DJLIMA1/FIAP-ChargeGridApp-GS1-2026/docs/api.md

# API ChargeGrid v1

Base `/v1`, JSON, UUIDs e datas UTC ISO 8601. Bearer JWT de pessoa nas rotas de domínio, logout e alteração de senha; cadastro, login, refresh, solicitação de recuperação e verificação por código são públicos com limite de tentativas. Sync usa `Authorization: Device <chave>`. Erro: `{"error":{"code":"point_unavailable","message":"Ponto indisponível"}}`. Validação retorna 422. Respostas de listas: `{"items":[],"total":0,"limit":50,"offset":0}`. `GET .../current` retorna recurso ou `null`.

Auth: POST `/auth/register` {email,password,name,account_type?:"consumer"|"vendor"}; `/auth/login` {email,password}; `/auth/refresh` {refresh_token}; `/auth/logout` com Bearer. O tipo de conta é escolhido no cadastro e o padrão para clientes antigos é `consumer`; login não recebe tipo. Cadastro novo sem confirmação pendente, login e refresh retornam `{access_token,refresh_token,expires_in,token_type:"bearer",user:{id,email}}`. Cadastro inclui `requires_email_confirmation`, calculado conforme a resposta do provedor: `false` com sessão imediata, `true` quando a conta depende de confirmação. Cadastro de e-mail já existente recebe resposta neutra sem sessão, sem afirmar que uma mensagem foi enviada. Senhas são preservadas exatamente, inclusive espaços; cadastro e nova senha exigem 8–128 caracteres, login aceita 1–128 para compatibilidade com contas legadas. O provedor pode recusar senhas fracas. Os endpoints `/auth/verify-email` e `/auth/resend-signup` permanecem compatíveis, embora o projeto atual não exija confirmação.

Recuperação: POST `/auth/password/forgot` {email} solicita e-mail com link; `/auth/password/reset` {email,code,password} mantém suporte a código OTP. O link padrão abre `/auth/confirmed`, fora da base `/v1`, que apresenta o formulário quando recebe `type=recovery` e o token no fragmento da URL. A página remove o fragmento imediatamente, mantém o token apenas em memória e chama POST `/auth/password/update` {password} com Bearer válido. Ambos os fluxos de redefinição revogam as sessões de atualização no provedor e pedem novo login. Tokens de acesso já emitidos podem permanecer válidos até sua expiração. A entrega de e-mail ainda depende do SMTP configurado no Supabase; indisponibilidade ou limite do provedor retornam erro, não uma confirmação falsa de envio.

`GET/PATCH /me`: `{id,name,account_type,phone,vehicle_description,operator_enabled,presentation_mode,created_at}`; PATCH aceita apenas name,phone,vehicle_description,presentation_mode. `presentation_mode` (bool, padrão `false`) é o *Modo apresentação* da conta, sincronizado pelo app ao alternar; no servidor ele só decide o método de pagamento do totem dos postos dessa conta (veja [Totem](#totem-de-autoatendimento-dispositivo)). `account_type` é persistido no primeiro acesso a partir dos metadados do cadastro e não é alterado por logins posteriores. Escolher `vendor` permite iniciar o vínculo por QR; somente a prova de posse de um equipamento habilita `operator_enabled`. Vendedores ainda sem equipamento podem usar recargas. Operadores e proprietários legados são preservados. `GET /me/summary`: `{month:"YYYY-MM",currency:"BRL",estimated_cost,energy_wh,sessions_count}` para sessões encerradas com carga no mês civil de São Paulo; custo é estimativa, não pagamento.

`GET /stations` filtros lat,lng,radius_km,limit,offset; `GET /stations/{id}`. Posto: `{id,owner_id,name,address,latitude,longitude,active,connectors:[]}`. `owner_id` pode ser null somente para equipamento de fábrica sem dono, que permanece inativo. Ponto: `{id,station_id,public_code,connector_type,power_kw,price_per_kwh,max_duration_minutes,active,control_version,available,online,physical_state,availability_status,reserved_until}`. `availability_status` usa `available`, `reserved`, `charging`, `offline`, `reconciling`, `disabled`, `fault` ou `occupied`; clientes não devem chamar todo ponto indisponível de ocupado.

A descoberta também aceita `connector_type`, `available_only` (padrão `false`), `max_price_per_kwh` (0 a 10000) e `sort=default|price|distance`. Distância exige `lat` e `lng` juntos e é calculada em linha reta, não como rota. Tipo de conector ignora caixa/separadores e reconhece aliases como `Tipo 2`/`Type-2` e `CCS`/`CCS2`. Filtros e ordenação são aplicados antes de `limit`/`offset`.

Cada item da listagem acrescenta `discovery: {point, matching_connector_ids, available_points, distance_km}`. `point` é o ponto elegível de menor tarifa no posto, ou `null` quando não há ponto elegível. Preço, potência, conector e estado apresentados em uma comparação devem vir desse mesmo ponto. O campo `connectors` original permanece completo; `matching_connector_ids` identifica quais atendem à comparação. Sem `available_only`, um ponto ocupado/offline pode ter a menor tarifa e deve manter seu estado explícito. `available_only` usa o estado reconciliado do serviço, não apenas a presença de um sinal recente. A disponibilidade continua sendo revalidada nas operações de reserva/início.

Consultas padrão e por distância sem filtros adicionais preservam paginação SQL. Comparações por tarifa/disponibilidade avaliam os estados dos candidatos após restringir os atributos estáticos no SQL; o custo cresce com a quantidade de pontos candidatos. Essa implementação atende o piloto, mas requer medição e otimização antes de expandir para catálogos grandes.
POST `/stations` {name,address,latitude,longitude} cria apenas um agrupamento do vendedor habilitado; PATCH aceita esses campos e active. POST `/stations/{id}/connectors` não cria mais equipamentos: responde 409 `claim_required`, orientando o vínculo por QR. PATCH `/connectors/{id}` mantém edição dos campos e active, apenas pelo proprietário e sem operação ativa.

## Propriedade por QR de fábrica

POST `/ownership/claim` {token,station_id?:UUID}, com Bearer de vendedor ou operador legado. `token` é o segredo aleatório base64url de 43 caracteres contido em `chargegrid://claim?token=...`; não é `public_code`, UUID nem chave de dispositivo. Resposta 200: `{station_id,connector_id,already_claimed,message}`. O segredo é enviado no corpo HTTPS, nunca na URL HTTP ou em logs.

O provisionamento administrativo cria um ponto com chave de dispositivo própria e um segredo de propriedade independente. O banco guarda somente SHA-256 dos dois. A primeira claim vincula o posto de fábrica ao vendedor ou, quando `station_id` é informado, adiciona o ponto a um posto que já pertence à mesma pessoa. Essa operação habilita a gestão do vendedor por prova de posse. Posto/ponto novos continuam inativos até revisão e ativação pelo dono. O QR deve ser entregue ao comprador, não publicado como QR de recarga.

Claims concorrentes são serializadas: mesmo dono pode repetir com segurança (`already_claimed:true`); outro dono recebe 409 `already_owned`. Um QR usado não transfere o ponto para outro posto (409 `already_claimed`), nem altera proprietários legados. Consumidor recebe 403 `vendor_required`; segredo desconhecido recebe 404 `invalid_claim`; posto de destino alheio recebe 404. Há limite persistente de 15 tentativas por usuário/minuto, inclusive falhas (429). Respostas públicas não incluem claim, token ou hash.

POST `/connectors/{id}/device`, `/devices/{id}/rotate-key`: `{device_id,device_key}` chave mostrada uma vez. POST `/devices/{id}/revoke`: `{revoked:true}`.

GET `/connectors/{id}/device`, exclusivo do proprietário habilitado do posto: `{device_id,connector_id,firmware_version,last_seen,online,physical_state,connected,reconciled}`. Permite reencontrar o dispositivo para manutenção, rotação ou revogação depois de fechar a tela; nunca devolve chave, hash ou segredo de propriedade. Retorna 404 quando não existe dispositivo ativo, inclusive após revogação, ou quando o ponto pertence a outro operador; consumidores e vendedores sem equipamento vinculado recebem 403. Provisionar/rotacionar uma chave de comunicação não muda o dono do ponto.

GET `/devices/{id}/factory-reset` consulta o estado da restauração, inclusive durante uma reserva/recarga, sem alterar o dispositivo. POST na mesma rota solicita a restauração e continua exigindo equipamento livre, online e firmware compatível. Comando expirado permite reativar o ponto ou renovar a credencial; um novo sync livre confirma sua disponibilidade. ACK tardio não executa a restauração. Restauração aplicada mantém o ponto antigo aposentado e exige novo vínculo por QR.

POST `/reservations` {connector_id}, header `Idempotency-Key` obrigatório; 202 reserva `{id,user_id,connector_id,status,created_at,confirmation_deadline,expires_at}`. Estados pending_device,confirmed,cancelling,cancelled,expired,consumed. GET `/reservations/current`; POST `/reservations/{id}/cancel` 202 mesma representação.

Todas as representações de reserva e sessão (criação, consulta individual/atual, cancelamento/parada e itens de histórico) incluem também `{station_id,station_name,station_address,connector:{id,public_code,connector_type,power_kw,price_per_kwh,max_duration_minutes}}`. Esse contexto usa os dados públicos atuais do ponto/posto e não inclui dono, dispositivo, chave, hash ou segredo. A tarifa contratada continua no `price_per_kwh` da sessão; a tarifa do ponto no contexto pode mudar depois. As rotas `/current` reconciliam expiração antes de retornar o estado e devolvem `null` se a operação deixou de estar ativa enquanto aguardavam o lock.

POST `/charging-sessions` {presence_code,public_code?:string,reservation_id?:UUID,coupon_code?:string,max_duration_minutes:30,max_cost?:decimal,soc_percent?:0–100,battery_kwh?:5–250,soc_source?:"simulated"|"phone"} Idempotency-Key obrigatório; 202 sessão. `presence_code` tem formato `#F` seguido de cinco dígitos, é exibido apenas no painel físico, muda a cada cinco minutos e é validado pela API no início da recarga. A reserva ou o `public_code` opcional identificam o ponto quando já foi selecionado; sem eles, a API procura o código temporário entre os postos e exige que o ponto disponível seja único. Código inválido, vencido ou ambíguo retorna 422; há limite de dez tentativas por usuário a cada cinco minutos. POST `/charging-sessions/{id}/stop` mesmo header, 202. GET `/charging-sessions/current`, `/{id}`, `/me/charging-sessions`, `/stations/{id}/charging-sessions` (proprietário). Sessão: `{id,user_id,connector_id,reservation_id,status,created_at,started_at,ended_at,max_duration_minutes,max_cost,price_per_kwh,discount_percent,energy_wh,soc_percent,start_soc_percent,battery_kwh,soc_source,source,last_measurement_at,cost_estimate,end_reason,online}`. Históricos são ordenados por `created_at` decrescente, com UUID apenas para desempate; registros antigos usam início/fim conhecido como data de criação aproximada. Estados starting,charging,stopping,completed,failed,interrupted. Uma tentativa que nunca iniciou termina como `failed`; reinicialização após início termina como `interrupted`. SoC ausente é null. GET `/operator/summary`: `{stations,total_sessions,total_energy_wh,total_estimated_cost}`.

GET `/operator/charging-sessions` lista o histórico de todos os postos do operador autenticado, com `limit`/`offset`, envelope paginado e a mesma representação contextual de sessão. Exige operador habilitado e filtra exclusivamente seus postos, em ordem decrescente de criação. Aqui e em `GET /stations/{id}/charging-sessions` (visões do vendedor), o `payment` da sessão ganha `channel` (`app` | `kiosk_qr` | `kiosk_totem`), como em `/owner/sessions`; o histórico do motorista (`/me/charging-sessions`) não muda.

GET `/coupons` filtro station_id; com `mine=true` (gestão do dono) cada cupom traz também `uses` (recargas iniciadas com o código nos postos do dono, sem as que falharam), `last_used_at` (início da mais recente ou null) e `discount_total_approx` (kWh × preço × % somados, string decimal; aproximado, sem o arredondamento do recibo). POST `/coupons/check` {code, connector_id} (motorista, antes de pagar/iniciar; 10 tentativas por 5 min → 429 `rate_limited`) → `{code, discount_percent, description, valid_until, station_id}` ou 422 `invalid_coupon` (mesma regra do início: ativo, não vencido, do dono do posto e válido para o posto), 404 se o ponto não existe; só mostra o desconto, que continua aplicado e travado pela API no `POST /payments` (`coupon_code`) ou no início. POST `/coupons` {code,description,discount_percent,station_id?:UUID,valid_until}; PATCH `/coupons/{id}` aceita description,discount_percent,valid_until,active. Cupom global vale somente nos postos de seu operador. Criar, alterar a validade ou reativar um cupom exige validade futura com fuso horário. Editar descrição/desconto ou desativar cupom vencido continua permitido sem reenviar a validade; campos omitidos permanecem intactos. Valores monetários serializados como strings decimais; nenhum pagamento real.

Idempotência reserva/início/parada: mesmo usuário/operação/chave/corpo devolve recurso original; corpo diferente retorna 409. Cancelamento é naturalmente idempotente. Sem contato por 45s proíbe novas autorizações. Reserva vence chegada 15 minutos após ACK (`RESERVATION_MINUTES`, o mesmo prazo exibido no app), confirmação 30s; expiração inicia liberação, disponibilidade só retorna após reconciliação física. Reiniciar o ESP32 não cancela uma reserva válida: a API reaplica a reserva com seu prazo original, sem estender o vencimento. Isso é diferente de uma recarga em andamento, que é interrompida com segurança após reboot.

## Bateria do carro (SoC) e bateria cheia

No início, `soc_percent` (SoC inicial do carro), `battery_kwh` (capacidade útil) e `soc_source` são opcionais; `soc_source` assume `simulated` quando só o SoC é informado. A sessão guarda `start_soc_percent` (fixo), `soc_percent` (atual, decimal string ou null), `battery_kwh` e `soc_source`. Clientes antigos sem esses campos continuam iguais (todos null). A chave de idempotência do início considera esses campos quando enviados.

- `simulated`: a cada medição do equipamento a API calcula `soc_percent = min(100, start_soc_percent + energy_wh/1000/battery_kwh*100)`; um SoC enviado pelo próprio equipamento prevalece.
- `phone` (Modo apresentação): POST `/charging-sessions/{id}/soc` {soc_percent:0–100}, somente o dono da sessão e com a sessão `starting`/`charging`. Atualiza o SoC atual (pode diminuir), muda `soc_source` para `phone` e devolve a sessão completa (200). Sessão de outra pessoa ou inexistente: 404; sessão `stopping`/encerrada: 409 `session_not_active`; corpo inválido: 422; limite de 60 chamadas/min por usuário (429). Em sessões `phone` o SoC do equipamento e a energia não alteram `soc_percent`.

Ao chegar a 100 % com a sessão ativa (energia derivada, equipamento ou `/soc`), a API faz o mesmo que uma parada solicitada: sessão `stopping`, `end_reason: "battery_full"` já registrado e um único `STOP` com `parameters.reason = "battery_full"`. Após a confirmação física a sessão termina `completed` com `end_reason: "battery_full"`, independentemente do motivo informado pelo equipamento. Chamadas repetidas não emitem nova parada. Detalhes do protocolo do equipamento em [esp32-protocol.md](esp32-protocol.md).

## Tarifa: base, por horário e por demanda

O dono define só dados base; o cálculo é do ChargeGrid (`chargegrid_core.pricing`, o mesmo na API e na conta demo do app). `GET /stations/{id}/pricing` (dono) devolve `{rules, status, connectors}`. `PUT /stations/{id}/pricing` grava `rules` validadas (`422 invalid_pricing` com a mensagem em pt-BR). O PUT é parcial: o corpo é aplicado campo a campo sobre as regras salvas, e o que não vier continua como está (o app 0.6.8 não conhece `schedule` e não o apaga).

- `demand`: `enabled`, `max_increase_percent` (0–100) e `sensitivity` (`low`/`medium`/`high`);
- `schedule` (**tarifação por horário**): `enabled` e `intervals` (até 12) `[{start, end, days, prices}]`. `start`/`end` em `HH:MM`, diferentes. `days` (0 = segunda, ao menos um) é o dia em que o horário **começa**: `Seg 22:00–06:00` vai de segunda à noite até terça de manhã, e domingo à noite continua na segunda. `prices` é a tarifa base de cada conector nesse horário (`{connector_id: "1.2000"}`, R$ 0 a R$ 100). Preços de conectores de outro posto são descartados. Horários não podem se sobrepor ("Os horários 18:00–21:00 e 20:00–22:00 se sobrepõem (Sáb)."). Fora dos horários, com a tarifação inativa ou para um conector sem preço no horário, vale `connectors.price_per_kwh`;
- `rotation`: taxa de permanência após a recarga — `enabled` (padrão `false`), `start_after_min` (tolerância, 0–1440 min, padrão 10), `interval_min` (1–1440, padrão 1 = por minuto), `amount` (R$ 0–100 por intervalo, padrão 1,00) e `max_amount` (teto, R$ 0–1000, padrão 30,00). Veja [Taxa de permanência](#taxa-de-permanência-overstay);
- `peak` (legado): o antigo "horário de pico". Continua aceito e devolvido para o app 0.6.8, mas **não entra mais no cálculo**; `status.peak_now` é sempre `false`. Regras antigas salvas no banco continuam válidas (sem `schedule`, vale o padrão: ativa e sem horários).

**Sinais medidos pelo servidor em cada posto:** conectores publicados e online; recargas ativas e reservas; ocupação média dos últimos 15 min, ponderada pelo tempo; recargas iniciadas na última hora; média de inícios no mesmo dia da semana e horário nas 4 semanas anteriores; e o horário local (`America/Sao_Paulo`, para a tarifação por horário).

**Cálculo da demanda:**
1. Ocupação combinada = 60% a de agora + 40% a média.
2. Abaixo de 50% de ocupação não há pressão.
3. A tendência compara a última hora com a média histórica, com suavização de Laplace.
4. Posto lotado com reserva aguardando soma pressão.
5. A sensibilidade curva a pressão.
6. Multiplicador = `1 + teto × pressão`, em passos de 0,05× para baixo. Abaixo de 1,05× fica 1×.

**Preço:** tarifa base do horário (ou base do conector) × multiplicador. O teto da demanda vale sobre a base do horário.

`status` traz `multiplier`, `increase_percent`, `pressure` (0–100), `level` (`low`/`normal`/`high`/`very_high`) com `level_label`, `factors`, `schedule_now` (o horário vigente com `index`, `start`, `end`, `days`, `prices`, ou `null`) e o motivo `reason`/`reason_label`: `demand_schedule` ("Alta demanda · Horário 22:00–06:00"; "Demanda muito alta" no nível `very_high`), `demand` ("Alta demanda"), `schedule` ("Horário 22:00–06:00") ou `normal` ("Preço normal"). Cada conector traz `base_price_per_kwh` (do conector), `current_base_price_per_kwh` (do horário) e `current_price_per_kwh` (× demanda).

**Para o motorista:** `GET /stations` e `GET /stations/{id}` trazem `demand` (`multiplier`, `level`, `level_label`, `increase_percent`, `reason`, `reason_label`). Em cada conector há `price_per_kwh` (base do conector), `current_base_price_per_kwh` e `dynamic_price_per_kwh` (base do horário × multiplicador). As regras do dono (`pricing`) e os preços dos horários não são públicos.

**Trava do preço:** o preço é travado como num app de corrida. `POST /reservations` grava `demand_multiplier`. A recarga daquela reserva usa esse multiplicador e a base do horário vigente em `reservations.created_at` (sem coluna nova; se o dono editar o horário durante os 15 min da reserva, vale a regra editada para aquele momento). Sem reserva, `POST /charging-sessions` usa a base do horário e o multiplicador de agora. A sessão guarda `base_price_per_kwh` (a base do horário), `demand_multiplier` e `price_per_kwh` = base × multiplicador. É esse preço que o totem recebe e que a API usa no custo, de modo que mudanças posteriores não alteram uma recarga em curso. A reserva (`GET /reservations/current`) mostra o preço travado quando ele difere da base do conector.

Migração `a7c2e9d4b6f1` (`apps/api/sql/migracao_a7c2e9d4b6f1.sql`). A tarifação por horário não precisa de migração: fica em `stations.pricing`.

**No app:** a tela **Tarifa** do posto mostra a tarifa atual, a tarifa base e o motivo (atualizada a cada 30 s). O cálculo (base do horário × demanda, nível, pressão e fatores) só aparece ao tocar em **Detalhes**. Abaixo ficam quatro entradas, sem campos na visão geral: **Tarifa base** (`R$ … /kWh` por conector), **Tarifação por horário** (lista, Status e editor de cada horário: início e fim pelo seletor do sistema, dias por botões e `R$ … /kWh` por conector), **Tarifa por demanda** (`até + … %`, sensibilidade e simulação) e **Taxa de rotatividade** (`… min`, `R$`). O voltar segue editor → lista de horários → Tarifa → posto; o antigo `page=peak` abre a Tarifa. O motorista vê "Demanda alta agora: tarifa 1,3× a base" ao escolher o conector quando há acréscimo de demanda; com só a tarifa do horário, o resumo do ponto mostra "(tarifa do horário)", nunca "demanda 1×". O resumo e a estimativa da recarga usam o preço dinâmico.

## Telas do posto no app (vendedor)

**Estações → posto** reúne tudo em uma lista de entradas, sem repetição:

- **Dados da estação:** nome, endereço com sugestões, status e o **totem de autoatendimento** (Ligado/Desligado em `kiosk_mode`, sem atualização otimista) com o status em uma linha: "Pagamento: Stripe (teste)", "Pagamento simulado (Modo apresentação)" ou o motivo de indisponível (Stripe não configurada no servidor, estação inativa), pelo `kiosk_status` do posto.
- **Carregadores** (antes "Conectores"; a entidade da API continua `connectors`): os pontos da estação, cada um um carregador GoodWe HCA G2 (simulado) com status próprio (Online/Offline/Aguardando a tela), separado do status da **tela da estação** (cartão "Telas da estação"). "Adicionar carregador" cria o próximo endereço ligado à mesma tela (inativo). Tela do carregador: identificação e dados até "Salvar alterações"; abaixo, "Carregador e tela" com o cartão do carregador (endereço com Salvar, última leitura, potência lida) e o da tela (online, papel, último contato, credencial/restauração só no ponto da tela). Ver "Estação (tela) e carregadores".
- **Potência** (mesmo padrão da Tarifa): cartão "Disponível para os carregadores" (`GET /stations/{id}/power` a cada 3 s) com uma régua só de leitura (margem da loja, carros em uso, livre, marcador do contratado), o limite contratado (o do dono ou o padrão), a **margem da loja (ESTIMATIVA)** e os carros; Rebalanceamento Ligado/Desligado (`PUT power-site`, ligado por padrão); por conector a potência configurada × efetiva (subtela: `PATCH /connectors/{id}` `power_limit_kw`); ajuste único **"Limites"**: régua 0→escala com três faixas de arrastar alinhadas a ela (loja mínimo–pico em âmbar listrado, limite contratado, máximo dos carregadores embaixo da parte verde), "Digitar valores" e o aviso, salvos num só `PUT power-site`. Não há consumo da loja ao vivo nem simulado: "reservamos o pico estimado o tempo todo". O painel web (`PowerCard`) tem a mesma seção.
- **Tarifa:** tarifa atual, base e motivo; tarifa base por conector, tarifação por horário, tarifa por demanda e taxa de rotatividade.

As páginas "Ao vivo", "Energia do estabelecimento" e "Pagamentos" saíram do app (rotas antigas caem no menu do posto). `GET /owner/live` continua na API para o painel web. Sem a página de Pagamentos, o pagamento do app é Stripe por padrão (simulado em Modo apresentação) e `prepay_required`/`kiosk_payments` ficam `false` (migração `a3e8c5d1f7b9`); a API ainda aceita os dois em `PATCH /stations/{id}`.

**Suas estações → Adicionar nova estação:** abre o vínculo que já cria um posto (QR da tela sem dono; na demo, equipamento simulado), depois Localização (nome e endereço com sugestões), Ponto e tarifa e Revisão; ao publicar, volta à lista com a estação nova.

O histórico do vendedor mostra, por sessão, o pagamento (rótulo, capturado e devolvido/liberado) e a permanência (minutos na vaga e taxa). No motorista, posto com `prepay_required` oferece só a Stripe (teste) na etapa de pagamento. Na conta demo, "Simular carros no posto (demo)" (na tela Potência) coloca motoristas fictícios carregando e na vaga, com o mesmo núcleo `chargegrid_core.balancing`/`site_load`/`overstay`.

Saíram "Configurações adicionais" e a antiga tela "Pontos e equipamentos". O preço por kWh existe só em **Tarifa**. Latitude e longitude não aparecem mais: o cadastro (onboarding e novo posto) e a edição do endereço gravam as coordenadas da sugestão escolhida ou da busca pela API própria. Em conta real, um endereço sem resultado é recusado com "Não encontramos este endereço…". Na demo, usa-se o centro de São Paulo.

## Código público do ponto

Pontos novos recebem um código curto: `CG-` + 4 caracteres sem 0/O e 1/I (`app.service.new_public_code`, ex.: `CG-L6MX`). Antes eram `CG-` + 12 hexadecimais. A migração `d1e8f3a2c7b5` encurta os códigos longos existentes; outros formatos (`CG-PAINEL-03`, códigos da demo) ficam iguais. O totem recebe o código novo na próxima sincronização.

## Fluxos do motorista no posto

A tela do posto mostra os conectores e dois botões; não lista mais os pontos nem o aviso do código #F, que ficava repetido.

- **Reservar estação** (`booking`, `kind=reserve`): conector → reserva (ponto guardado por 15 min a partir da confirmação do posto + taxa) → cobrança (tempo, valor ou autonomia) → potência → pagamento → revisar → **Confirmar reserva**. Em **Recarga Agendada**, o app mostra "Chegue até" e o botão **Cheguei: informar código**. Os horários fictícios (00:00, 00:30…) saíram, porque a API reserva a partir de agora.
- **Carregar agora** (`kind=now`): conector → cobrança → potência → pagamento → revisar → **Confirmar e iniciar no ponto** → código #F → início. Não há etapa de reserva nem taxa.

O plano da busca (por valor, tempo ou autonomia) chega ao assistente já preenchido.

## Autocomplete de endereço

`GET /geo/address-suggestions?q=<texto ou CEP>[&lat=&lng=]` (usuário autenticado, 60 consultas/min) devolve `{items:[{label,street,number,district,city,state,postcode,latitude,longitude,place?}],available,attribution}`. É um endpoint próprio, sem chave e sem custo: texto livre consulta o [Photon](https://photon.komoot.io) (geocodificador do OpenStreetMap feito para busca enquanto se digita; o Nominatim proíbe esse uso), limitado ao Brasil e com viés por `lat/lng`; um CEP de 8 dígitos consulta o [ViaCEP](https://viacep.com.br) e o Photon completa as coordenadas. `label` segue o formato dos endereços salvos (`Rua X, 123, Bairro, Cidade - UF`); se a rua vier sem número, o número digitado é aproveitado. Cache em memória (24 h; falha, 60 s), timeout de 2,5 s e falha silenciosa (`available: false`, lista vazia): o cadastro continua aceitando o texto digitado. Menos de 3 caracteres (e não CEP) não consulta ninguém. A interface mostra a atribuição exigida pelo OpenStreetMap.

Uso: app (cadastro da estação no onboarding e **Dados da estação**; espera 350 ms sem digitação, descarta respostas antigas; a localização do posto vem do endereço: da sugestão escolhida ou, sem escolha, da primeira sugestão da busca; o app não pede latitude/longitude) e painel web (**Dados da estação**: combobox acessível com ↑/↓, Enter e Esc; o **Salvar** envia endereço + coordenadas). A conta demo do app e o mock do painel respondem com endereços fixos de São Paulo, sem rede.

## Modo Motorista

`GET/PUT /driver/profile` (veículo e preferências de turno/refeições), `POST /driver/plan` {soc_percent,lat?,lng?,radius_km?,mode?:"auto"|"full_shift",vehicle?,preferences?,context?,live_signals?} e `POST /driver/next-stop` planejam recargas para motoristas de app com o motor `chargegrid_core.driver`. Postos expõem `amenities:[{kind,name,distance_m}]` (`restaurante`, `cafe`, `banheiro`, `shopping`, `conveniencia`), editáveis pelo dono em PATCH `/stations/{id}`. Demanda é estimativa; clima da Open-Meteo é opcional, com fallback silencioso e origem em `demand.source`/`demand.signals`. Detalhes em [modo-motorista.md](modo-motorista.md).

## Dashboard do proprietário (`/owner/*`)

Somente leitura, para contas com `operator_enabled` (senão 403). Escopo: postos cujo `owner_id` é o usuário; `station_id` opcional é validado como no restante da API (posto de outro dono → 404). Período: `from`/`to` ISO 8601 **com fuso** (padrão: últimos 7 dias; até 366 dias; `to` > `from`, senão 422 `invalid_period`). Valores decimais são strings. Fuso de relatório: `America/Sao_Paulo`. Cálculos em `chargegrid_core.analytics` (mesmos usados pela demo e pelo dashboard).

- `GET /owner/overview?from&to&station_id` → `{period, station_id, kpis:{revenue, energy_wh, energy_kwh, sessions, average_ticket, occupancy_percent, uptime_percent, reservations, no_shows, no_show_percent, interrupted_sessions, failed_sessions, active_sessions, points, points_online}, stations:{total, active, points, points_published, points_online}, ranking:[{connector_id, station_id, station_name, public_code, revenue, energy_kwh, sessions, occupancy_percent}], generated_at}`. Receita/energia/sessões: sessões `completed`/`interrupted` com energia > 0 e `ended_at` na janela (atribuição integral ao término). Ocupação: minutos com sessão iniciada (recortados na janela) ÷ (pontos publicados × minutos da janela). Disponibilidade: retrato atual de pontos publicados online (sem histórico de estados). Ticket médio/percentuais `null` quando não há denominador.
- `GET /owner/timeseries?metric=all|revenue|energy_kwh|sessions&granularity=hour|day` → `{granularity, timezone, basis:"ended_at", buckets:[ISO local], series:{revenue:[], energy_kwh:[], sessions:[]}}` com baldes vazios preenchidos; `hour` aceita até 31 dias.
- `GET /owner/heatmap` → `{days:["Seg"..."Dom"], hours:[0..23], cells:[[7×24]], max, peak_hours:[{hour, sessions}], basis:"started_at"}`.
- `GET /owner/sessions?status=a,b&q=&limit&offset` e `GET /owner/reservations?...` → páginas `{items,total,limit,offset}` filtradas por `created_at` na janela. Projeção sem identidade do motorista: sessão `{id, station_id, station_name, connector_id, public_code, status, created_at, started_at, ended_at, duration_minutes, energy_kwh, price_per_kwh, discount_percent, cost_estimate, source, end_reason}`; reserva `{id, station_id, station_name, connector_id, public_code, status, created_at, expires_at, no_show}` (`no_show` = `expired`). `q` busca nome do posto, código do ponto ou prefixo do ID.
- `GET /owner/export/sessions.csv|sessions.json|reservations.csv|reservations.json` com os mesmos filtros: CSV RFC 4180 (vírgula, decimal com ponto, UTF-8, cabeçalho em português, células com `= + - @` neutralizadas; as sessões terminam com as colunas `Canal` (App · QR do painel · Totem) e `Pagamento` (Simulado · Stripe (teste) · vazio sem pré-pagamento), acrescentadas no fim sem mudar as anteriores); JSON com envelope `{schema_version, dataset, generated_at, timezone, currency, units, filters, total, notes, items}`. `Cache-Control: no-store`, `Content-Disposition` com nome do arquivo. Acima de 10 000 linhas: 413 `export_too_large`.
- `GET /owner/alerts` → `{items:[{kind, severity, title, detail, station_id, connector_id, station_name, public_code, at}]}`; tipos `device_offline`, `device_fault`, `no_device`, `command_failed` (falhou/expirou nas últimas 24 h) e `point_idle` (publicado e online, sem recarga há 72 h).
- `GET /owner/live` → `{items:[ponto + {station_name, station_active, has_device, device_id, online, last_seen, firmware_version, physical_state, availability_status, reserved_until, retired, session:{id,status,started_at,energy_wh,cost_estimate,soc_percent,power_w,source,last_measurement_at}|null}]}`. `power_w` é a última telemetria da sessão. O estado segue as mesmas regras de `availability_status`, com número fixo de consultas; ponto travado por um pedido do totem fica `occupied` com `kiosk_in_use: true` ("Em uso no totem").

Ações de gestão continuam nos endpoints existentes (PATCH `/stations/{id}`, PATCH `/connectors/{id}`, `/coupons`, `/devices/*`). Índices de apoio: migração `a3f1c9d2e7b4`. Insights de IA: POST `/ai/owner-insights` (contrato `{summary, recommendations:[{title, detail, impact, kind}], generated_at, model}`); o dashboard trata 404/erro como estado vazio.

## Recibo explicável e resultado do dono

Uma regra para tudo (`chargegrid_core.economics` e `chargegrid_core.receipt`): o **valor cobrado** de uma sessão é `cost_estimate` arredondado ao centavo (meio para cima). Recibo, `/owner/overview` (receita, ranking e série somam o valor de cada sessão ao centavo), margem, CSV e PDF usam esse valor e fecham entre si. A captura do pagamento deve usar `economics.charged_amount`.

**Preço travado com motivo.** Ao reservar e ao iniciar, a API grava `price_terms` (JSONB, migração `b6d2f9a4c8e1`) com o mesmo cálculo que travou o preço: `locked_at`, `locked_by` (`reservation`/`start`), `connector_base_per_kwh`, `base_per_kwh`, `base_source` (`connector`/`schedule`) e `schedule_window`, `demand` (`multiplier`, `level_label`, `reason_label`, `factors`, `recorded`) e `coupon` (`code`, `discount_percent`). A sessão também copia do posto `energy_cost_per_kwh` e `platform_fee_percent`. Esses campos não aparecem nas respostas de sessão, reserva e posto (formato inalterado; o custo do dono nunca vai ao motorista) e não vão ao equipamento. Sessões anteriores não têm `price_terms`: o recibo diz "motivo não registrado".

**Motorista (só o titular; outra conta → 404; `Cache-Control: no-store`):**

- `GET /charging-sessions/{id}/receipt` → recibo `{schema:"chargegrid.receipt", schema_version:1, generated_at, final, session_id, number, labels, station, point, times, price, energy, charges, power, timeline, payment, overstay, extensions?}`. Contrato aditivo: seções novas entram como chaves novas e cada uma tem `status` (`available`/`pending`/`not_applicable`/`unavailable`). `price.lines` e `price.explanation` explicam base, horário, demanda (`1,3×` com o motivo e a ocupação no momento da trava) e cupom. `energy.confirmed_by_device` só é `true` com o evento `ended` da sincronização do equipamento e leitura final. `power.samples` (até 120 pontos de `telemetry_samples.power_w`) e `power.changes` (hoje o limite do início; a frente de rebalanceamento acrescenta as mudanças confirmadas). `charges` = energia antes do cupom, desconto, energia, permanência e total (`provisional` com a recarga ativa). `labels` traz `SIMULADO`, ambiente do pagamento e "Documento sem valor fiscal".
- `GET /charging-sessions/{id}/receipt.pdf` → o mesmo recibo em PDF.
- `GET /me/charging-sessions/export.csv|pdf?from&to` (padrão: 30 dias; até 366) → sessões do motorista com término no período; totais com a regra do `/me/summary` (encerradas com energia), somando o valor de cada sessão ao centavo. Acima de 10 000: 413 `export_too_large`.

**Dono (operador; posto de outro dono → 404; `no-store`):**

- `GET /stations/{id}/economics` → `{station_id, energy_cost_per_kwh|null, platform_fee_percent, fee_editable:false, currency, notes}`. `PUT` com `{"energy_cost_per_kwh": "0,85"|null}` (R$ 0 a R$ 100, 4 casas; `null` = não informado). Erros 422: `invalid_economics`; `fee_read_only` ao enviar `platform_fee_percent`. A comissão (padrão 25 %) é de contrato: só leitura no painel, alterada pelo administrador com `tools/set_platform_fee.py <station_id> --percent 20 [--apply]` (credencial em `MIGRATION_DATABASE_URL`). Vale para as próximas recargas.
- `GET /owner/margin?from&to&station_id&limit&offset` → `{schema_version, period, basis:"ended_at", currency, station_id, stations:[config por posto], totals, dynamic_pricing:{demand_effect, schedule_effect, sessions_with_increase, average_multiplier}, coupons:{sessions, discount}, sources, by_station, warnings, methodology, items, total, limit, offset}`. Mesmas sessões da receita do overview. Por sessão: `gross` (antes do cupom) = `list_value` + `schedule_effect` + `demand_effect`; `discount`; `revenue` (energia); `overstay_revenue`; `revenue_total`; `platform_fee` (sobre o valor cobrado depois do cupom, com permanência); `provider_fee`; `owner_net` (repasse); `energy_cost` (kWh × custo travado no início, ou o atual do posto com `cost_basis:"current"` para recargas antigas); `margin` e `margin_percent`. **Receita bruta não é lucro**: sem custo informado, `energy_cost`/`margin` são `null` (nunca zero) e `totals.margin` é `null` com `margin_covered` e `coverage`. Totais = soma das linhas ao centavo; a paginação só recorta `items`.
- `GET /owner/export/margin.csv|pdf` com os mesmos filtros → mesma agregação (CSV sem linhas de total, protegido contra fórmulas; PDF com a cascata receita → comissão → repasse → custo → margem, efeitos do preço dinâmico e cupons, por posto, até 1 000 recargas no detalhe e método). Canal e método da recarga (totem 0.8.0): colunas `Canal`/`Pagamento` no fim do CSV, coluna `Canal` no fim da tabela do PDF e `payment_channel`/`payment_method` em cada item de `/owner/margin`. Acima de 10 000 sessões: 413.

**Extensões das outras frentes** (`app/modules/receipts/registry.py`): `register_extras("payment"|"overstay", batch)` alimenta recibo e margem (pagamento confirmado: `net_amount` substitui a estimativa e `provider_fee` entra no repasse; permanência entra na receita e na comissão); `register_section("power_changes", provider)` alimenta `power.changes`. Um provedor com erro não derruba o recibo.

Provedores ligados no app (`app/main.py`):

- **Pagamento** (`app/modules/payments/receipt.py`): só pagamentos confirmados pela Stripe (teste). `environment` gravado como `test` aparece como `sandbox`. Antes do acerto: `payment` presente, `net_amount = null`, valores estimados. Depois do acerto: `net_amount` = capturado − devolvido, `provider_fee` da Stripe; no recibo `charges.total = charges.paid_total` (o capturado manda), `charges.calculated_total` = energia + permanência pela mesma regra de centavos da captura, `charges.difference` = pago − calculado e `charges.adjustments` (`waived`, `below_minimum`, `uncollected`, `overstay`, `other`) explicam a diferença; na margem `revenue_basis = "captured"`. `receipt.payment.status` é o estado da seção (`available`); o estado do pagamento vai em `payment_status`.
- **Potência** (`app/modules/power/receipt.py`): `power.changes` vem dos eventos `power_requested`/`power_applied`/`power_failed`, casados pelo comando. `status = "applied"` só com o ACK do equipamento; `failed` com `failure_code`; sem resposta fica `requested`. Campos extras: `direction`, `previous_kw`, `attempt`, `decision_id`. `power.applied_limits` = degraus `{t, kw}` das mudanças aplicadas. Posto sem rebalanceamento ao vivo mantém o limite do início.

PDFs com ReportLab (`reportlab>=5.0.1`), importado só nas rotas de PDF (recibo ~0,2 s; margem com 1 000 linhas ~1 s). Fonte Helvetica (WinAnsi).

## Previsão de ocupação (`/owner/forecast`, `/stations/{id}/best-times`)

Detalhes do método, dados e métricas: [previsao-ocupacao.md](previsao-ocupacao.md). Somente leitura; `Cache-Control: no-store`; horários em ISO 8601 com `-03:00`.

- `GET /owner/forecast?station_id&horizon_hours=1..36` (dono do posto; 30/min) → `{station_id, generated_at, timezone, as_of, horizon_hours, connectors, status:"ok"|"no_history", method:"gbm"|"baseline", method_reason, model:{version, trained_on, library, selected, offline_test:{period, baseline, gbm, daily, unseen_stations}}, coverage:{days_measured, days_synthetic, first_hour}, includes_synthetic, notes[], accuracy:{window_days, origins, status:"ok"|"insufficient_history", baseline:{mae_pp, wape, accuracy_percent}, gbm, daily:{baseline|gbm:{peak_days, peak_hit_percent, energy_day_wape, energy_day_accuracy_percent}}}, band, energy_basis, hours:[{start, occupancy_percent, baseline_percent, low_percent|null, high_percent|null, energy_kwh, expected_multiplier, full}], peaks:[{start, end, max_percent, label}], idle:[{start, end, min_percent, label}], suggestions:[{kind:"enable_demand"|"raise_demand_cap"|"schedule_peak"|"schedule_idle", title, detail, window, action:{type:"pricing_rules", patch, preview?:[{connector_id, public_code, from, to}]}}]}`. `patch` é aplicado pelo `PUT /stations/{id}/pricing` existente (PUT parcial). O modelo só entra quando vence a média no teste offline e no backtest de 14 dias do posto.
- `GET /owner/occupancy-history?station_id&weeks=1..8` → `{days, hours, occupancy_percent:[[7×24]], energy_kwh:[[7×24]], samples:[[7×24]], max_occupancy_percent, from, to, coverage, includes_synthetic, notes}` (média por dia da semana e hora; `null` = sem dados).
- `GET /stations/{station_id}/best-times?hours=3..24` (qualquer usuário autenticado, posto ativo; 60/min) → `{hours:[{start, expected_price_per_kwh, level, level_label}], best:{start, end, price_from, saving_vs_now_percent|null, reason, level_label}, now:{price_per_kwh}, stable, note, method, generated_for, timezone, includes_synthetic}`. Preço esperado = tarifa do horário × multiplicador previsto; sempre "Estimativa", travado ao reservar/iniciar. Sem números de ocupação do dono.
- Agregados duráveis: `connector_hourly_stats` e `aggregate_watermarks` (migração `c5f0a7e3d912`); rollup idempotente dentro de `/internal/keepalive` (resposta `{status, rollup:{from, to, rows}|{status:"failed"}}`). `tools/maintenance.py` só apaga telemetria já agregada.

## Assistente de IA

Rotas autenticadas (Bearer). A chave do OpenRouter fica somente no backend. As ferramentas da IA apenas **leem** dados do
usuário autenticado e nunca reservam, iniciam ou cobram. Os limites são compartilhados por todas as rotas de IA: 20
pedidos a cada 10 minutos e 200 por dia por usuário, além de um teto global diário. Ao exceder, a resposta é 429
`ai_rate_limited`. O uso é registrado em `ai_usage` apenas com metadados: tokens, custo, latência, modelo e nomes das
ferramentas. Detalhes e escolha do modelo em [ia-openrouter.md](ia-openrouter.md).

POST `/ai/chat`

Corpo: `{messages:[{role:"user"|"assistant",content:string≤2000}] (1–12, a última do usuário), context?:{mode:"driver"|"owner",screen?:string,lat?:number,lng?:number}}`.

Resposta 200: `{reply,suggested_actions,tools_used,model}`. Cada item de `suggested_actions` tem o formato
`{type,label,station_id?,connector_id?,session_id?}`, com `type` entre `open_station`, `reserve`, `open_reservation`,
`open_charging`, `open_history`, `open_operator`, `search_stations` e `open_driver`. O app abre a tela correspondente,
e a ação com efeito segue o fluxo normal, com confirmação. As ferramentas de dono só ficam disponíveis com
`operator_enabled`.

Erros: 503 `ai_unavailable`/`ai_busy`/`ai_quota` (IA desligada ou provedor indisponível; não há troca para modelo caro),
504 `ai_timeout` e 422 para histórico inválido.

POST `/ai/search`

Corpo: `{query:string 2–300, lat?, lng?}`. Converte a busca em linguagem natural em filtros estruturados.

Resposta 200: `{filters:{near?:{label,lat,lng},radius_km?,text?,connector_type?,min_power_kw?,max_price_per_kwh?,available_only?,sort?,amenities?},unsupported:[string],explanation,params,model}`.
`params` traz os parâmetros da tela/`GET /stations` (`lat,lng,radius,connector_type,max_price_per_kwh,available_only,sort`).
Sem IA, ou se ela falhar, responde por regras com `model:"chargegrid-regras"`.

POST `/ai/session-insight`

Corpo: `{session_id}`. Só aceita sessões do próprio usuário; para as demais, a resposta é 404. Sessões ainda não encerradas (diferentes de `completed`/`interrupted`) recebem 409 `session_not_finished`.

Resposta 200: `{session_id,summary,tips:[string],comparison:{cost_brl,energy_kwh,price_per_kwh,avg_cost_brl,avg_price_per_kwh,cost_vs_avg_percent,peak_hour,history_sessions},generated_at,model}`.

POST `/ai/owner-insights`

Exige operador habilitado; caso contrário, 403. Corpo opcional, o mesmo filtro do dashboard:
`{from?:ISO-8601, to?:ISO-8601, station_id?:UUID, days?:1–366}`. Sem `from`, analisa os últimos `days` dias (padrão 30)
até `to` ou agora; janela inválida → 422 `invalid_period`; posto de outro dono → 404. **Contrato estável, consumido pelo
dashboard web:**

```json
{"summary": "string",
 "recommendations": [{"title": "string", "detail": "string", "impact": "high|medium|low",
                      "kind": "pricing|operations|marketing"}],
 "generated_at": "ISO-8601 UTC",
 "model": "deepseek/deepseek-v4.1-flash | chargegrid-regras"}
```

Os indicadores são os mesmos de `/owner/overview`, `/owner/heatmap` e `/owner/alerts` (`chargegrid_core.analytics`):
receita e energia estimadas, ticket médio, ocupação, disponibilidade, interrupções/falhas, no-show de reservas,
sessões por hora e alertas de pontos. A IA apenas redige a partir desses números (sem raciocínio estendido, ~2–5 s).
Se a resposta da IA for inválida ou indisponível, a rota devolve as recomendações por regras.

## Pagamento pré-pago (Stripe em modo teste)

Teto pré-pago: o motorista aceita um orçamento → a API cria a cobrança no valor do **teto** → a Stripe pré-autoriza (cartão) ou cobra (Pix, se ativado no Dashboard) → **só depois da confirmação** o START pode ser emitido → no fim, a energia confirmada pelo equipamento define o valor: cartão captura só o consumido e libera o resto; Pix devolve a diferença (refund parcial). O ambiente é sempre `test` e toda resposta/página diz isso; uma chave que não seja `sk_test_`/`rk_test_` desliga os pagamentos. Regras de centavos em `chargegrid_core.billing`.

**Configuração (env, só no servidor):** `STRIPE_SECRET_KEY` (teste), `STRIPE_WEBHOOK_SECRET` (`whsec_...` do endpoint), `PUBLIC_BASE_URL` (URL pública desta API, usada no retorno da Checkout e no QR do painel; nunca `chargegrid-api.vercel.app`), opcional `STRIPE_METHODS=card` ou `card,pix` (informativo), `PAYMENTS_START_WINDOW_MINUTES=15`, `PAYMENTS_KIOSK_START_MINUTES=10`. Webhook no Dashboard da Stripe (modo teste) em `{PUBLIC_BASE_URL}/v1/webhooks/stripe` com os eventos `checkout.session.completed`, `checkout.session.async_payment_succeeded`, `checkout.session.async_payment_failed`, `checkout.session.expired`, `payment_intent.amount_capturable_updated`, `payment_intent.succeeded`, `payment_intent.payment_failed`, `payment_intent.canceled`, `charge.refunded`.

**Comportamento do posto (vendedor, PATCH `/stations/{id}`):** `prepay_required` (o START exige pagamento confirmado quando a tarifa base é > 0) e `kiosk_payments` (QR de pagamento no painel físico). Ambos `false` por padrão (e zerados pela migração `a3e8c5d1f7b9`; o app não tem interruptor para eles, só o painel web); ficam visíveis em `GET /stations`; `kiosk_mode` liga o [totem de autoatendimento](#totem-de-autoatendimento-dispositivo) (também `false`).

- `GET /payments/config` → `{enabled, provider:"stripe", environment:"test", currency:"BRL", methods, min_amount:"0.50", kiosk_amounts:["10.00","20.00","40.00"], test_card}`.
- `POST /payments` (Bearer, `Idempotency-Key`, 10 por 5 min) `{connector_id, mode:"time"|"value"|"energy", minutes?, max_cost?, energy_kwh?, max_power_kw?, coupon_code?}` → 201 pagamento. O teto é calculado pela API com a tarifa vigente (`locked_terms`: base do horário × demanda, ou os termos da reserva confirmada da pessoa neste ponto), cupom e potência efetiva; a explicação do preço do recibo (com o cupom) fica travada em `quote.price_terms`; o valor do cliente nunca vira teto. Abre a Checkout hospedada (`checkout_url`, 30 min) com `payment_method_options.card.capture_method=manual`. Um pagamento do app em aberto por pessoa: um anterior ainda não pago é cancelado; um confirmado sem uso → 409 `payment_open_exists`. Erros: 503 `payments_unavailable`, 422 `invalid_quote` (mínimo R$ 0,50), 422 `invalid_coupon`, 502 `payment_provider_error` (repetir com a mesma chave reaproveita o pagamento).
- `GET /payments/current` → último pagamento do app em aberto/em uso ou `null`. `GET /payments/{id}` (só o titular). Ambos fazem o avanço preguiçoso: verificação na Stripe (no máximo a cada 3 s; alternativa ao webhook), expiração, acerto devido.
- `POST /payments/{id}/cancel` antes do START: Checkout expirada, autorização liberada ou Pix devolvido; em uso → 409 `payment_in_use`.
- `POST /webhooks/stripe` (sem Bearer; `Stripe-Signature` HMAC-SHA256, tolerância 5 min; corpo até 64 KB). Assinatura inválida/ausente/antiga → 400 sem efeito; segredo ausente → 503. Eventos deduplicados por `id` (`payment_events`, sem guardar o corpo); eventos de PaymentIntent são aplicados sem nova consulta e **só avançam** o estado (evento antigo não regride); Checkout concluída consulta o PaymentIntent (Stripe fora → 503 para a Stripe repetir).

**Pagamento:** `{id, status, status_label, environment:"test", provider, origin:"app"|"kiosk", method:"card"|"pix"|null, currency, amount, energy_cap, fixed_fee, overstay_reserve, price_per_kwh, base_price_per_kwh, demand_multiplier, discount_percent, coupon_code, max_duration_minutes, max_power_kw, connector_id, session_id, checkout_url (só enquanto aguarda), expires_at, start_deadline, authorized_at, created_at, quote, provider_ref:"pi_..."|null, settlement}`. `settlement` (null até o fim): `{status:"due"|"settling"|"done"|"failed", energy_amount, overstay_amount, fixed_fee, charged, returned, return_kind:"released"|"refunded", captured, refunded, waived, uncollected, below_minimum, provider_fee, settled_at}`. Valores em strings decimais de reais.

| `status` | Rótulo | Observação |
| --- | --- | --- |
| `awaiting_payment` | Aguardando pagamento | Checkout aberta |
| `declined` | Recusado | Não é final: a pessoa pode tentar outro cartão na mesma Checkout |
| `authorized` / `paid` | Pago (teste) | Cartão pré-autorizado / Pix cobrado; prazo de início `start_deadline` (15 min app, 10 min painel) |
| `in_use` | Pago (teste) · em uso | Ligado a uma sessão |
| `completed` | Cobrado R$ X (teste) · Devolvido R$ Y / Devolvido (teste) | Acerto concluído |
| `expired` / `canceled` | Expirado / Cancelado (· valor devolvido) | Nada inicia; o que foi autorizado/cobrado volta inteiro |

**START:** `POST /charging-sessions` aceita `payment_id`. Sob trava (perfil → ponto → pagamento) exige titular, mesmo ponto, pagamento confirmado, não usado e dentro do prazo; a sessão usa os termos travados no orçamento (preço, desconto e `price_terms` do recibo), `max_cost` = teto de energia (o painel para sozinho em `cost_limit`), duração e potência do orçamento. Erros: 402 `payment_required` (posto exige e não veio pagamento), 404 `payment_not_found`, 409 `payment_not_ready`, `payment_expired`, `payment_mismatch`, `payment_used`. A sessão (e históricos) ganha `payment` (o pagamento acima ou `null`); `/owner/sessions` ganha `payment` sem `checkout_url`, `coupon_code` e `quote`.

**Acerto:** quando a sessão termina, o sync do equipamento só calcula no banco (`settlement_status=due`), nunca chama a Stripe. A captura/cancelamento/refund acontece no próximo avanço (GET do app, página do painel, webhook ou o cron diário `/internal/keepalive`), com `Idempotency-Key` por pagamento e leitura do estado real do PaymentIntent antes de agir; repetir após timeout é seguro (5 falhas → `failed`, “Em revisão”). Regras: nunca acima do autorizado (excesso de energia → `waived`; permanência além da reserva → `uncollected`); cobrança positiva abaixo de R$ 0,50 é perdoada (`below_minimum`); START que nunca começou devolve tudo; autorização sem uso expira no prazo e é liberada; pagamento que chega depois de expirar/cancelar é devolvido. A taxa de permanência entra pela interface `app/modules/payments/overstay.py` (`overstay_terms` soma a reserva ao teto; `overstay_charge` → `(centavos, final)`; o acerto espera `final`); implementada pela frente de permanência (veja [Taxa de permanência](#taxa-de-permanência-overstay)).

**Painel físico (sem app), páginas HTML fora de `/v1`:** `GET /pay/k/{public_code}?c=<5 dígitos do #F>` confere o código atual do painel (presença), `kiosk_payments` e a Stripe, e mostra R$ 10/20/40; `POST` cria o pagamento de um perfil convidado por ponto (“Visitante do painel CG-XXXX”) e redireciona à Checkout (10 por 5 min por ponto; ponto ocupado → 409). Confirmado o pagamento, o servidor emite START uma vez; ponto momentaneamente indisponível mantém o pagamento até o prazo e depois devolve. `GET /pay/s/{id}?t=<token>` mostra status, energia, “Encerrar recarga” (`POST /pay/s/{id}/stop`) e o valor cobrado/devolvido, atualizando a cada 3 s. `GET /pay/return?p=<id>` é o retorno da Checkout aberta pelo app: só informa (quem confirma é o servidor). As páginas usam CSP restritiva e não guardam e-mail ou cartão (ficam na Stripe).

**Migração `e5a1c7f3b9d2`** (sobre `b6d2f9a4c8e1`, SQL offline em `apps/api/sql/migracao_e5a1c7f3b9d2.sql`): `payments` (centavos inteiros, `environment='test'`, CHECKs de valores e estados, índice único de um pagamento do app em aberto por pessoa), `payment_events` (deduplicação) e `stations.prepay_required`/`kiosk_payments`. RLS e grants somente para `chargegrid_api`, revogando `PUBLIC`/`anon`/`authenticated`. Aditiva; sessões antigas ficam com `payment=null`.

## Totem de autoatendimento (dispositivo)

Contrato completo (sync, telas e estados) em [`esp32-protocol.md` · Totem 0.8.0](esp32-protocol.md#totem-080-autoatendimento-sem-celular); aqui o resumo da API (módulo `app/modules/kiosk_totem`, migração `f4b9d2c7e1a3`).

**Ligar:** `PATCH /stations/{id}` `{kiosk_mode: true}` (vendedor; padrão `false`, visível em `GET /stations`, `/operator/stations` e `/stations/{id}`). Desligado, nada muda no sync e os endpoints respondem `404 kiosk_disabled`. Na visão do dono, o posto traz `kiosk_status: {method: "simulated"|"stripe"|null, label: "SIMULADO"|"TESTE"|null, reason: "payments_unavailable"|"point_disabled"|null, reason_label}`: o método que o totem usa (ou usaria, com `kiosk_mode` desligado), pela mesma regra do `connector.kiosk` do sync, para app e painel web não deduzirem.

**Método decidido pelo servidor**, pelo modo da conta do **dono** do posto (`profiles.presentation_mode`): `true` → `simulated` (rótulo `SIMULADO`; pagamento `provider: "simulated"`, confirmado na hora e acertado localmente, sem nenhuma chamada à Stripe; funciona sem `STRIPE_SECRET_KEY`); `false` → `stripe` (rótulo `TESTE`; QR do pedido → Checkout hospedada, pré-autorização, captura parcial e devolução como no app). Conta oficial sem Stripe configurada → totem indisponível (`enabled: false`, `reason: "payments_unavailable"`). O dispositivo não escolhe o método: pedir outro → `409 method_mismatch`.

**Endpoints** (só `Authorization: Device <chave>`; sempre o ponto da chave; pedido de outro ponto → 404; Bearer → 401). Todos chamam os serviços do app com o perfil convidado do ponto (`payments.service.guest_profile`), sem regra duplicada:

| Rota | Limite | O que faz |
| --- | --- | --- |
| `GET /devices/kiosk/offer` | 30/min | ativo, método/rótulo, disponibilidade (`reason`), tarifa atual + motivo, atalhos (R$ 10/20/40/60, 15/30/60 min, 5/10/20 kWh), mín/máx por modo (teto R$ 200 no total), termos de permanência |
| `POST /devices/kiosk/quote` | 30/min | `{mode, amount\|minutes\|energy_kwh}` → `payments.service.quote` + `quote_hash` |
| `POST /devices/kiosk/orders` | 6 / 5 min, `Idempotency-Key` | `{quote_hash, mode, valor, overstay_terms_version}` → recalcula (diferente → `409 quote_changed` com `quote` novo), cria o pedido `held` e trava o ponto 5 min |
| `POST /devices/kiosk/orders/{id}/pay` | 10 / 5 min, `Idempotency-Key` | simulado: pago e START na hora (`start_kiosk`); Stripe: Checkout + `payment.qr_url` (`/pay/o/{id}?t=`, ≤160), trava 10 min |
| `POST /devices/kiosk/orders/{id}/cancel` | 20 / 5 min | antes do START: libera a trava e devolve/libera tudo; depois → `409 order_in_use` |
| `GET /devices/kiosk/orders/{id}` | 120/min | status, sessão, pagamento, resumo do recibo, `receipt_url`; renova a trava `held` |

**Pedido:** `{id, status: held|awaiting_payment|paid|charging|finished|canceled|expired|failed, status_label, method, label, expires_at, expires_in_seconds, quote{mode, amount, minutes, energy_kwh, total, energy_cap, overstay_reserve, price_per_kwh, estimated_energy_kwh, max_duration_minutes}, payment{id, status, label, method, amount, qr_url}|null, session_id, session{status, energy_kwh, cost, started_at, ended_at, end_reason}|null, receipt{number, energy_kwh, total, returned, return_kind: released|refunded|simulated, final, end_reason, end_reason_label, url}|null, receipt_url, error{code,message}|null}`.

**Erros:** `404 kiosk_disabled`, `404 not_found`, `401 unauthorized`, `409 point_unavailable` (+ `reason`: `kiosk_in_use`, `reserved`, `charging`, `occupied`, `reconciling`, `offline`, `fault`, `disabled`), `409 order_open` (+ `order_id`), `409 quote_changed` (+ `quote`), `409 overstay_terms_changed`, `409 order_not_payable`, `409 order_expired`, `409 order_in_use`, `409 method_mismatch`, `409 method_changed`, `409 method_unavailable` (`voucher` e `card_terminal`: reservados, ocultos), `422 invalid_quote`, `422 amount_below_minimum` (R$ 5,00 · 5 min · 1,0 kWh), `422 amount_above_limit` (total > R$ 200), `422 idempotency_key_required`, `409 idempotency_conflict`, `429 rate_limited`, `503 payments_unavailable`, `502 payment_provider_error`.

**Trava do ponto (exclusão mútua com o app):** pedido aceito → linha `kiosk_orders` aberta com `expires_at` (5 min renovável por `GET`/`pay`; 10 min com o QR da Stripe; `paid` até o prazo de início). Enquanto vale, a disponibilidade do ponto é `occupied` com `kiosk_in_use: true` (campo aditivo de todo ponto em `GET /stations`), e `POST /reservations`, `POST /charging-sessions` e o QR `/pay/k` respondem `409 point_unavailable` com `reason: "kiosk_in_use"` ("Ponto em uso no totem"). A mesma trava do ponto (`lock_point`) serializa a criação do pedido e o `start()`. Trava vencida libera na hora; pagamento que chegar depois é devolvido inteiro.

**Sync (aditivo, só resposta):** `connector.kiosk {enabled, method, label, reason}` e `kiosk_order` (pedido mais recente, até 10 min depois de fechar) só com o totem ligado; `authorized.session.origin` (`app` | `kiosk_qr` | `kiosk_totem`) sempre. O sync avança só o pedido do totem aberto (sem Stripe dentro da trava; a verificação na Stripe, no máximo a cada 3 s, roda depois de gravar o sync). `sync_interval_seconds` = 1 com pedido aberto. O bloco `connector.payment` (QR `/pay/k`) não mostra pagamentos de pedidos do totem.

**Visitante:** `GET /pay/o/{order_id}?t=` (QR Stripe → Checkout), `GET /pay/r/{order_id}?t=` (status + recibo HTML, de `receipts.service`) e `GET /pay/r/{order_id}.pdf?t=` (PDF). Token de 24 bytes por pedido, só pela chave do dispositivo; o banco guarda sal + hash. Simulado sai rotulado SIMULADO (`payment.environment = "mock"` no recibo, rótulos "(simulado)" no pagamento e no painel do vendedor).

**Pagamento simulado:** mesma tabela `payments` (`origin: "kiosk"`, `provider: "simulated"`, `method: "simulated"`, `environment: "test"`); `status` vai direto a `paid`; o acerto (`settle`) é local: `captured = charge`, `refunded = 0`, sem provedor. `GET /owner/sessions` acrescenta `payment.channel` (`app` | `kiosk_qr` | `kiosk_totem`).

**Migração `f4b9d2c7e1a3`** (sobre `c8e3a5f2d914`, SQL offline em `apps/api/sql/migracao_f4b9d2c7e1a3.sql`): `profiles.presentation_mode`, `stations.kiosk_mode` (ambos `false`) e `kiosk_orders` (estados, método, modo, termos travados, `quote_hash`, trava `expires_at`, sal/hash do token, um pedido aberto por ponto por índice único parcial). RLS e grants só para `chargegrid_api`, revogando `PUBLIC`/`anon`/`authenticated`. Aditiva.

## Taxa de permanência (overstay)

"Carga encerrada" e "veículo desconectado" são fatos distintos. A recarga termina como sempre (sessão `completed`, evento `ended`); se o equipamento ainda relata `connected=true` no mesmo sync, abre-se a **permanência**, que só termina quando o cabo é desconectado. Cálculo em `chargegrid_core.overstay`; tudo em `Decimal`.

**Regra do dono:** `rotation` em `PUT /stations/{id}/pricing` (padrão desligada; 10 min de tolerância, R$ 1,00/min, teto R$ 30,00). A migração `c8e3a5f2d914` desliga regras `rotation` antigas sem `max_amount` (eram "registradas, não cobradas").

**Termos aceitos antes do início:** `GET /stations` e `/stations/{id}` trazem `overstay: {enabled, grace_minutes, interval_minutes, amount, max_amount, fee_per_minute, version, summary}` (`summary`: "Após a recarga: 10 min de tolerância; depois R$ 1,00 por minuto, até R$ 30,00."). O app mostra e envia `overstay_terms_version` em `POST /charging-sessions`; a sessão guarda a cópia dos termos (mudanças posteriores do dono não a afetam). Versão diferente da vigente → 409 `overstay_terms_changed`. Sem versão (app antigo, início só pelo código #F) → recarga **sem taxa**; o intervalo conectado é registrado com status `no_fee`. Pré-pago: valem os termos travados no orçamento (`quote.overstay`) e o **teto da taxa é reservado na autorização** (`overstay_reserve`).

**Contagem (só no sync do equipamento, sem tarefa de fundo):** início = hora do servidor do sync que confirmou o fim com o cabo conectado (sem retroagir). Cada sync aceito com `connected=true` soma o tempo desde a última evidência, até 45 s; intervalo maior não é cobrado (evento `overstay_gap`); repetições de sync não somam. Taxa = `min(teto, valor × intervalos completos após a tolerância)` sobre os segundos confirmados (minuto incompleto não é cobrado). Fecha com `disconnected` (primeiro sync com `connected=false`), `device_reboot` (boot novo; cobra até a última evidência) ou `observation_lost` (equipamento sem notícia por 15 min, verificado sob a trava do ponto). `failed`/`interrupted` não abrem permanência. Pausa a 0 kW do rebalanceamento não é fim de recarga. Com o cabo conectado o ponto continua `occupied` e não aceita reserva nem início.

**Sessão** (todas as representações): as colunas internas saem e entra `overstay: {status: none|no_fee|grace|billing|capped|closed, fee_applies, started_at, ended_at, end_reason, billable_seconds, billable_minutes, grace_remaining_seconds, fee_due, max_fee, as_of, terms}` e `settlement_ready` (o valor final não muda mais: sessão encerrada e permanência ausente, fechada, sem taxa aceita ou no teto).

- `GET /overstays/current` (motorista) → `{station_id, station_name, station_address, connector, session_id, ended_at, ...bloco overstay}` da permanência aberta, ou `null`.
- `GET /owner/live`: cada ponto ganha `occupancy: {session_id, status, started_at, grace_remaining_seconds, billable_minutes, fee_due, max_fee, fee_applies, driver_label, as_of}` ou `null`. `driver_label` = primeiro nome + veículo informado (sem e-mail/telefone).
- `/owner/sessions` e exportações: `overstay_minutes` e `overstay_fee` (CSV: "Permanência cobrada (min)", "Taxa de permanência (R$)").
- Recibo e margem: seção `overstay` registrada em `receipts.registry` (`{phase, grace_minutes, started_at, ended_at, end_reason, billable_minutes, rate, max_amount, amount, final, summary, waived}`; `amount` é `null` sem termos aceitos).

**Eventos** (`/charging-sessions/{id}/events`, chave única): `vehicle_disconnected`, `overstay_started`, `overstay_billing_started`, `overstay_capped`, `overstay_gap`, `overstay_ended`, `settlement_ready`.

**Pagamento:** `overstay_terms` devolve `reserve_cents` = teto em centavos (somado ao teto da Checkout) e `overstay_charge` devolve `(centavos, final)`; o acerto só é preparado com `final` (cabo desconectado ou teto atingido). A permanência fechada fora do sync chama `prepare_settlement_for_session`.

**Equipamento:** ver [esp32-protocol.md](esp32-protocol.md#permanência-após-a-recarga). O simulador (`tools/device_simulator.py`) mantém o cabo conectado quando o START traz `overstay`; desconecta com `kill -USR1 <pid>` ou `--unplug-after N` (padrão 120 s).

**Migração `c8e3a5f2d914`** (sobre `c5f0a7e3d912`, SQL offline em `apps/api/sql/migracao_c8e3a5f2d914.sql`): colunas `overstay_*` em `charging_sessions` (nulas ou com padrão), CHECKs, índice único de uma permanência aberta por ponto e índice por usuário. Aditiva; downgrade remove as colunas.

## Banco e papel de execução

Migrações usam `MIGRATION_DATABASE_URL`, uma conexão administrativa direta. A aplicação usa `DATABASE_URL` pelo pooler em modo transação com prepared statements automáticos desativados. A migração cria o papel sem login `chargegrid_api`, remove acesso público e de `anon`/`authenticated`, ativa RLS e concede uma política somente ao papel da API. O administrador deve executar `GRANT chargegrid_api TO <usuario_sql_da_api>`; esse usuário não deve ser dono das tabelas nem ter `BYPASSRLS`. A Data API do schema deve permanecer desativada. Nunca conceder `chargegrid_api` aos papéis Supabase `anon` ou `authenticated`.

A versão atual exige `alembic upgrade head` até `d85af641bc01`. Além da migração anterior de tipo de conta e cronologia, ela permite posto de fábrica sem dono e cria `device_claims` com auditoria, unicidade e RLS. O runtime recebe somente SELECT/UPDATE nessa tabela: criar claims exige a credencial administrativa da ferramenta de fábrica. Nenhum owner legado é alterado. Aplicar a migração antes de publicar o código correspondente. Downgrade recusa remover a nulabilidade enquanto houver postos sem dono, evitando apagar equipamento para retornar ao esquema antigo.

A migração `a71c3e5d9b20` (assistente de IA, sobre `a3f1c9d2e7b4`) cria `ai_usage` somente com metadados de uso: usuário, função, status, modelo, tokens, custo, latência e nomes das ferramentas. Ela não guarda perguntas nem respostas. Aplica RLS, e somente o papel `chargegrid_api` recebe SELECT/INSERT.

A migração `b8e4f2a6c913` (sobre `a71c3e5d9b20`) revoga `PUBLIC`, `anon` e `authenticated` de `device_claims`, `session_events`, `driver_profiles` e `ai_usage`, como a migração inicial faz com as demais tabelas: no Supabase, os privilégios padrão do schema `public` concedem ALL (inclusive TRUNCATE, que o RLS não cobre) a esses papéis em toda tabela nova. O downgrade não devolve os privilégios. Detalhes da revisão em [revisao-integracao-2026-10.md](revisao-integracao-2026-10.md).

## Rebalanceamento de potência ao vivo

Migração `b7d2f4a91c36` (sobre `e5a1c7f3b9d2`), só aditiva. **Ligado por padrão desde a migração `a3e8c5d1f7b9`** (sobre `f4b9d2c7e1a3`, SQL offline em `apps/api/sql/migracao_a3e8c5d1f7b9.sql`): `server_default true`, liga em todos os postos existentes, cria `stations.building_profile`/`building_size` e volta `prepay_required`/`kiosk_payments` a `false`. O downgrade remove as colunas e devolve o padrão `false` (não restaura os valores anteriores). Desligado no posto, tudo continua como antes (o teto `max_power_kw` vale no próximo início).

**Limites: contratado, margem ESTIMADA da loja e máximo dos carregadores** (`chargegrid_core.site_load`, migração `d8b3f6a2c5e7`, SQL offline em `apps/api/sql/migracao_d8b3f6a2c5e7.sql`). Sem medidor, a loja **não é medida nem simulada**: o dono informa uma estimativa fixa, `stations.store_min_kw`/`store_peak_kw` (NULL = 14–22 kW, uma loja de conveniência média), e o **pico estimado fica reservado o tempo todo**, por cima de tudo. O mínimo é informativo (régua). Sem valor do dono, o limite contratado é `max(75 kW, pico estimado × 1,3)` em passos de 10 kW (75 kW = carga instalada máxima do Grupo B, REN ANEEL 1.000/2021). Validação no estado final: mínimo ≤ pico, até 10.000 kW, e `contratado − pico ≥ piso de um carro` (1,4 kW), senão 422 `invalid_store_estimate`. Defesa: um dado inconsistente nunca reserva mais que `contratado − 1,4 kW`. A migração preencheu a estimativa dos postos com tipo/porte (pico do tipo × porte; mínimo = menor fração da curva antiga) e limitou o pico a 85 % de um contratado gravado; `building_profile`, `building_size` e `building_load_*` ficaram sem uso (removidos numa próxima migração).

**Regra** (`chargegrid_core.balancing`, Decimal em kW): disponível = `min(max_power_kw, site_limit_kw − store_reserve_kw)` (reserva = pico estimado), nunca abaixo de 0. **Com o rebalanceamento desligado**, o mesmo orçamento `min(teto, contratado − pico)` é dividido no início de cada recarga entre os conectores ativos (`http_helpers.station_budget`; ex.: 2 × 60 kW com os padrões → 26,5 kW cada). Divide entre as sessões `starting`/`charging` (não entre conectores publicados), pedido de cada uma = `min(nominal, limite do conector, limite do motorista, máximo do equipamento)`, proporcional ao pedido com piso por equipamento (1,4 kW; 4,2 kW em carregador trifásico). Sem capacidade para o piso de todos, os carros mais novos ficam pausados (0 kW). Equipamento sem `set_power_v1` é carga fixa. Reduções saem sempre; aumento só na folga calculada com os envelopes (aplicado confirmado ou ajuste pendente) dos outros pontos.

**Disparo sem worker:** cada sync de um ponto em recarga recalcula a decisão do posto e ajusta só aquele ponto; o início de recarga calcula a potência inicial. Aumentos e inícios são serializados por `pg_advisory_xact_lock` do posto (ordem perfil → conector → posto). Protocolo em [esp32-protocol.md](esp32-protocol.md#potência-ao-vivo--set_power-firmware-050-api-b7d2f4a91c36).

**Início:** `POST /charging-sessions` aceita o `max_power_kw` do motorista como antes e agora o guarda em `requested_power_kw` (continua valendo durante a recarga). Com o rebalanceamento ligado e sem potência para o carro novo: 409 `site_power_full` com o motivo (ex.: "Sem potência disponível agora: dos 30 kW contratados, 28,5 kW ficam reservados para a loja (estimativa) e não sobra o mínimo de 1,4 kW para mais um carro. Tente novamente em alguns minutos.").

**Campos novos da sessão** (em todas as representações de sessão, inclusive histórico e `/owner/live`): `requested_power_kw`, `target_power_kw`, `applied_power_kw` (confirmado pelo equipamento), `power_state` (`applied|reducing|raising|waiting|paused|fixed`), `power_reason` (texto pt-BR, ex.: "6 kW porque 12 kW dos 30 kW contratados ficam reservados para a loja (estimativa) e há 3 carros carregando."; curto no painel: "Contrat. 30 - loja 12 kW · 3 carros"), `power_reason_short`, `power_reason_code` (`site|station|charger|port|driver|device|paused|fixed`) e `power_decision_id`.

**Eventos da sessão** (`session_events.data`, JSONB): `power_requested` `{kw, previous_kw, direction, attempt, decision_id, reason_text}`, `power_applied` `{kw, requested_kw, direction (start|reduce|raise), decision_id, reason_text, energy_wh_at}` e `power_failed` `{requested_kw, reported_kw, error}`. Só em postos com rebalanceamento. `GET /charging-sessions/{id}/events` continua devolvendo `{kind, source, observed_at}`.

**Rotas:**
- `GET /stations/{id}/power` (dono): `{station_id, rebalance_enabled, site_limit_kw (efetivo), site_limit_default, site_limit_configured_kw (do dono ou null), site_limit_default_kw, store_min_kw, store_peak_kw, store_reserve_kw, store_estimate_default, store_estimate_label ("ESTIMATIVA"), building_load_kw (descontinuado = store_reserve_kw), power_limit_notify, connectors_total_kw, charger_floor_kw, chargers_floor_total_kw, station_cap_kw, available_kw, allocated_kw, envelope_kw, exceeded_kw, cars, points:[{connector_id, public_code, power_kw, online, adjustable, charger, session:{id, status, target_kw, applied_kw, envelope_kw, power_state, reason, reason_short, reason_code}|null}], decisions:[{id, created_at, trigger, available_kw, exceeded_kw, summary}]}` (últimas 20). `exceeded_kw` mostra o excesso transitório enquanto as reduções não são confirmadas.
- `PUT /stations/{id}/power-site` (dono), Limites num só salvamento, todos parciais: `{site_limit_kw?: decimal|null, store_min_kw?: decimal|null, store_peak_kw?: decimal|null, max_power_kw?: decimal|null, power_limit_notify?: bool, rebalance_enabled?: bool}`. Valores arredondados a 0,1 kW; `site_limit_kw` > 0 e até 10.000 kW (`null` = padrão); estimativa `null` = 14–22 kW; `max_power_kw` validado como em `PATCH /stations` (`null` = sem teto próprio). Erro em qualquer campo → nada é gravado. `building_profile`/`building_size` são aceitos e ignorados (apps antigos). Os pontos ajustam no próximo sync (≤ 1 s). Devolve a visão acima.
- `PUT /stations/{id}/building-load` → **410** `store_load_removed` (o consumo da loja não é mais simulado; use a margem estimada em `power-site`). No palco, `tools/demo_rebalance.py` usa `loja KW` para mudar o pico estimado.
- `GET /charging-sessions/{id}/power` (dono da sessão; outra pessoa → 404): `{session_id, current:{target_kw, applied_kw, power_state, reason, reason_short, reason_code}, segments:[{from, to, applied_kw, reason_text, decision_id, energy_wh_at}], requests:[…]}`. Os trechos vêm só de potência **confirmada** pelo equipamento; é a fonte do gráfico de potência do recibo.

**Registro de decisões** (`power_decisions`, só leitura/inserção pelo papel da API, RLS): `{station_id, created_at, trigger (initial|store_estimate_changed|site_limit_changed|station_cap_changed|session_started|session_ended|request_changed|power_confirmed), inputs (snapshot com alvos e envelopes por sessão e os códigos públicos), available_kw, exceeded_kw, summary, input_hash}`. Grava só quando entradas, alvos ou envelopes mudam.

**Dispositivo:** `devices.capabilities` (JSONB) e `devices.charger` (JSONB) são declarados pelo equipamento a cada sync. O limite do sync passou de 40 para 120 por minuto.

## Estação (tela) e carregadores

**Estação = a TELA** (painel ESP32, `devices` com chave); **carregador = cada conector** (GoodWe HCA G2 com endereço Modbus). A entidade continua `connectors` no banco e na API; só a linguagem do app/painel mudou para "Carregadores". Uma tela comanda **N carregadores**: o do próprio ponto (o vinculado pelo QR) e os adicionais criados por "Adicionar carregador". Um carregador offline **não** derruba a estação: só aquele ponto fica indisponível e o motorista é orientado a usar outro ponto da mesma estação. Regras puras em `chargegrid_core.chargers.link`.

- **Coluna** `connectors.charger_address` (inteiro 1–247, NOT NULL desde `c5e9a2d7f4b1`), único por posto; gatilho `BEFORE INSERT` dá o menor endereço livre (1, 2, 3…). `PATCH /connectors/{id}` aceita `charger_address` (`null`/inválido → 422 `invalid_charger_address`; usado → 409 `charger_address_taken`; com reserva/recarga → 409 `point_busy`).
- **Coluna** `devices.parent_device_id` (migração `d3f8a1c6e2b7`, SQL em `apps/api/sql/migracao_d3f8a1c6e2b7.sql`): carregador adicional = linha própria em `devices` (sessões, comandos, conciliação e estado do ponto continuam por conector, como antes) **sem chave utilizável**, ligada à tela. Downgrade revoga essas linhas e remove a coluna.
- **Adicionar carregador** — `POST /connectors/{connector_id}/chargers` (dono): cria o próximo carregador do posto comandado pela tela do ponto `connector_id` (num carregador adicional, a tela dele): próximo endereço livre, mesmo tipo/potência/preço/duração do ponto da tela, `active=false` (o dono publica depois). 201 → linha do ponto (dono). 404 `not_found`; 409 `screen_required` (ponto sem tela); 409 `charger_address_full`. Credencial (`rotate-key`/`revoke`) e restauração de um carregador adicional → 409 `charger_device` (são da tela).
- **Disponibilidade por carregador** (motorista e dono): `online` = **carregador online** (tela com contato e carregador do endereço respondendo no último sync; firmware antigo sem `charger.address` = tela online). Novos: `screen_online` (a tela/estação tem contato) e `unavailable_reason`: `null` | `"charger_offline"` (tela online, carregador sem resposta, endereço ainda não confirmado pela tela, ou carregador adicional que a tela parou de sincronizar) | `"screen_offline"`. Com qualquer um dos dois o ponto fica `availability_status: "offline"`, `available: false` (sessão ativa mantém `charging`/`reconciling`). Estação: `screen_online` (alguma tela do posto com contato; `null` sem tela). `GET /owner/live` traz os mesmos campos; `GET /owner/alerts` ganha `charger_offline` ("Carregador offline": a tela está online, só aquele ponto parou).
- **START/reserva/totem num carregador offline:** 409 `point_unavailable` com `reason: "charger_offline"`, `message: "Carregador offline — use outro ponto desta estação"` e `alternatives: [{id, public_code}]` (pontos livres da mesma estação). Reserva confirmada cujo carregador caiu também recusa o START assim. Se o carregador cair entre o aceite e o START, a tela responde ACK `failed` `charger_offline`: a API manda STOP `charger_offline` e a sessão termina `failed` com `end_reason: "charger_offline"` (recibo: "Carregador offline — use outro ponto desta estação"). START que nunca começou guarda o motivo da API (`start_failed`/`start_timeout`/`charger_offline`), não o "requested" genérico da tela.
- **Payloads do dono** (`GET /stations/{id}`, `/operator/stations`, `PATCH`): por ponto `charger_link = {model, transport, address, host, label:"GoodWe HCA G2", simulated:true, link:"online"|"offline"|"pending", last_online_at, measured_power_w, reported}` (`last_online_at` = última leitura OK do carregador pela tela; `measured_power_w` = potência lida nesse sync) e `screen = {device_id, connector_id, public_code, online, last_seen, firmware_version, role:"screen"|"charger", multi_charger}`; por estação `screens: [{device_id, connector_id, public_code, online, last_seen, firmware_version, multi_charger, charger_ids}]`. Texto: "Carregador 1 · GoodWe HCA G2 (simulado) · online|offline|aguardando a tela". Motorista: sem `charger_address`/`charger_link`/`screen`. `GET /connectors/{id}/device` traz `screen_device_id` (carregador adicional: a tela; `null` = é a tela).
- **Sync (resposta):** `connector.charger_link` para todo conector; a resposta do sync **da tela** traz `chargers: [{address, connector_id, public_code, charger_link}]` (carregadores adicionais). **Sync endereçado:** corpo com `charger_address: N` (mesma chave) = sync do carregador N da tela (formato igual; 409 `charger_not_linked` para endereço sem carregador desta tela). Limite de 120 syncs/min por carregador. Detalhes de firmware em `docs/esp32-protocol.md` ("Carregador GoodWe do conector" e "Vários carregadores por tela").
- **Sync (corpo):** `charger` com `address`/`link` como antes; `capabilities` pode trazer `multi_charger_v1`. A API guarda em `devices.charger` também `last_online_at` e `measured_power_w` (do `power_w`) quando o link está online.
- **Simulador:** `python tools/device_simulator.py` segue `connector.charger_link` e, por padrão, há um carregador simulado respondendo no endereço (limites da bancada, 7,2 kW); `--hca-link` emula os registradores do HCA G2 (GW7K, 7,0 kW); `--hca-offline` começa sem resposta (START recusado com `charger_offline`); `kill -USR2 <pid>` alterna. Com `chargers` na resposta, a bancada sincroniza por cada carregador adicional (`Station`, `charger_address`). Recarga cujo carregador some para com `end_reason = "charger_unreachable"`.
