DJLIMA1/FIAP-ChargeGridApp-GS1-2026/firmware/esp32/THIRD_PARTY.md

# Componentes de terceiros do painel

- `src/lvgl_v8_port.cpp` e `include/lvgl_v8_port.h`: template `simple_port` do [ESP32_Display_Panel 1.0.4](https://github.com/esp-arduino-libs/ESP32_Display_Panel/tree/v1.0.4), Espressif Systems, licença CC0-1.0. Os cabeçalhos SPDX originais foram preservados.
- `include/esp_panel_*_conf.h` e `include/esp_utils_conf.h`: templates de configuração do mesmo projeto, com seleção local da placa `BOARD_WAVESHARE_ESP32_S3_TOUCH_LCD_7`; licenças e cabeçalhos SPDX originais preservados.
- [ESP32_Display_Panel 1.0.4](https://github.com/esp-arduino-libs/ESP32_Display_Panel/tree/v1.0.4): biblioteca Apache-2.0, obtida pelo PlatformIO com suas dependências declaradas.
- [LVGL 8.4.0](https://github.com/lvgl/lvgl/tree/v8.4.0): biblioteca MIT, obtida pelo PlatformIO.

O símbolo `EV_STATION` do ícone e da tela foi obtido do [Material Design Icons do Google](https://github.com/google/material-design-icons/blob/master/src/maps/ev_station/materialicons/24px.svg), sob a licença Apache-2.0. O tratamento de cor e a composição `apps/mobile/assets/brand_mark.svg` pertencem ao projeto ChargeGrid; `tools/generate_brand_assets.py` deriva os bitmaps Android e do painel dessa fonte.
