DJLIMA1/FIAP-ChargeGridApp-GS1-2026/docs/prototipo-usb/ender3-original-pla-v1/ARQUIVOS.md

# Arquivos por impressão

Abrir 3MF OU STL de cada linha. Não importar os dois formatos juntos.

| Impressão | 3MF | STL |
|---|---|---|
| 00-teste-encaixes | [3MF](00-teste-encaixes/00-teste-encaixes.3mf) | [STL](00-teste-encaixes/00-teste-encaixes.stl) |
| 01-tampa-branca | [3MF](01-tampa-branca/01-tampa-branca.3mf) | [STL](01-tampa-branca/01-tampa-branca.stl) |
| 02-traseira-superior | [3MF](02-traseira-superior/02-traseira-superior.3mf) | [STL](02-traseira-superior/02-traseira-superior.stl) |
| 03-traseira-inferior | [3MF](03-traseira-inferior/03-traseira-inferior.3mf) | [STL](03-traseira-inferior/03-traseira-inferior.stl) |
| 04-quadro-superior | [3MF](04-quadro-superior/04-quadro-superior.3mf) | [STL](04-quadro-superior/04-quadro-superior.stl) |
| 05-quadro-inferior | [3MF](05-quadro-inferior/05-quadro-inferior.3mf) | [STL](05-quadro-inferior/05-quadro-inferior.stl) |
| 06-chaves-das-emendas | [3MF](06-chaves-das-emendas/06-chaves-das-emendas.3mf) | [STL](06-chaves-das-emendas/06-chaves-das-emendas.stl) |
| 07-pinos-quarto-de-volta | [3MF](07-pinos-quarto-de-volta/07-pinos-quarto-de-volta.3mf) | [STL](07-pinos-quarto-de-volta/07-pinos-quarto-de-volta.stl) |
| 08-pinos-tampa-branca | [3MF](08-pinos-tampa-branca/08-pinos-tampa-branca.3mf) | [STL](08-pinos-tampa-branca/08-pinos-tampa-branca.stl) |
| 09-bandeja-e-bercos | [3MF](09-bandeja-e-bercos/09-bandeja-e-bercos.3mf) | [STL](09-bandeja-e-bercos/09-bandeja-e-bercos.stl) |
| 10-travas-e-espacadores | [3MF](10-travas-e-espacadores/10-travas-e-espacadores.3mf) | [STL](10-travas-e-espacadores/10-travas-e-espacadores.stl) |
| 11-cabos-duplos-5mm-OPCIONAL | [3MF](11-cabos-duplos-5mm-OPCIONAL/11-cabos-duplos-5mm-OPCIONAL.3mf) | [STL](11-cabos-duplos-5mm-OPCIONAL/11-cabos-duplos-5mm-OPCIONAL.stl) |
