DJLIMA1/FIAP-ChargeGridApp-GS1-2026/apps/mobile/assets/figma/README.md

# Assets do Figma

SVGs originais exportados pelo contexto de design do arquivo [Core (Projeto)](https://www.figma.com/design/CdhvPkmGhIvy3l1roJNino/Core--Projeto-?node-id=365-3786), telas de vendedor `365:3786` e `365:3859`, em 27/09/2026.

- `wordmark-dark.svg`: marca do cabeçalho, 101 × 21.
- `nav-*.svg`: ícones da navegação, 22 × 22.
- `configure.svg`: ícone da ação Configurar, 16 × 16.

Os arquivos mantêm os bytes fornecidos pelo Figma. O aplicativo ajusta a cor na renderização para indicar seleção e manter contraste nos temas claro e escuro.
