DJLIMA1/FIAP-ChargeGridApp-GS1-2026/docs/autoatendimento-totem-0.9.0.md

# Autoatendimento da central — firmware 0.9.0

Revisão posterior: [correções e interface compartilhada da 0.9.2](autoatendimento-totem-0.9.2.md). Esta página registra a entrega inicial.

Referência visual: os SVGs de `Core (Projeto)-9`, adaptados para os 800 × 480 pixels da Waveshare 7. A interface usa a composição em duas colunas, superfícies escuras, marca vermelha e controles brancos. As opções ocupam toda a largura interna; textos de revisão e recibo ajustam a fonte para caber.

## Fluxo

1. Escolher **Entrar na minha conta** ou **Continuar sem login**.
2. Selecionar um carregador disponível da central. Carregadores ocupados ficam desabilitados; o carregador principal desativado não bloqueia os outros.
3. Escolher valor, tempo ou energia. **Autonomia** aparece somente com login confirmado e carro válido salvo no perfil.
4. Informar o limite com atalhos ou teclado.
5. Escolher potência máxima ou reduzida, respeitando ponto e carro.
6. Escolher Pix, cartão ou saldo. O servidor informa os meios habilitados. O saldo exige login, saldo suficiente e posto em modo apresentação.
7. Revisar preço, demanda, teto, estimativas e permanência, e aceitar.
8. Pagar: no modo apresentação, confirmação explicitamente simulada; na Stripe de teste, QR da página segura. Não há uma maquininha física fictícia nem um botão que confirme sozinho um pagamento real.
9. Aguardar o START normal do servidor e acompanhar potência, energia, custo e tempo. SoC desconhecido permanece `--`.
10. Encerrar com confirmação e consultar o recibo. A sobra do saldo simulado é devolvida uma única vez.

Os textos dos mockups são referências de produto, não instruções operacionais. Em particular, o “Já paguei” do desenho não substitui confirmação do servidor.
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
