DJLIMA1/FIAP-ChargeGridApp-GS1-2026/docs/roteiro-apresentacao-10-minutos-ffive.md

# ChargeGrid - roteiro de apresentação da Equipe FFIVE

Duração-alvo: **10 minutos**. Versão de 21/10/2026.

As falas estão em citações. As indicações **TELA / AÇÃO** são para a equipe, não para leitura. Todo "mostrar" corresponde à demonstração ao vivo, exceto cadastro/login e perfil/veículo, previstos em imagens. Falar durante a navegação; o tempo inclui as duas recargas curtas.

## Ordem e tempo

| Tempo | Bloco | Duração |
|---|---|---|
| 0:00-1:10 | Introdução | 1 min 10 s |
| 1:10-2:55 | 1. Operador | 1 min 45 s |
| 2:55-5:10 | 2. Usuário e recarga | 2 min 15 s |
| 5:10-5:55 | 3. Históricos lado a lado | 45 s |
| 5:55-7:25 | 4. Autoatendimento completo | 1 min 30 s |
| 7:25-8:30 | 5. Chat com IA e recusas | 1 min 05 s |
| 8:30-9:45 | 6. Resgate e rentabilidade | 1 min 15 s |
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
