DJLIMA1/FIAP-ChargeGridApp-GS1-2026/apps/mobile/assets/design/car_byd_dolphin.png

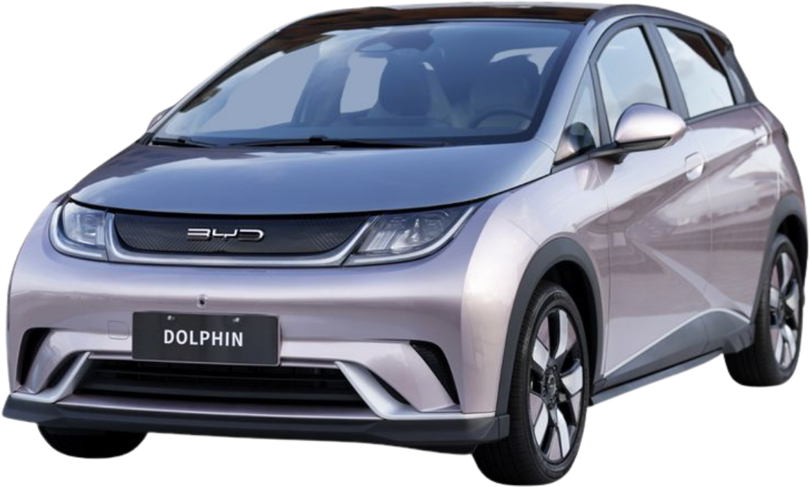
apps/mobile/assets/design/car_byd_dolphin.png
