DJLIMA1/FIAP-ChargeGridApp-GS1-2026/apps/mobile/assets/design/car_gwm_ora_03.png

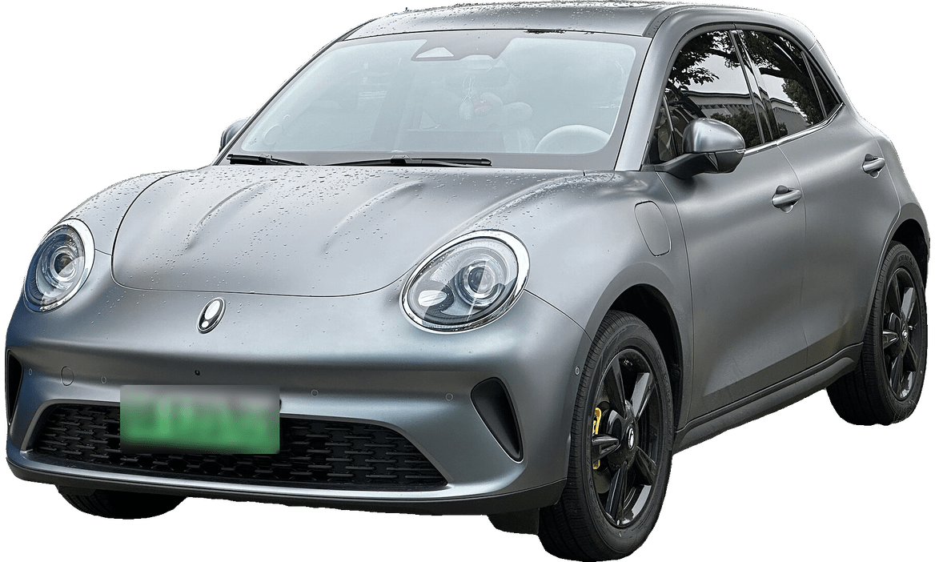
apps/mobile/assets/design/car_gwm_ora_03.png
