DJLIMA1/FIAP-ChargeGridApp-GS1-2026/apps/mobile/assets/design/map_villa_lobos.jpg

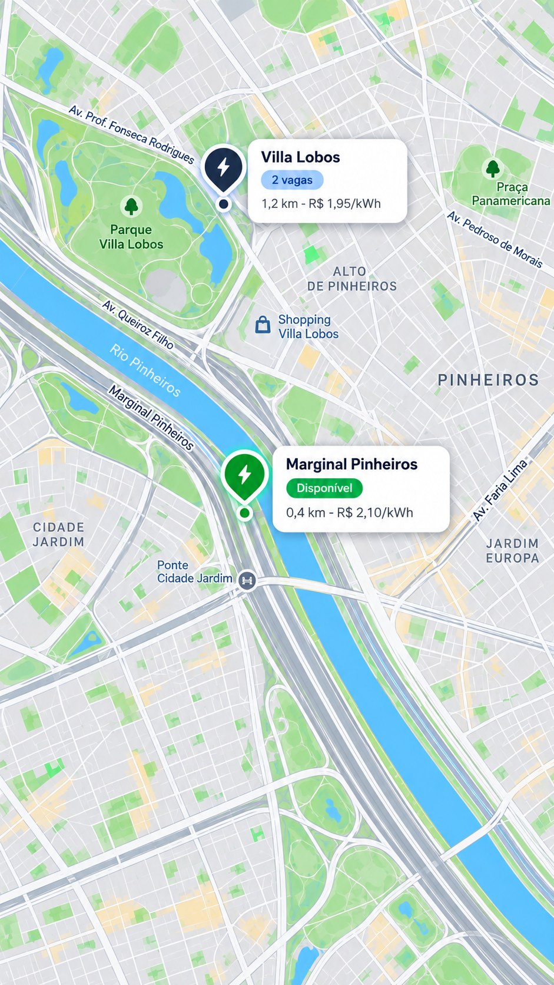
apps/mobile/assets/design/map_villa_lobos.jpg
