DJLIMA1/FIAP-ChargeGridApp-GS1-2026/apps/mobile/assets/design/qr_pix_demo.png

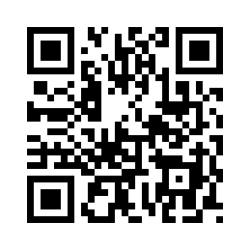
apps/mobile/assets/design/qr_pix_demo.png
