DJLIMA1/FIAP-ChargeGridApp-GS1-2026/apps/mobile/assets/design/totem_goodwe.png

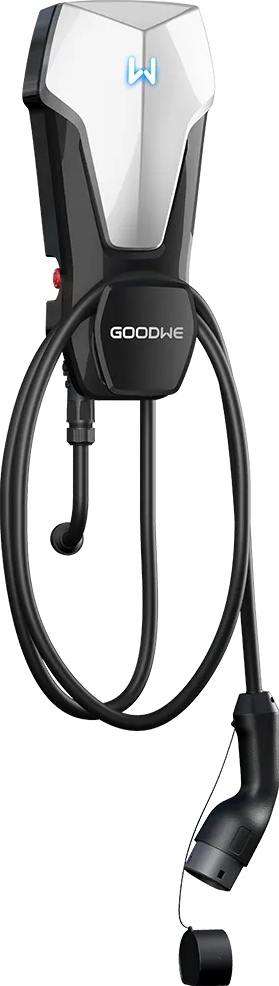
apps/mobile/assets/design/totem_goodwe.png
