DJLIMA1/FIAP-ChargeGridApp-GS1-2026/apps/mobile/assets/maps/demo-centro.png

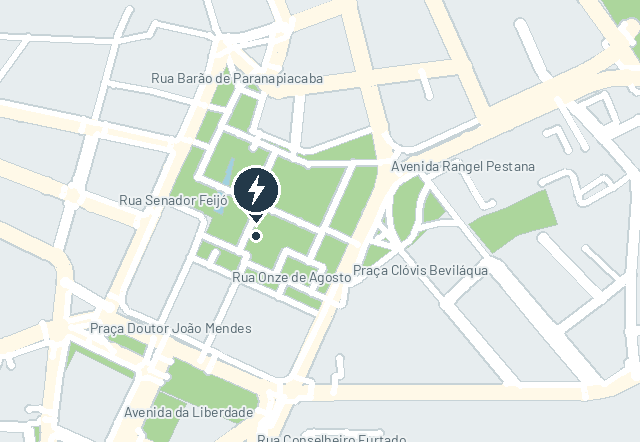
apps/mobile/assets/maps/demo-centro.png
