DJLIMA1/FIAP-ChargeGridApp-GS1-2026/apps/owner-web/src/assets/totem.webp

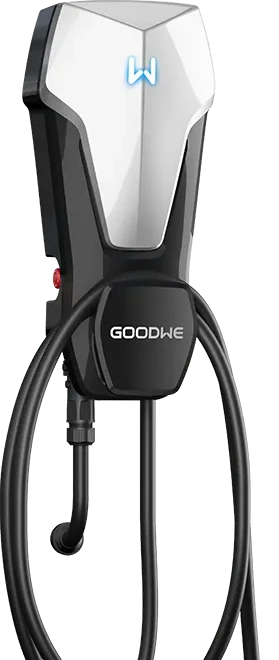
apps/owner-web/src/assets/totem.webp
