DJLIMA1/FIAP-ChargeGridApp-GS1-2026/apps/owner-web/src/landing/img/dashboard-insights-ia.webp

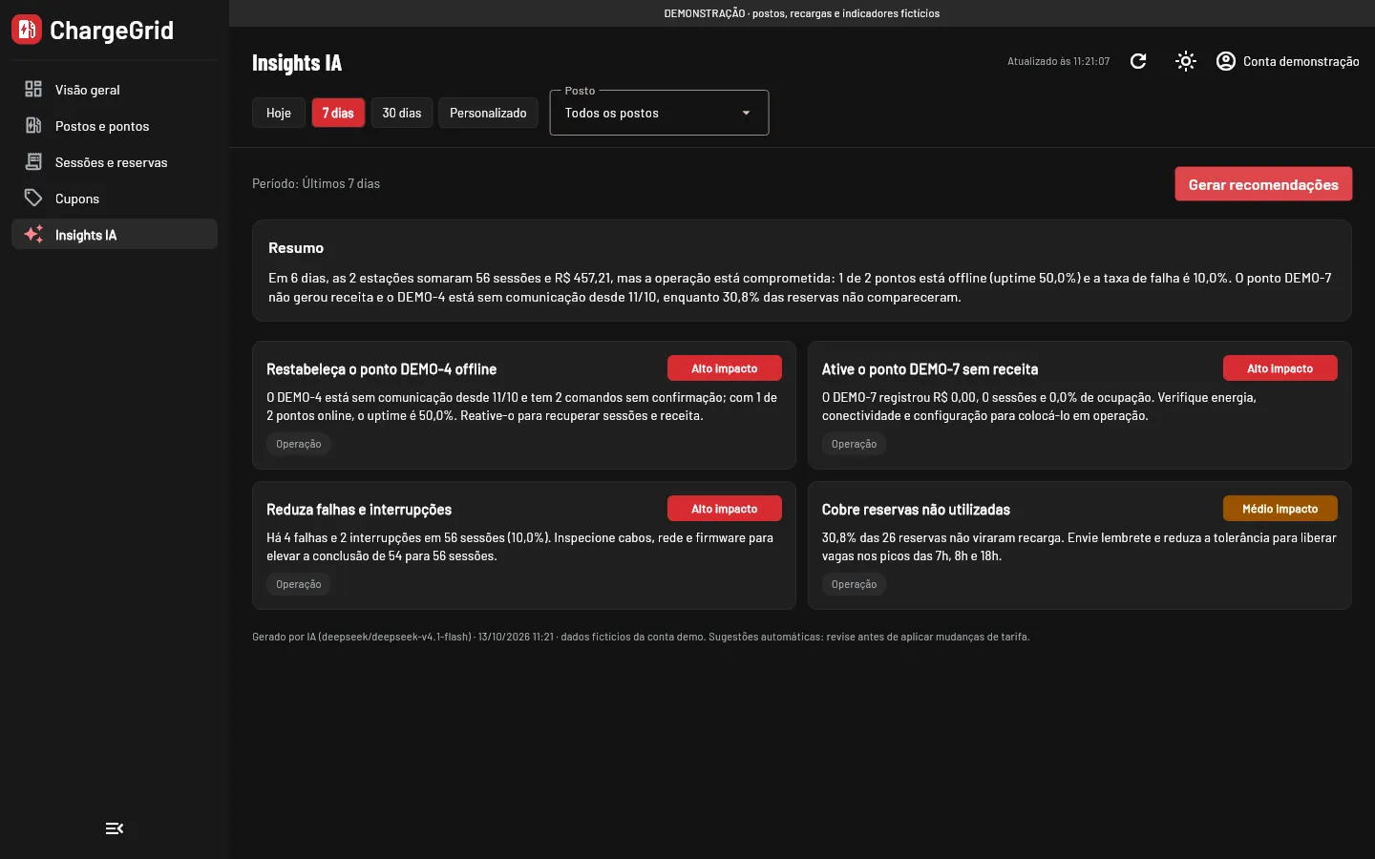
apps/owner-web/src/landing/img/dashboard-insights-ia.webp
