DJLIMA1/FIAP-ChargeGridApp-GS1-2026/apps/owner-web/src/landing/img/painel-esp32-framebuffer.webp

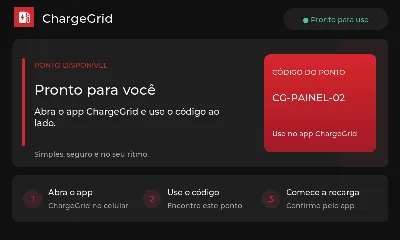
apps/owner-web/src/landing/img/painel-esp32-framebuffer.webp
