DJLIMA1/FIAP-ChargeGridApp-GS1-2026/docs/case-tela-waveshare-7/previas/11-impressao-corpo.png

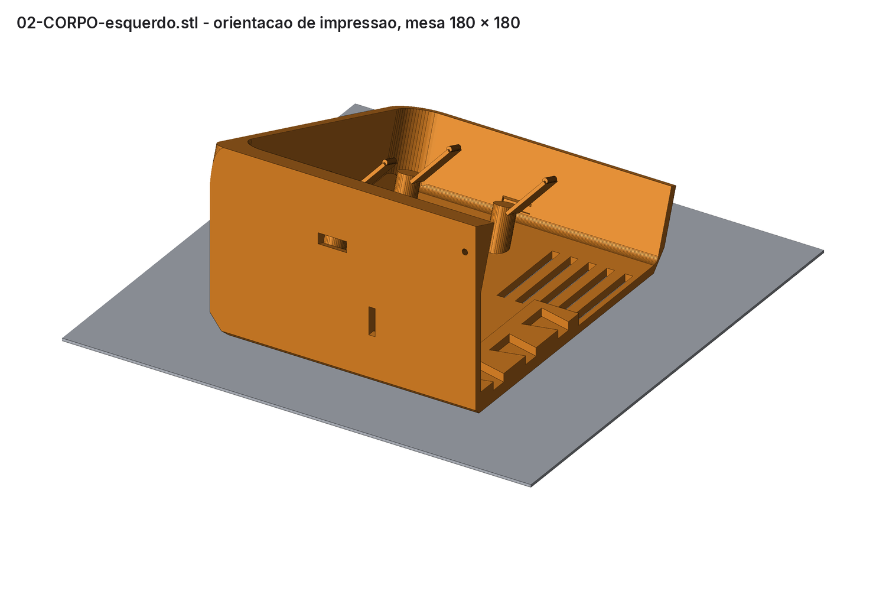
docs/case-tela-waveshare-7/previas/11-impressao-corpo.png
