DJLIMA1/FIAP-ChargeGridApp-GS1-2026/docs/case-tela-waveshare-7/previas/13-base-por-baixo.png

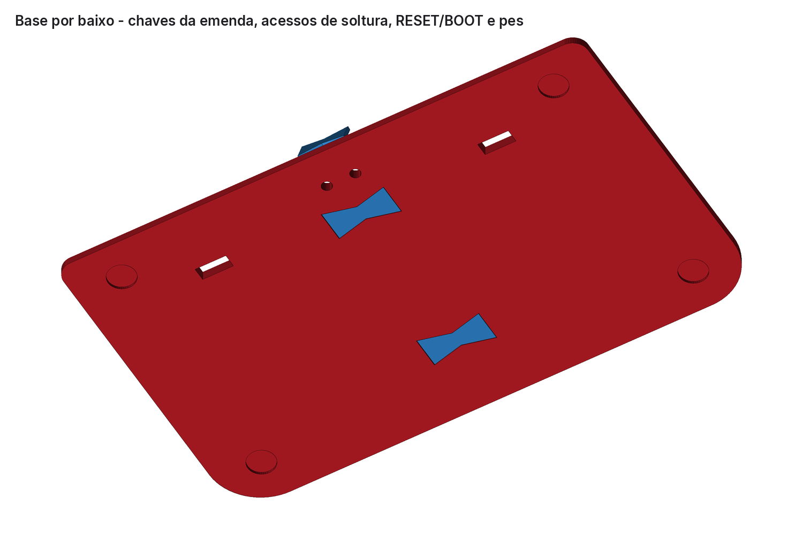
docs/case-tela-waveshare-7/previas/13-base-por-baixo.png
