DJLIMA1/FIAP-ChargeGridApp-GS1-2026/docs/case-tela-waveshare-7/previas/impressao-01-MOLDURA-direita.png

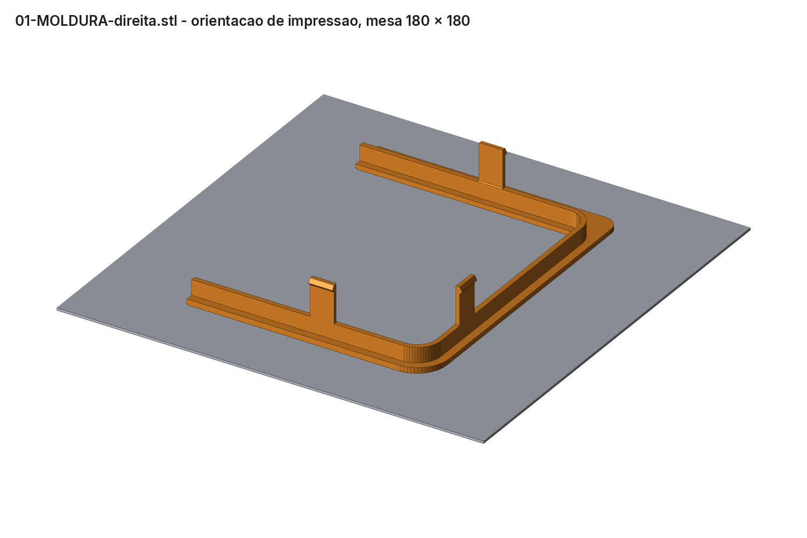
docs/case-tela-waveshare-7/previas/impressao-01-MOLDURA-direita.png
