DJLIMA1/FIAP-ChargeGridApp-GS1-2026/docs/case-tela-waveshare-7/previas/impressao-02-CORPO-direito.png

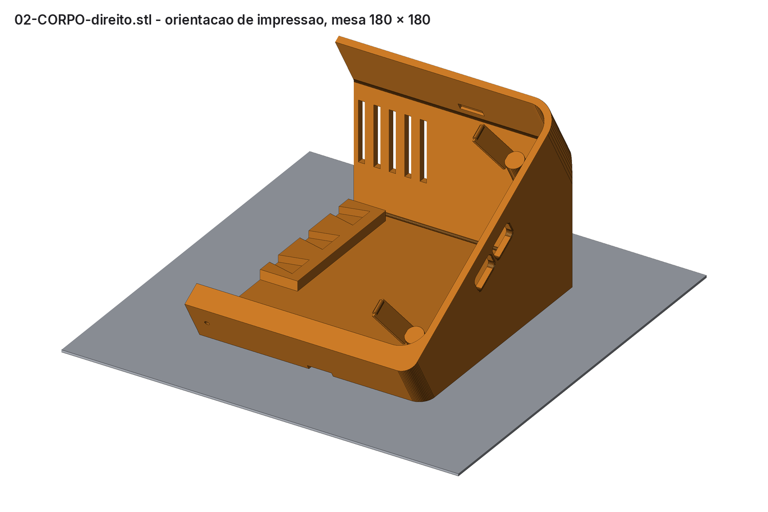
docs/case-tela-waveshare-7/previas/impressao-02-CORPO-direito.png
