DJLIMA1/FIAP-ChargeGridApp-GS1-2026/docs/images/app-home-gs-dark.png

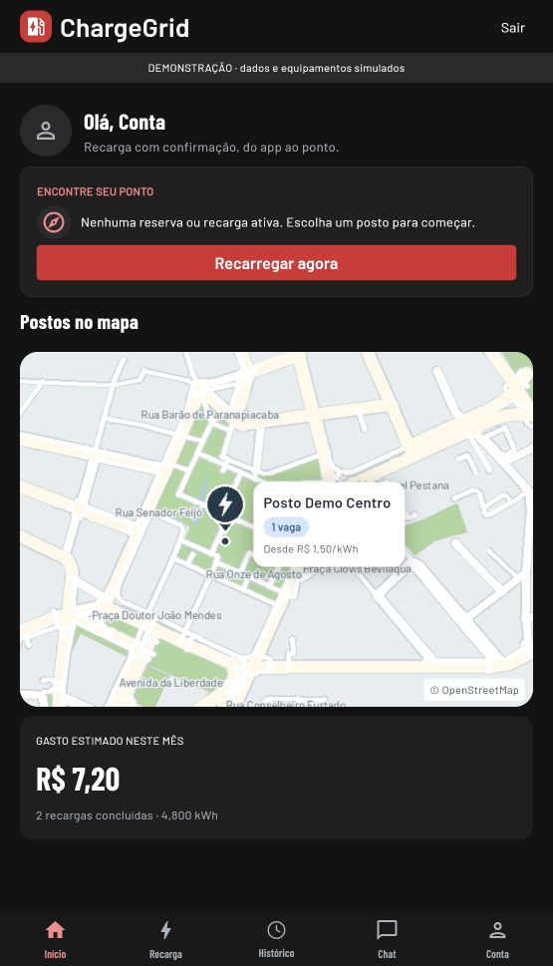
docs/images/app-home-gs-dark.png
