DJLIMA1/FIAP-ChargeGridApp-GS1-2026/docs/images/app-home-previa.png

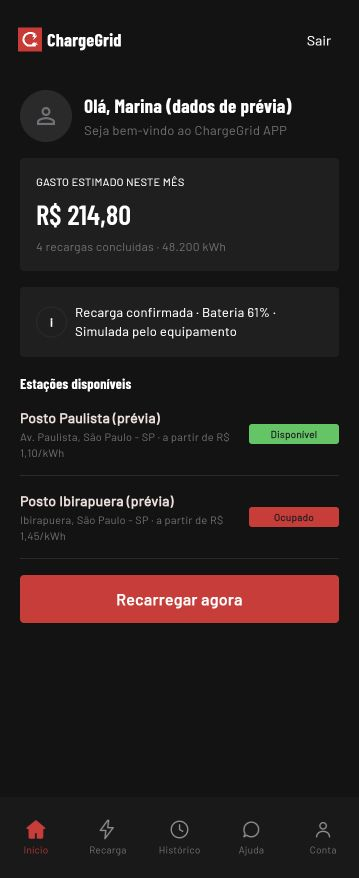
docs/images/app-home-previa.png
