DJLIMA1/FIAP-ChargeGridApp-GS1-2026/docs/images/app-modo-motorista.png

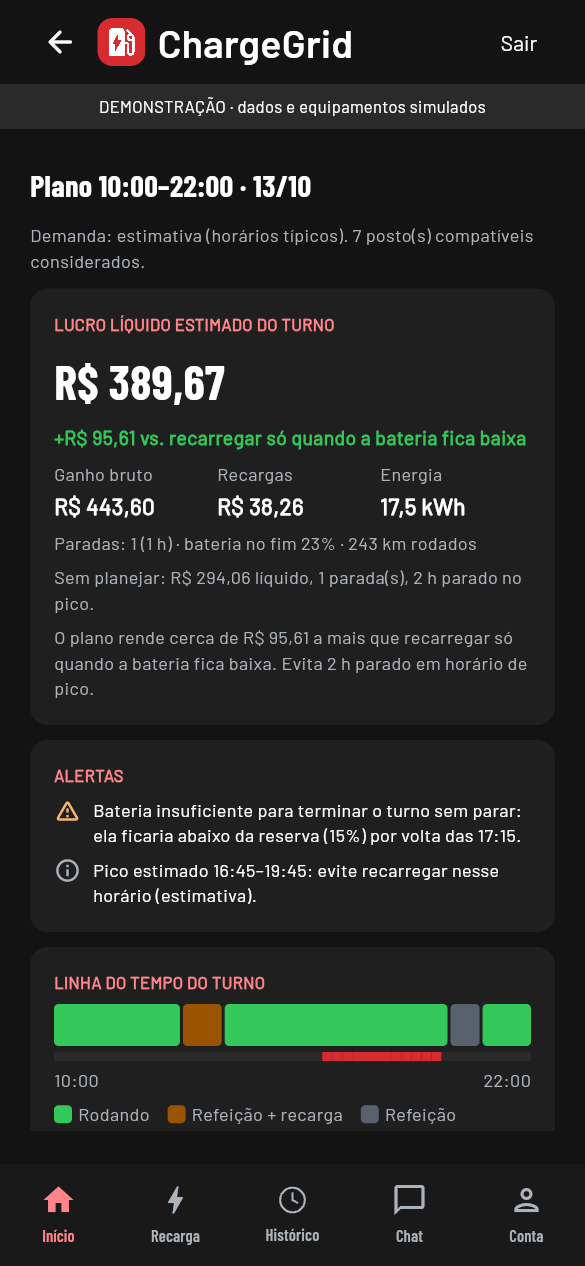
docs/images/app-modo-motorista.png
