DJLIMA1/FIAP-ChargeGridApp-GS1-2026/docs/images/painel-esp32-framebuffer.png

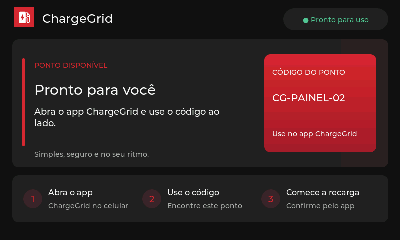
docs/images/painel-esp32-framebuffer.png
