DJLIMA1/FIAP-ChargeGridApp-GS1-2026/docs/prototipo-usb/arquitetura-modular.png

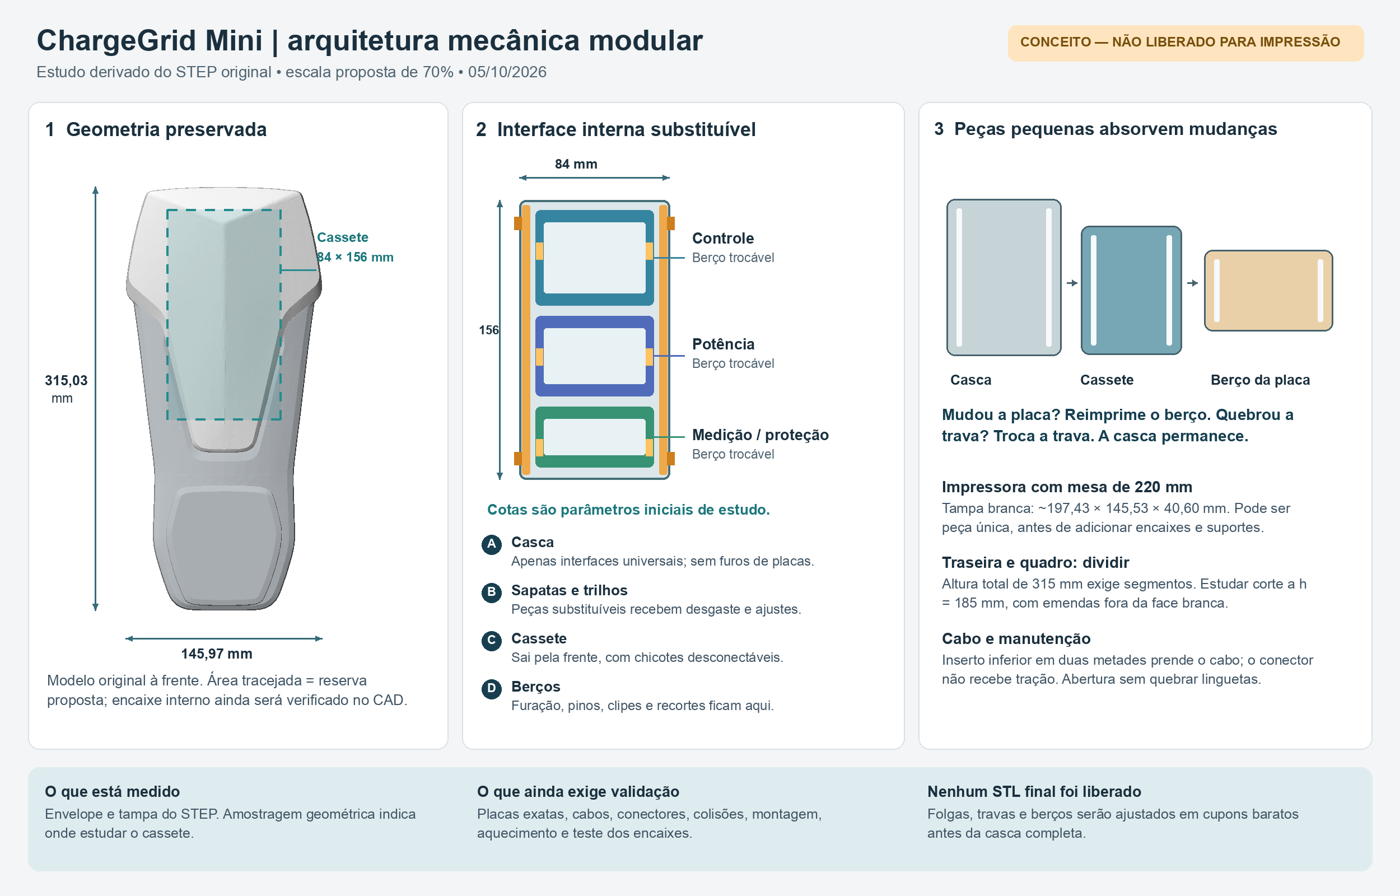
docs/prototipo-usb/arquitetura-modular.png
