DJLIMA1/FIAP-ChargeGridApp-GS1-2026/docs/prototipo-usb/cad-impressao-50-v1/vista-explodida.png

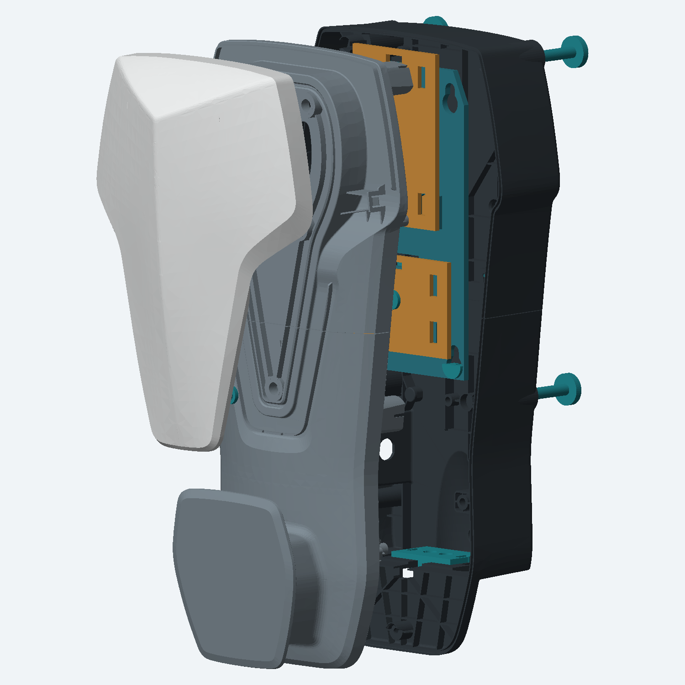
docs/prototipo-usb/cad-impressao-50-v1/vista-explodida.png
