DJLIMA1/FIAP-ChargeGridApp-GS1-2026/docs/prototipo-usb/ender3-original-pla-v1/mapa-das-impressoes.png

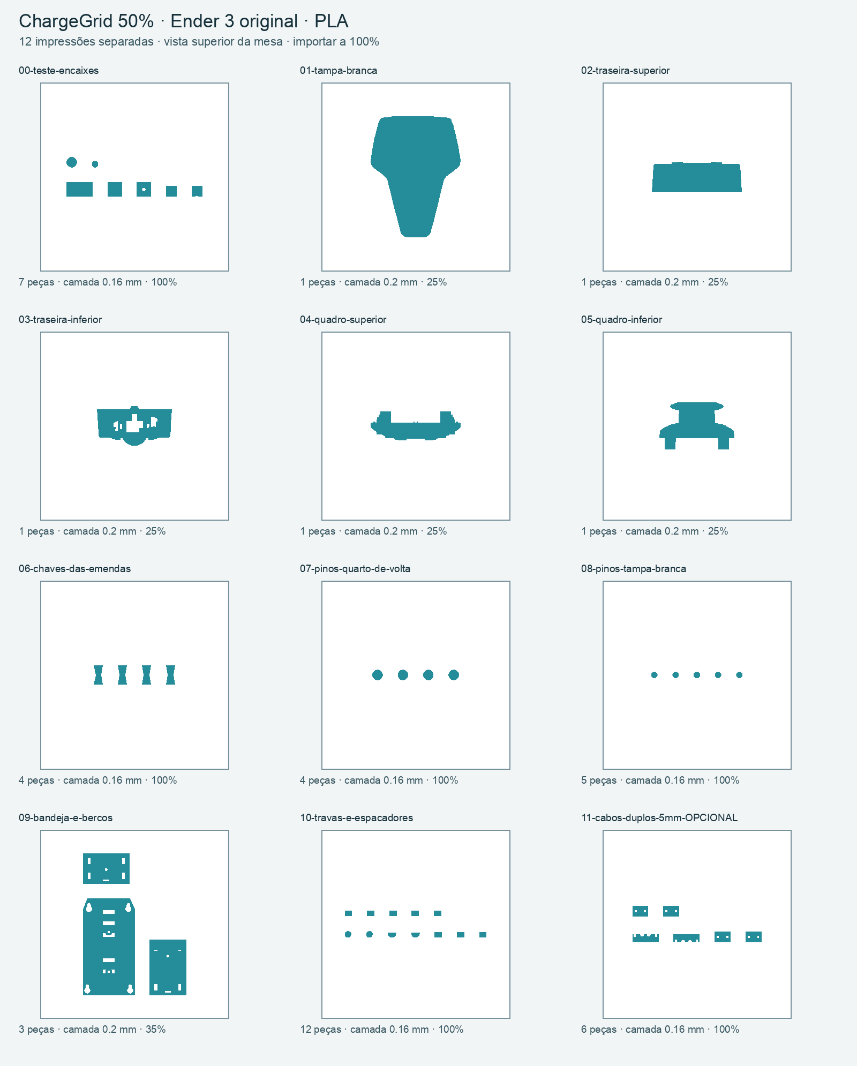
docs/prototipo-usb/ender3-original-pla-v1/mapa-das-impressoes.png
