DJLIMA1/FIAP-ChargeGridApp-GS1-2026/docs/prototipo-usb/ender3-pla-gcode-v1/previas/11CABO.png

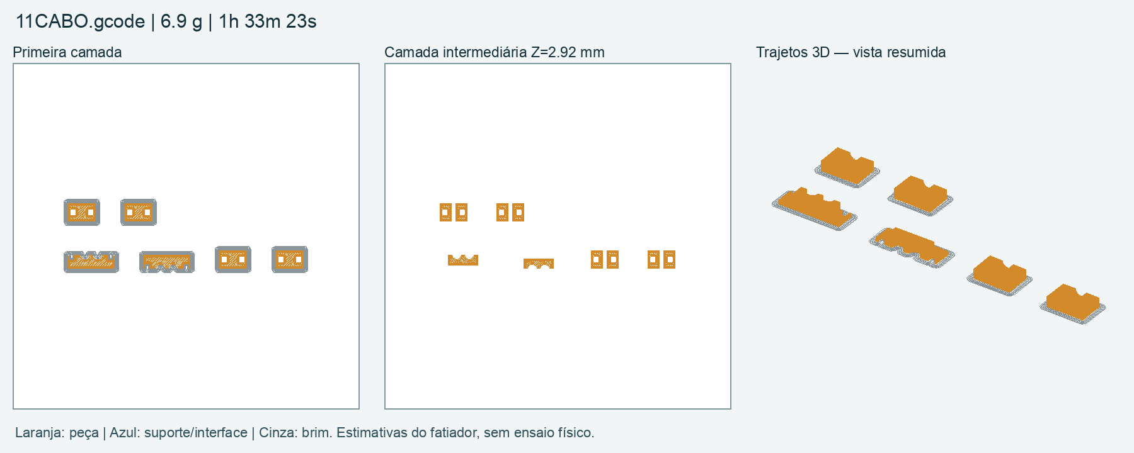
docs/prototipo-usb/ender3-pla-gcode-v1/previas/11CABO.png
