DJLIMA1/FIAP-ChargeGridApp-GS1-2026/docs/prototipo-usb/ender3-pla-gcode-v1/resumo-visual.png

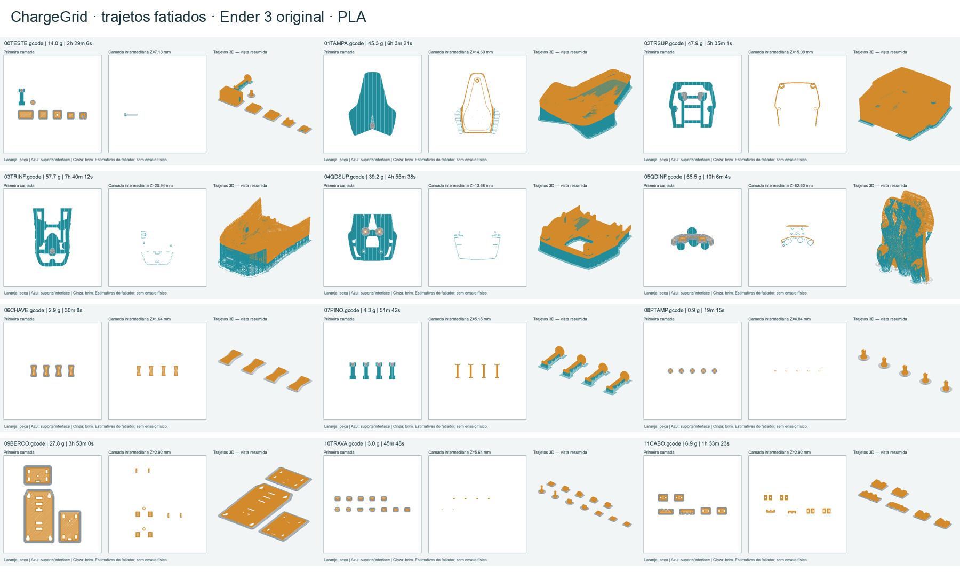
docs/prototipo-usb/ender3-pla-gcode-v1/resumo-visual.png
