DJLIMA1/FIAP-ChargeGridApp-GS1-2026/docs/prototipo-usb/ender3-pla-gcode-v2/previas/04QDSUP.png

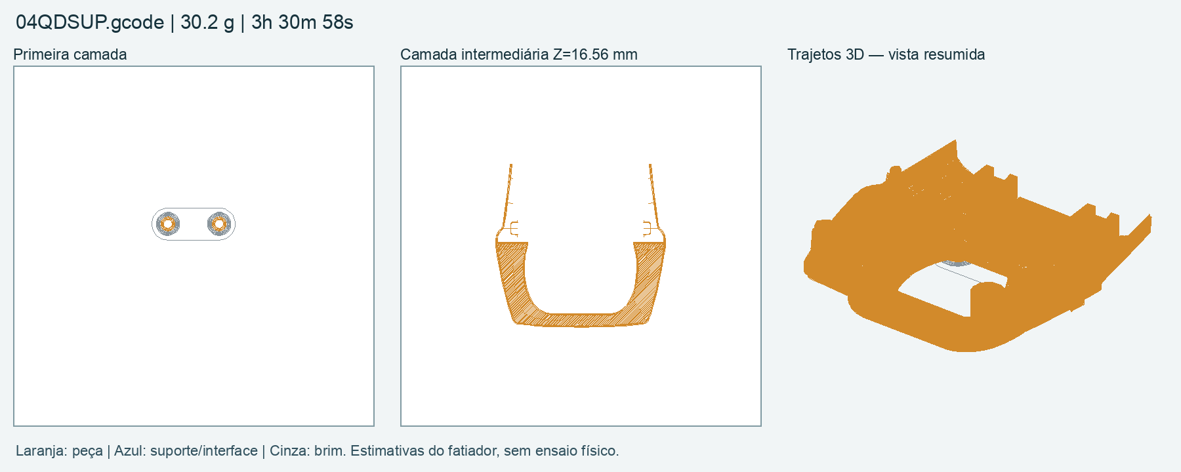
docs/prototipo-usb/ender3-pla-gcode-v2/previas/04QDSUP.png
