DJLIMA1/FIAP-ChargeGridApp-GS1-2026/docs/prototipo-usb/ender3-pla-oficial-v6/previas/03TRINF.png

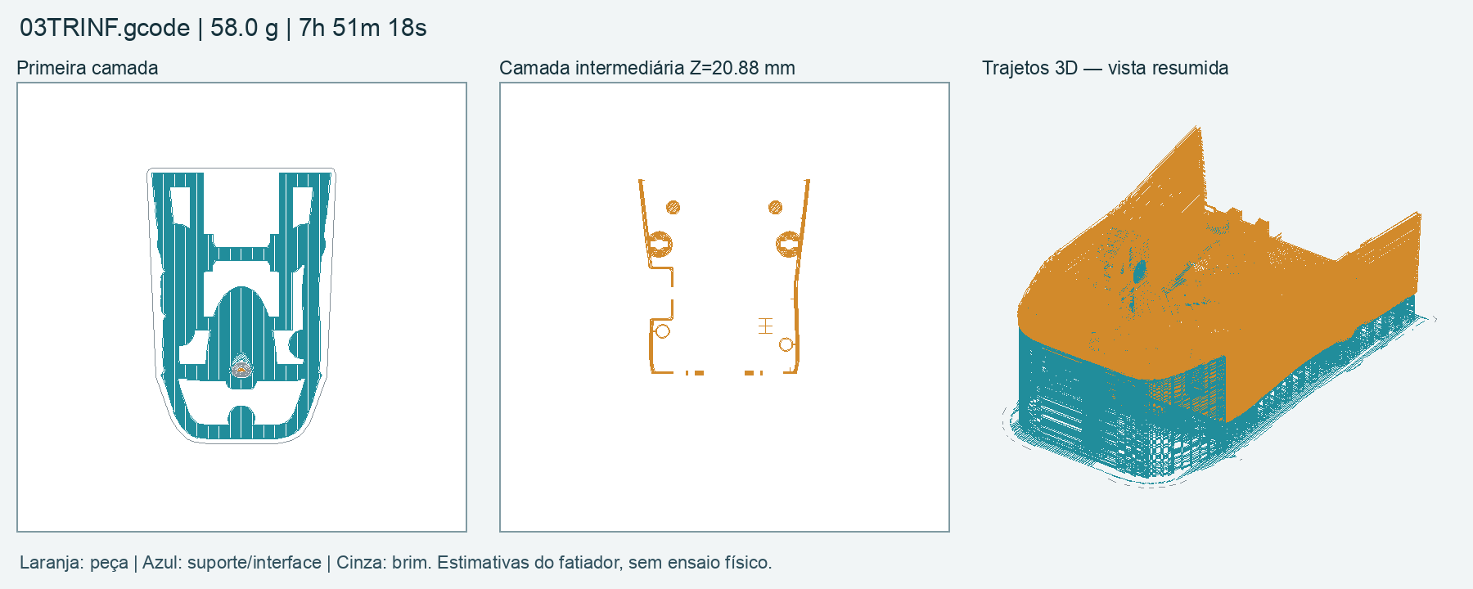
docs/prototipo-usb/ender3-pla-oficial-v6/previas/03TRINF.png
