DJLIMA1/FIAP-ChargeGridApp-GS1-2026/docs/prototipo-usb/ender3-pla-oficial-v8/previas/08PTINF.png

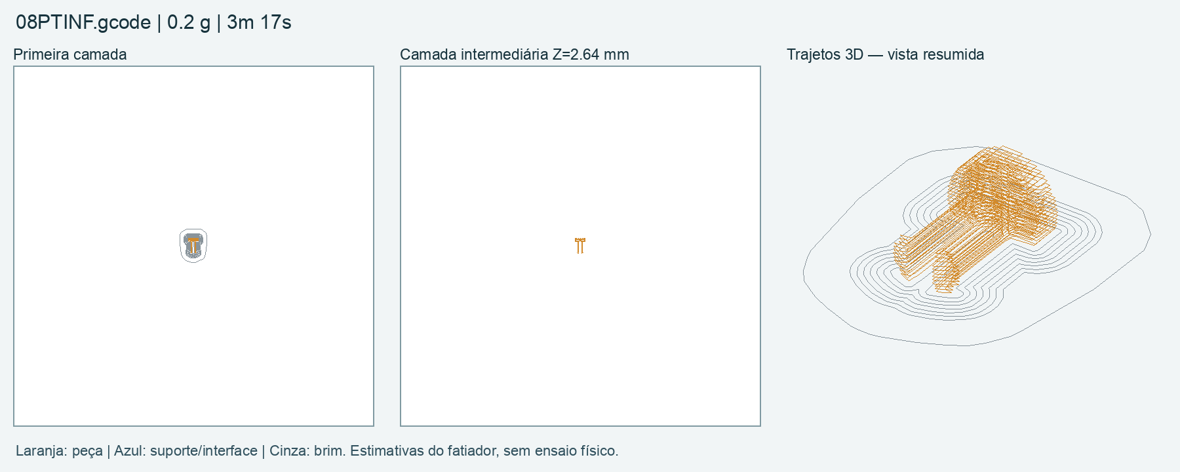
docs/prototipo-usb/ender3-pla-oficial-v8/previas/08PTINF.png
