DJLIMA1/FIAP-ChargeGridApp-GS1-2026/docs/prototipo-usb/ender3-pla-oficial-v8/previas/10BERCO8.png

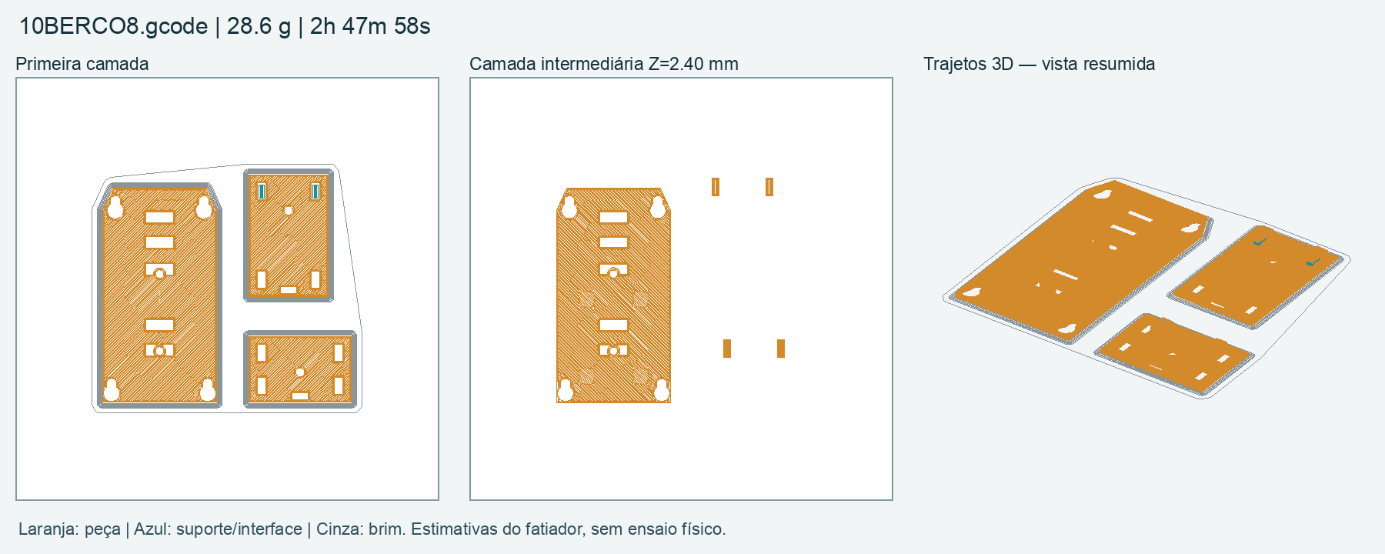
docs/prototipo-usb/ender3-pla-oficial-v8/previas/10BERCO8.png
