DJLIMA1/FIAP-ChargeGridApp-GS1-2026/docs/prototipo-usb/ender3-pla-oficial-v8/previas/11TRAVA8.png

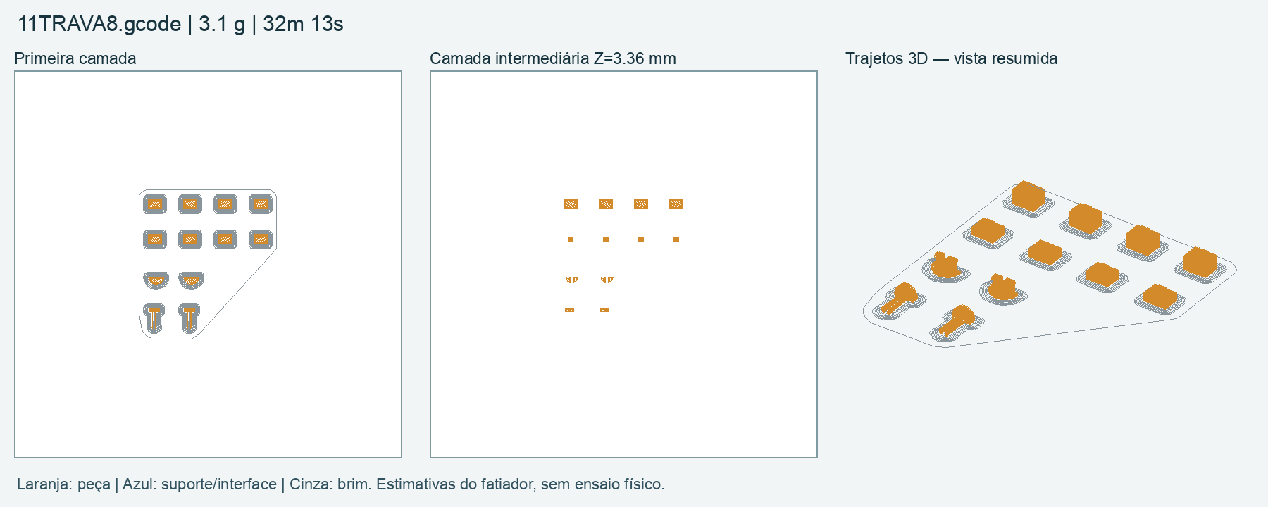
docs/prototipo-usb/ender3-pla-oficial-v8/previas/11TRAVA8.png
