DJLIMA1/FIAP-ChargeGridApp-GS1-2026/docs/prototipo-usb/ender3-pla-oficial-v9/interior-revisado.png

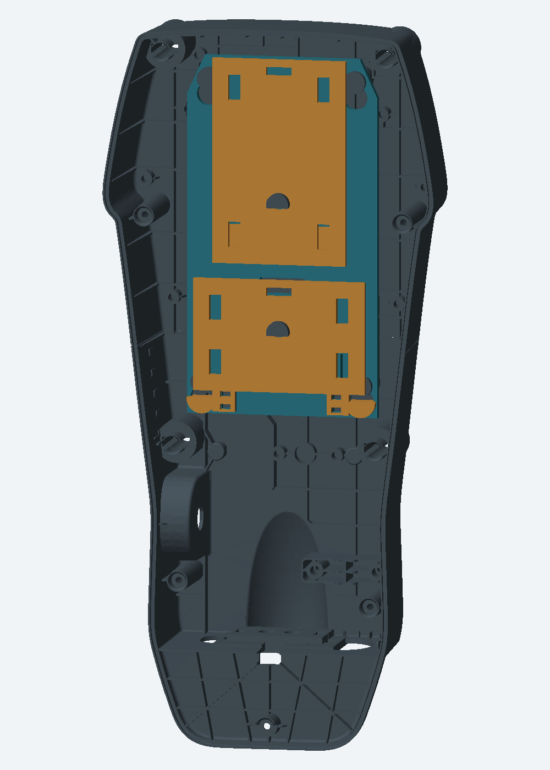
docs/prototipo-usb/ender3-pla-oficial-v9/interior-revisado.png
