DJLIMA1/FIAP-ChargeGridApp-GS1-2026/docs/prototipo-usb/imagens-correcao-v7/01-peca-02-em-impressao.png

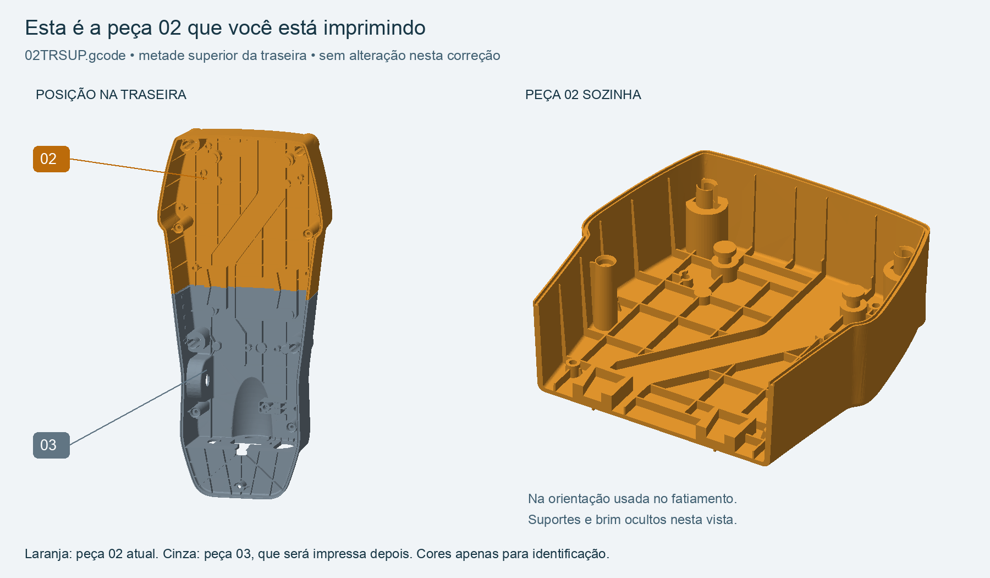
docs/prototipo-usb/imagens-correcao-v7/01-peca-02-em-impressao.png
