DJLIMA1/FIAP-ChargeGridApp-GS1-2026/docs/prototipo-usb/imagens-correcao-v7/02-peca-03-antes-depois.png

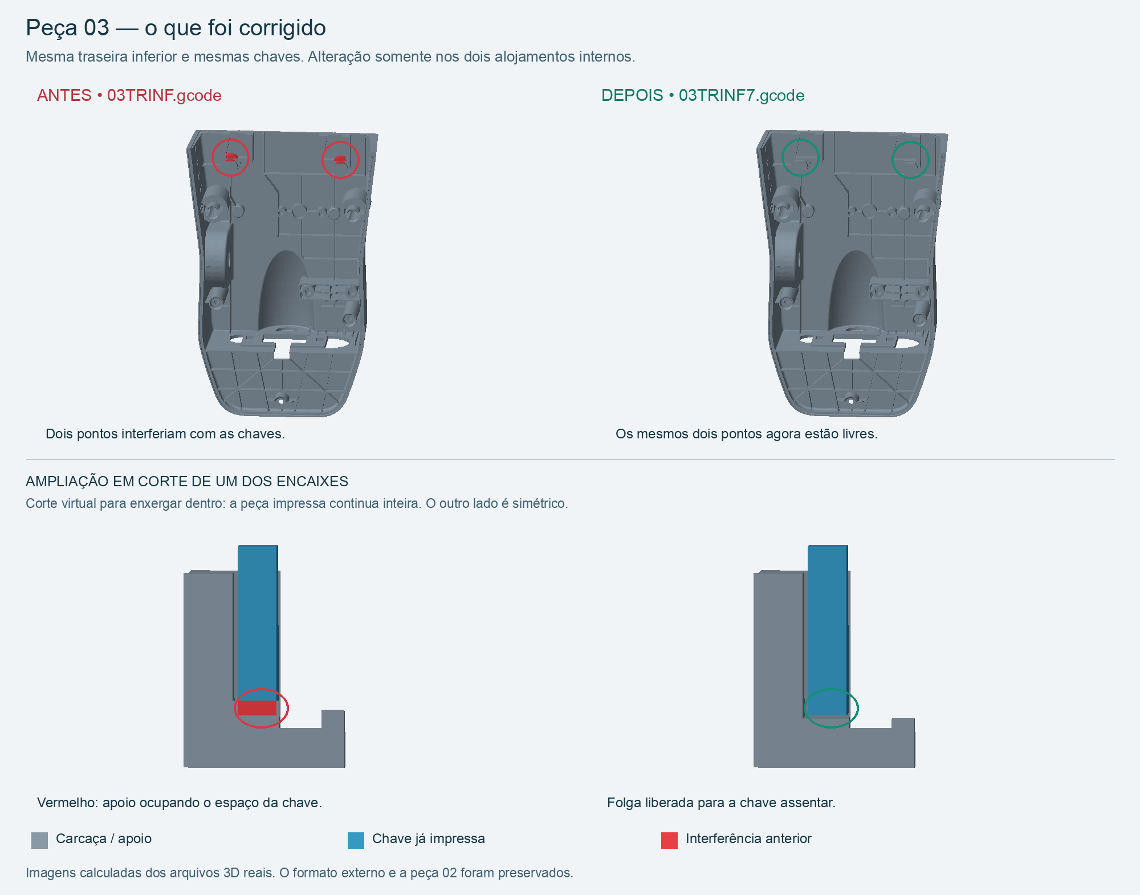
docs/prototipo-usb/imagens-correcao-v7/02-peca-03-antes-depois.png
