DJLIMA1/FIAP-ChargeGridApp-GS1-2026/docs/case-tela-waveshare-7/entrega-faculdade/STL/1-TESTE-PRIMEIRO/00-TESTE-encaixe-moldura.stl

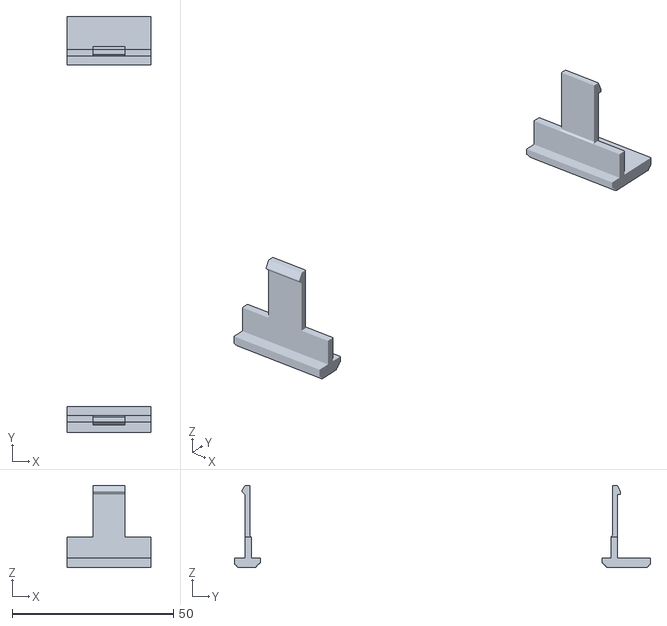
[picture p90: CAD file, 2026-10-19]
docs/case-tela-waveshare-7/entrega-faculdade/STL/1-TESTE-PRIMEIRO/00-TESTE-encaixe-moldura.stl
26.0 x 129.0 x 25.5
