DJLIMA1/FIAP-ChargeGridApp-GS1-2026/docs/case-tela-waveshare-7/entrega-faculdade/STL/2-PECAS/02-CORPO-esquerdo.stl

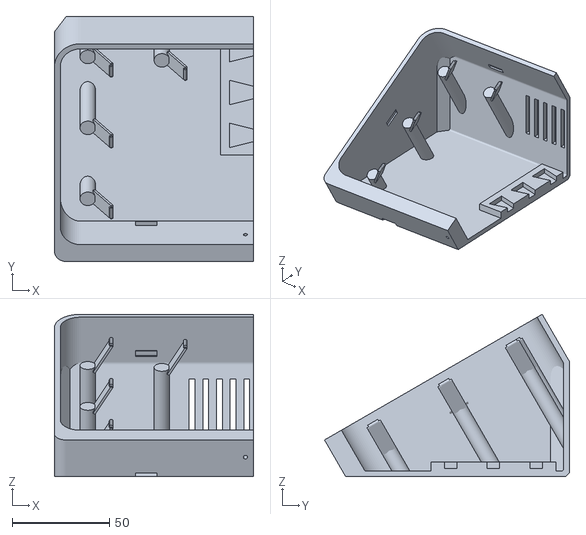
[picture p91: CAD file, 2026-10-19]
docs/case-tela-waveshare-7/entrega-faculdade/STL/2-PECAS/02-CORPO-esquerdo.stl
102.1 x 125.7 x 83.3
