DJLIMA1/FIAP-ChargeGridApp-GS1-2026/docs/case-tela-waveshare-7/stl/01-MOLDURA-direita.stl

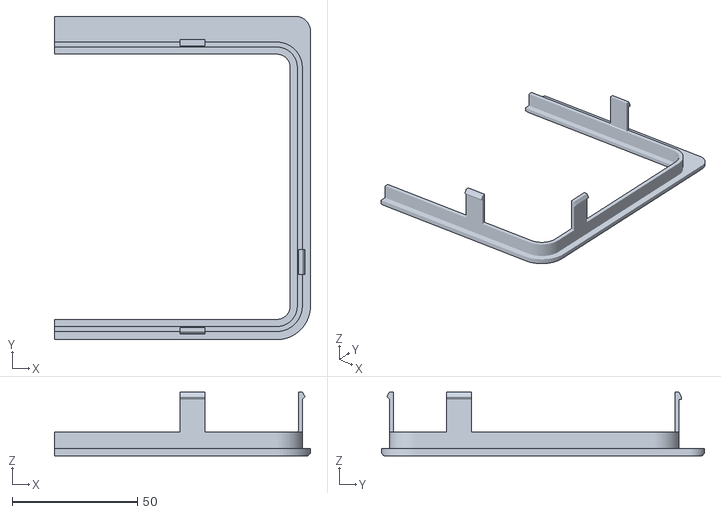
[picture p92: CAD file, 2026-10-19]
docs/case-tela-waveshare-7/stl/01-MOLDURA-direita.stl
102.1 x 129.0 x 25.5
