DJLIMA1/FIAP-ChargeGridApp-GS1-2026/docs/prototipo-usb/cad-cupons/step/trilho-femea-25.step

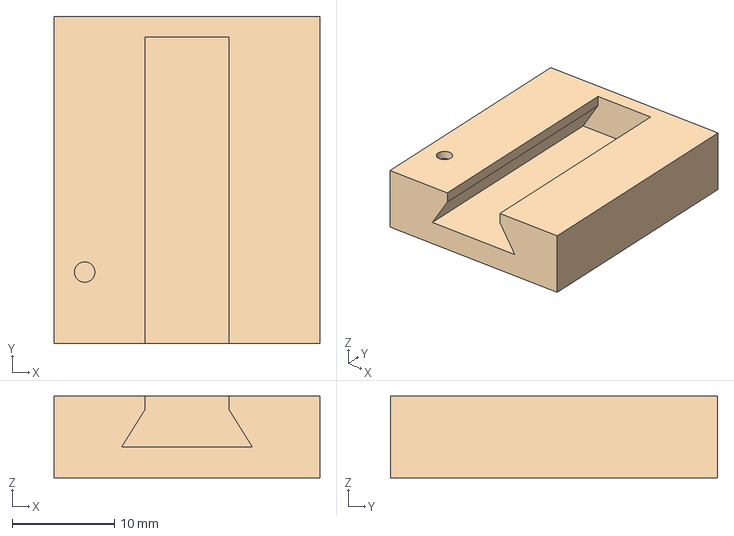
[picture p94: CAD file, 2026-10-13]
docs/prototipo-usb/cad-cupons/step/trilho-femea-25.step
26.0 x 32.0 x 8.00 mm
