DJLIMA1/FIAP-ChargeGridApp-GS1-2026/docs/prototipo-usb/cad-estudo/cassette-volumes-CONCEITO.step

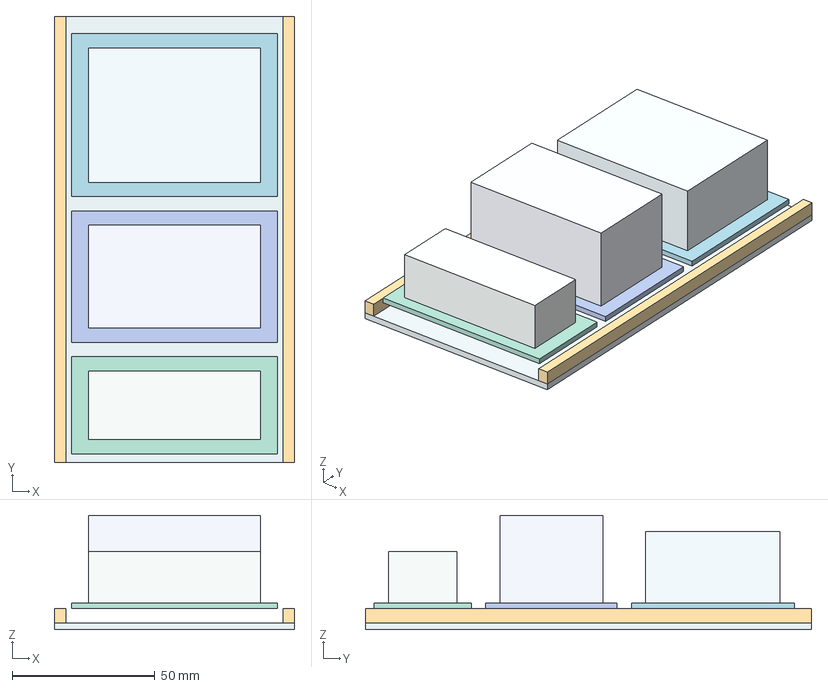
[picture p95: CAD file, 2026-10-13]
docs/prototipo-usb/cad-estudo/cassette-volumes-CONCEITO.step
84.0 x 156.0 x 40.0 mm
