DJLIMA1/FIAP-ChargeGridApp-GS1-2026/docs/prototipo-usb/cad-impressao-50-v1/montagem/ChargeGrid-50-MONTAGEM-nao-fatiar.3mf

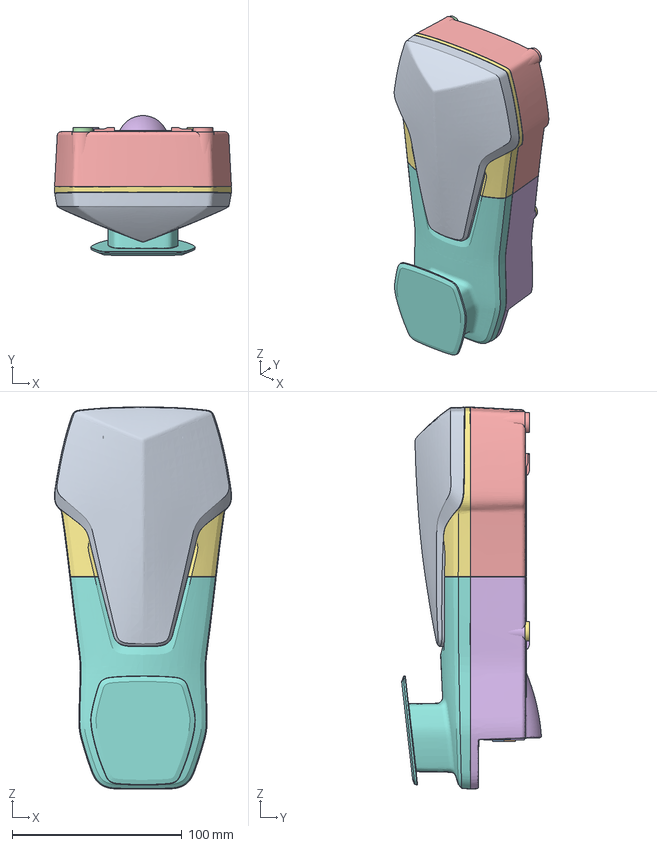
[picture p96: CAD file, 2026-10-13]
docs/prototipo-usb/cad-impressao-50-v1/montagem/ChargeGrid-50-MONTAGEM-nao-fatiar.3mf
104.3 x 82.4 x 225.0 mm
trava-bandeja-5
trava-bandeja-55
trava-berco-8
trava-berco-54
01-traseira-superior
01-traseira-inferior
03-quadro-superior
03-quadro-inferior
05-tampa-frontal
08-pino-tampa-1
08-pino-tampa-2
08-pino-tampa-3
08-pino-tampa-4
08-pino-tampa-5
09-bandeja-removivel
10-berco-potencia
11-berco-esp32
19-inserto-duplo-5mm-a
19-inserto-duplo-5mm-b
pino-casca-0
pino-casca-1
pino-casca-2
pino-casca-3
chave--22-90.8
chave--22-57.2
chave-22-90.8
chave-22-57.2
