DJLIMA1/FIAP-ChargeGridApp-GS1-2026/docs/prototipo-usb/cad-impressao-50-v1/pranchas/06-internos-e-fixacoes.3mf

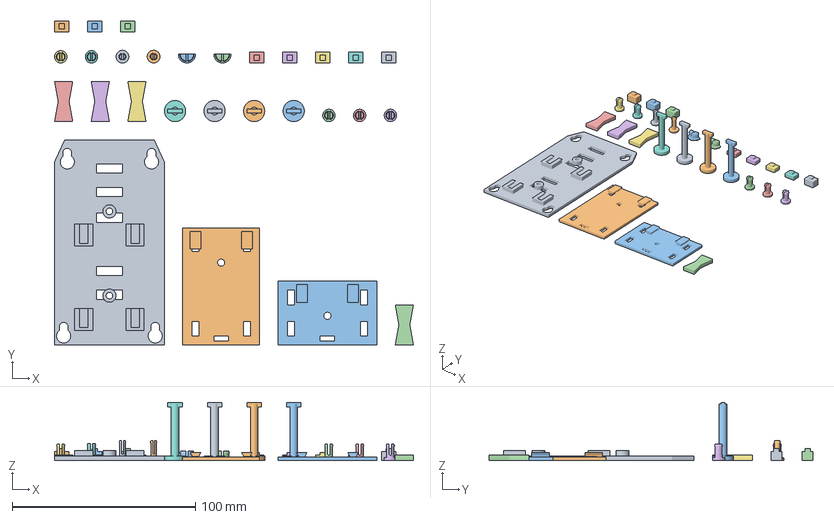
[picture p97: CAD file, 2026-10-13]
docs/prototipo-usb/cad-impressao-50-v1/pranchas/06-internos-e-fixacoes.3mf
196.0 x 177.0 x 31.7 mm
09-bandeja-removivel--1
11-berco-esp32--1
10-berco-potencia--1
06-chave-emenda--1
06-chave-emenda--2
06-chave-emenda--3
06-chave-emenda--4
07-pino-quarto-volta--1
07-pino-quarto-volta--2
07-pino-quarto-volta--3
07-pino-quarto-volta--4
08-pino-tampa-1--1
08-pino-tampa-2--1
08-pino-tampa-3--1
08-pino-tampa-4--1
08-pino-tampa-5--1
12-pino-trava-berco--1
12-pino-trava-berco--2
13-trava-bandeja--1
13-trava-bandeja--2
14-espacador-3mm--1
14-espacador-3mm--2
14-espacador-3mm--3
14-espacador-3mm--4
14-espacador-5mm--1
14-espacador-5mm--2
14-espacador-5mm--3
14-espacador-5mm--4
