DJLIMA1/FIAP-ChargeGridApp-GS1-2026/docs/prototipo-usb/cad-impressao-50-v1/stl/19-inserto-6mm-b.stl

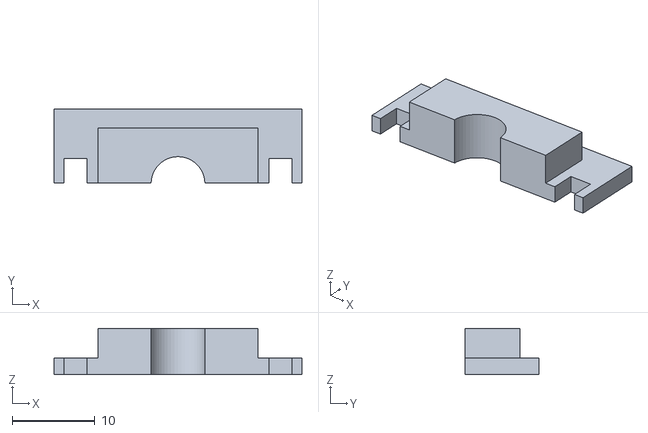
[picture p98: CAD file, 2026-10-13]
docs/prototipo-usb/cad-impressao-50-v1/stl/19-inserto-6mm-b.stl
30.0 x 8.93 x 5.60
