DJLIMA1/FIAP-ChargeGridApp-GS1-2026/docs/prototipo-usb/cad-referencia/cassete-r2-36mm-POSICIONADO-ESTUDO.step

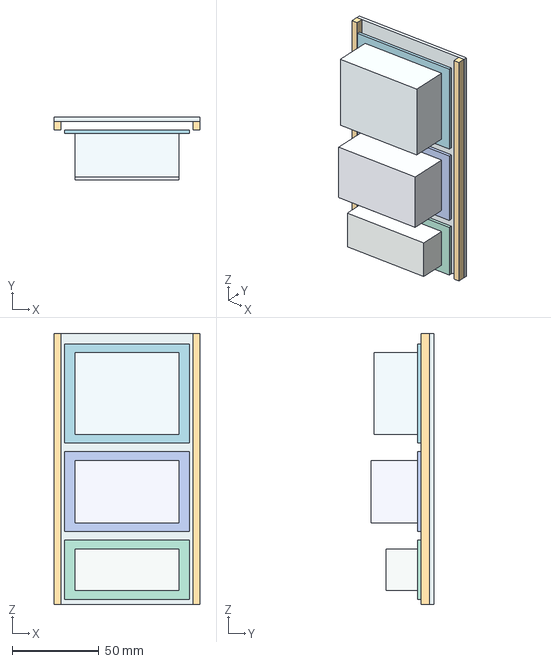
[picture p99: CAD file, 2026-10-13]
docs/prototipo-usb/cad-referencia/cassete-r2-36mm-POSICIONADO-ESTUDO.step
84.0 x 36.0 x 156.0 mm
