DJLIMA1/FIAP-ChargeGridApp-GS1-2026/docs/prototipo-usb/ender3-original-pla-v1/00-teste-encaixes/00-teste-encaixes.3mf

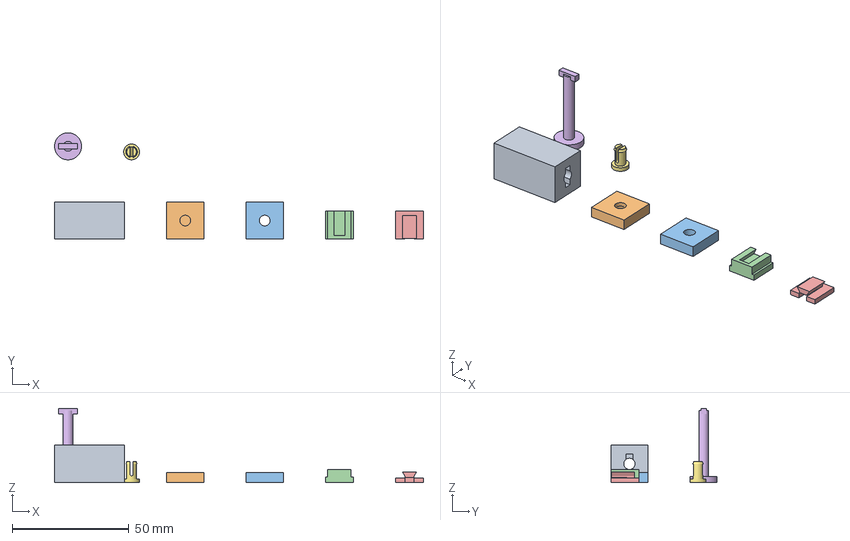
[picture p100: CAD file, 2026-10-20]
docs/prototipo-usb/ender3-original-pla-v1/00-teste-encaixes/00-teste-encaixes.3mf
158.0 x 45.6 x 31.7 mm
16-cupom-quarto-volta-1
17-cupom-bucha-tampa-1
18-cupom-placa-tampa-1
20-cupom-trilho-berco-1
21-cupom-macho-berco-1
07-pino-quarto-volta-1
08-pino-tampa-1-1
