DJLIMA1/FIAP-ChargeGridApp-GS1-2026/docs/prototipo-usb/ender3-original-pla-v1/01-tampa-branca/01-tampa-branca.3mf

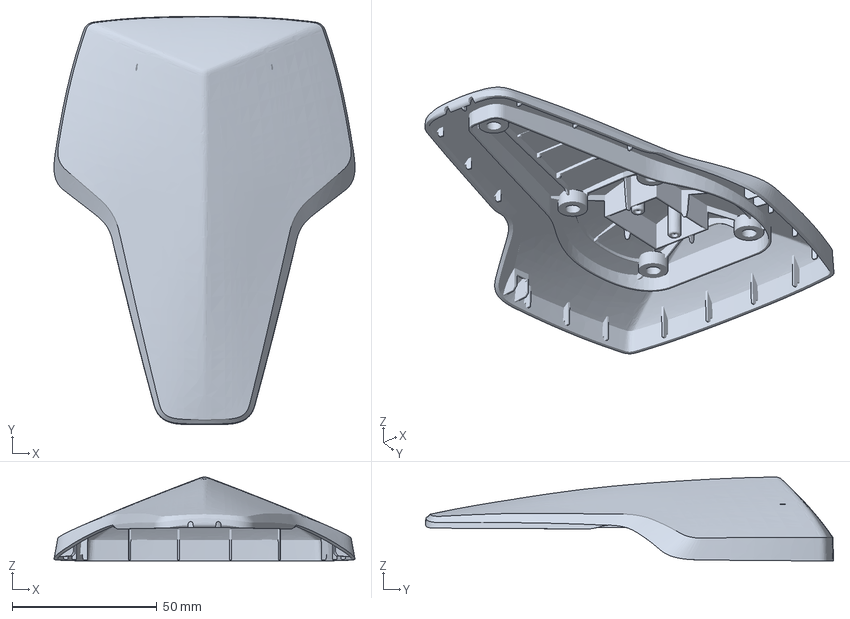
[picture p101: CAD file, 2026-10-20]
docs/prototipo-usb/ender3-original-pla-v1/01-tampa-branca/01-tampa-branca.3mf
104.0 x 141.0 x 29.0 mm
