DJLIMA1/FIAP-ChargeGridApp-GS1-2026/docs/prototipo-usb/ender3-original-pla-v1/02-traseira-superior/02-traseira-superior.3mf

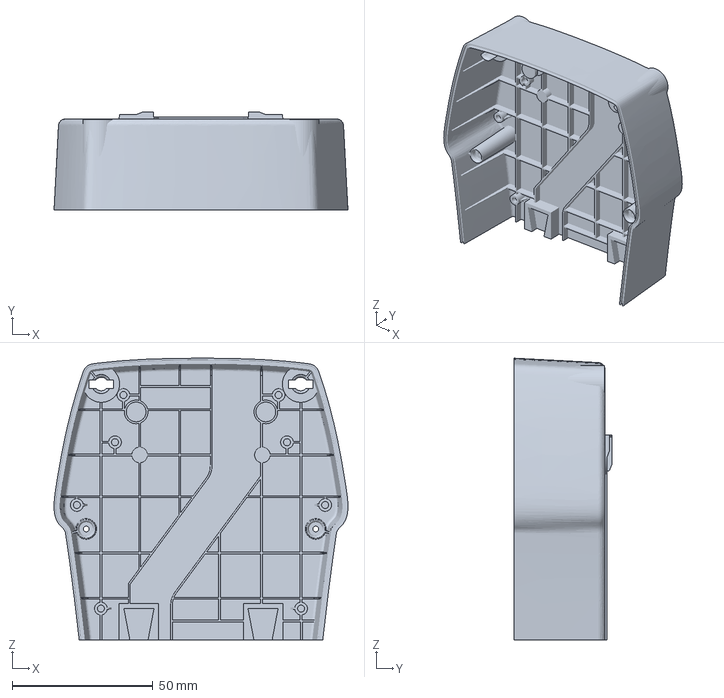
[picture p102: CAD file, 2026-10-20]
docs/prototipo-usb/ender3-original-pla-v1/02-traseira-superior/02-traseira-superior.3mf
104.3 x 34.9 x 99.9 mm
