DJLIMA1/FIAP-ChargeGridApp-GS1-2026/docs/prototipo-usb/ender3-original-pla-v1/03-traseira-inferior/03-traseira-inferior.3mf

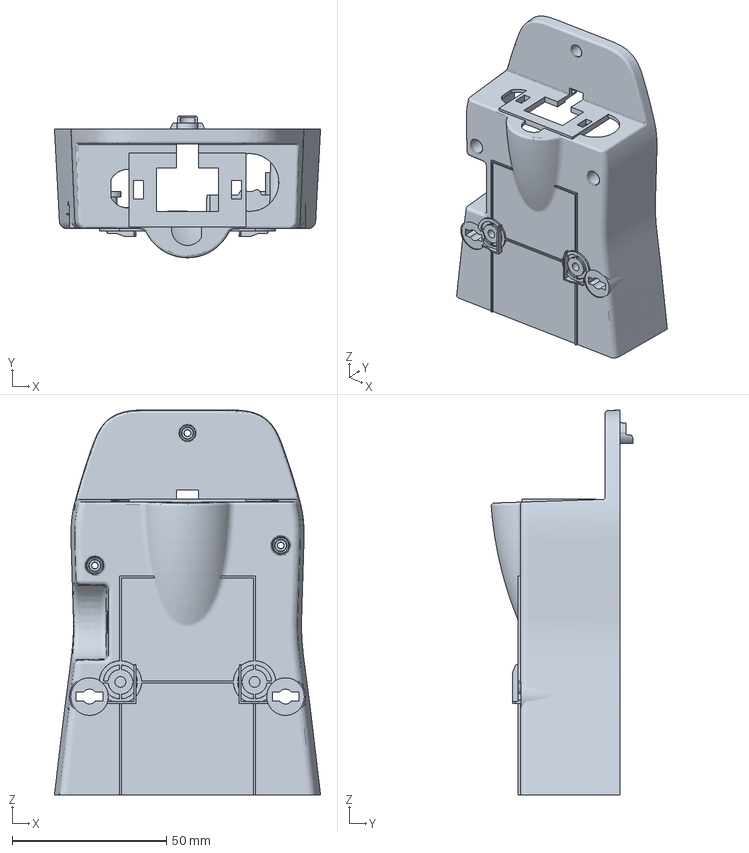
[picture p103: CAD file, 2026-10-20]
docs/prototipo-usb/ender3-original-pla-v1/03-traseira-inferior/03-traseira-inferior.3mf
86.3 x 45.9 x 124.9 mm
