DJLIMA1/FIAP-ChargeGridApp-GS1-2026/docs/prototipo-usb/ender3-original-pla-v1/04-quadro-superior/04-quadro-superior.3mf

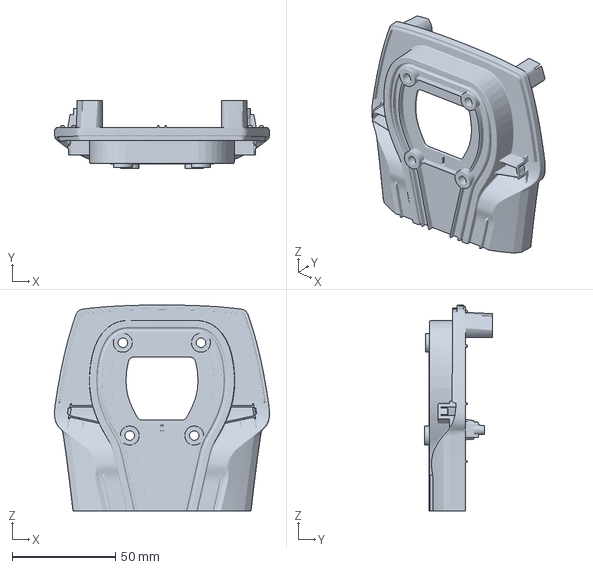
[picture p104: CAD file, 2026-10-20]
docs/prototipo-usb/ender3-original-pla-v1/04-quadro-superior/04-quadro-superior.3mf
104.3 x 33.0 x 99.9 mm
