DJLIMA1/FIAP-ChargeGridApp-GS1-2026/docs/prototipo-usb/ender3-original-pla-v1/05-quadro-inferior/05-quadro-inferior.3mf

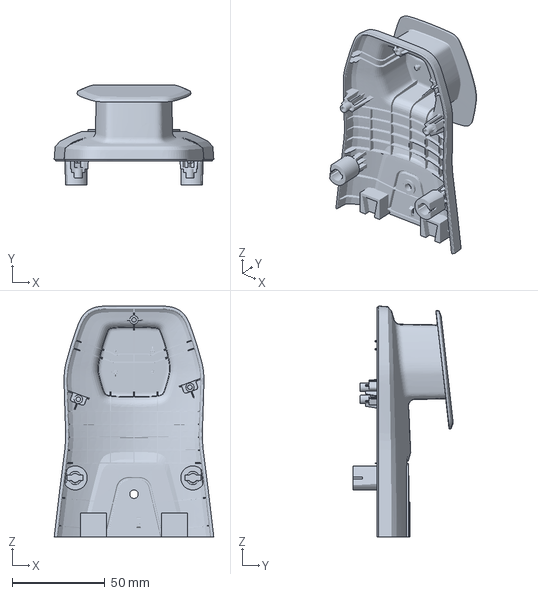
[picture p105: CAD file, 2026-10-20]
docs/prototipo-usb/ender3-original-pla-v1/05-quadro-inferior/05-quadro-inferior.3mf
86.3 x 54.3 x 124.9 mm
