DJLIMA1/FIAP-ChargeGridApp-GS1-2026/docs/prototipo-usb/ender3-original-pla-v1/06-chaves-das-emendas/06-chaves-das-emendas.3mf

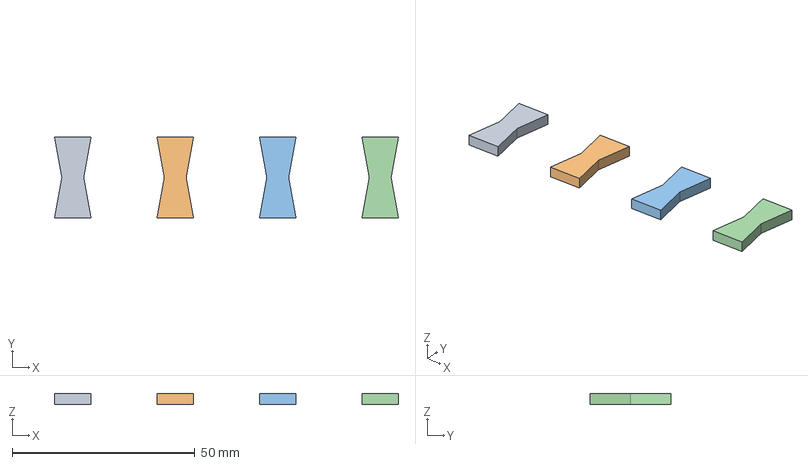
[picture p106: CAD file, 2026-10-20]
docs/prototipo-usb/ender3-original-pla-v1/06-chaves-das-emendas/06-chaves-das-emendas.3mf
94.0 x 22.0 x 3.00 mm
06-chave-emenda-1
06-chave-emenda-2
06-chave-emenda-3
06-chave-emenda-4
