DJLIMA1/FIAP-ChargeGridApp-GS1-2026/docs/prototipo-usb/ender3-original-pla-v1/07-pinos-quarto-de-volta/07-pinos-quarto-de-volta.3mf

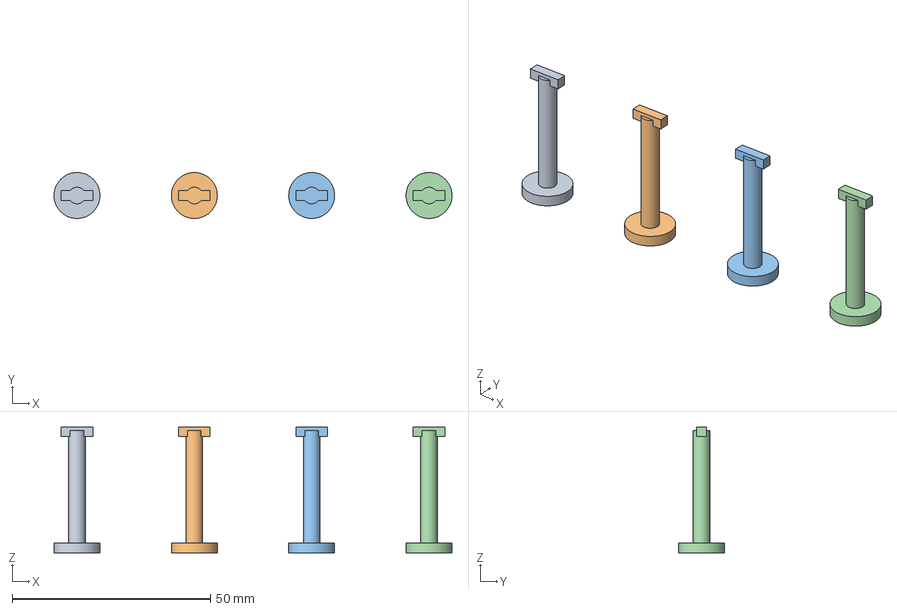
[picture p107: CAD file, 2026-10-20]
docs/prototipo-usb/ender3-original-pla-v1/07-pinos-quarto-de-volta/07-pinos-quarto-de-volta.3mf
100.4 x 11.6 x 31.7 mm
07-pino-quarto-volta-1
07-pino-quarto-volta-2
07-pino-quarto-volta-3
07-pino-quarto-volta-4
