DJLIMA1/FIAP-ChargeGridApp-GS1-2026/docs/prototipo-usb/ender3-original-pla-v1/08-pinos-tampa-branca/08-pinos-tampa-branca.3mf

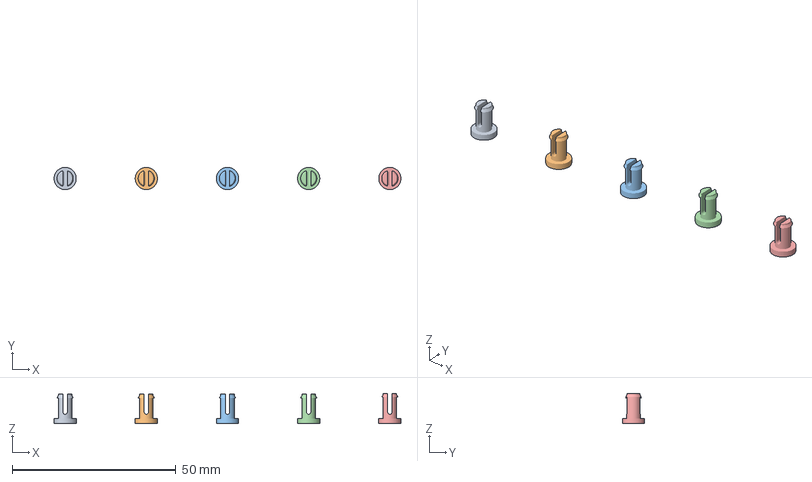
[picture p108: CAD file, 2026-10-20]
docs/prototipo-usb/ender3-original-pla-v1/08-pinos-tampa-branca/08-pinos-tampa-branca.3mf
106.0 x 6.80 x 9.25 mm
08-pino-tampa-1-1
08-pino-tampa-2-1
08-pino-tampa-3-1
08-pino-tampa-4-1
08-pino-tampa-5-1
