DJLIMA1/FIAP-ChargeGridApp-GS1-2026/docs/prototipo-usb/ender3-original-pla-v1/09-bandeja-e-bercos/09-bandeja-e-bercos.3mf

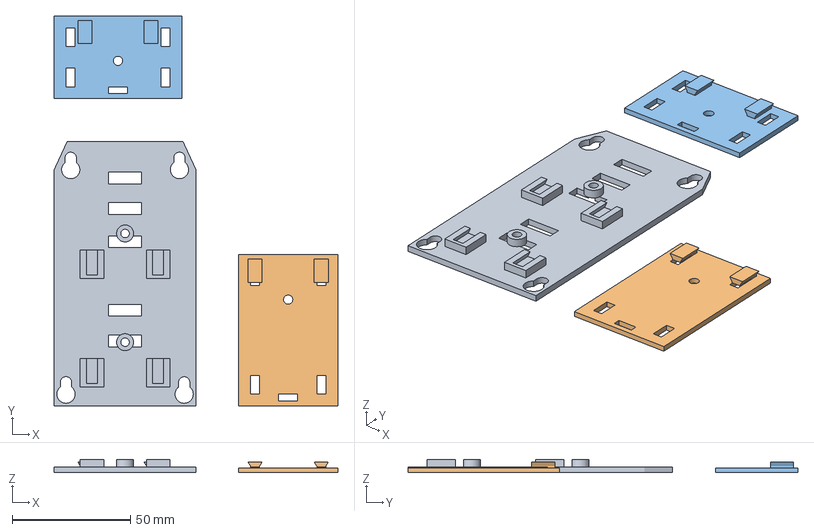
[picture p109: CAD file, 2026-10-20]
docs/prototipo-usb/ender3-original-pla-v1/09-bandeja-e-bercos/09-bandeja-e-bercos.3mf
120.0 x 165.0 x 5.55 mm
09-bandeja-removivel-1
11-berco-esp32-1
10-berco-potencia-1
