DJLIMA1/FIAP-ChargeGridApp-GS1-2026/docs/prototipo-usb/ender3-original-pla-v1/10-travas-e-espacadores/10-travas-e-espacadores.3mf

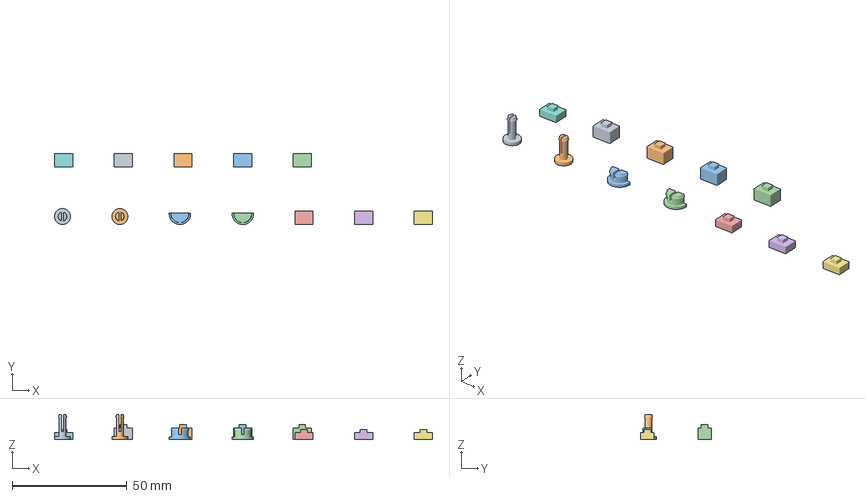
[picture p110: CAD file, 2026-10-20]
docs/prototipo-usb/ender3-original-pla-v1/10-travas-e-espacadores/10-travas-e-espacadores.3mf
164.8 x 31.0 x 11.0 mm
12-pino-trava-berco-1
12-pino-trava-berco-2
13-trava-bandeja-1
13-trava-bandeja-2
14-espacador-3mm-1
14-espacador-3mm-2
14-espacador-3mm-3
14-espacador-3mm-4
14-espacador-5mm-1
14-espacador-5mm-2
14-espacador-5mm-3
14-espacador-5mm-4
