DJLIMA1/FIAP-ChargeGridApp-GS1-2026/docs/prototipo-usb/ender3-original-pla-v1/11-cabos-duplos-5mm-OPCIONAL/11-cabos-duplos-5mm-OPCIONAL.3mf

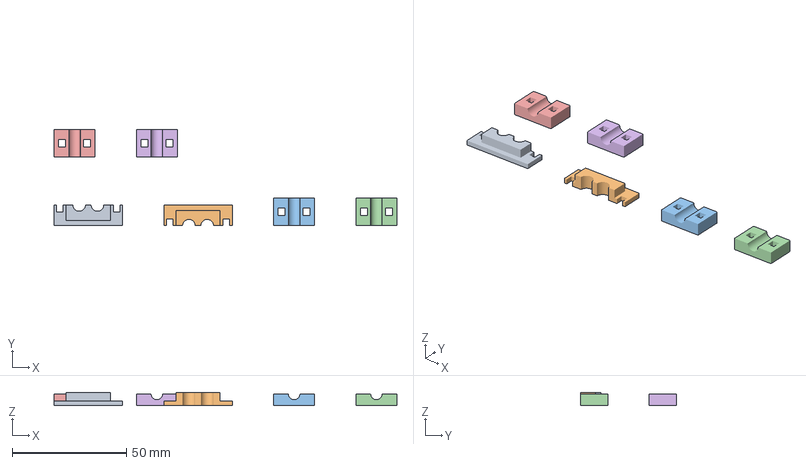
[picture p111: CAD file, 2026-10-20]
docs/prototipo-usb/ender3-original-pla-v1/11-cabos-duplos-5mm-OPCIONAL/11-cabos-duplos-5mm-OPCIONAL.3mf
150.0 x 42.0 x 5.60 mm
19-inserto-duplo-5mm-a-1
19-inserto-duplo-5mm-b-1
15-prensa-cabo-5mm-meia-1
15-prensa-cabo-5mm-meia-2
15-prensa-cabo-5mm-meia-3
15-prensa-cabo-5mm-meia-4
