DJLIMA1/FIAP-ChargeGridApp-GS1-2026/docs/prototipo-usb/ender3-original-pla-v1/pecas-individuais/19-inserto-4mm-b.stl

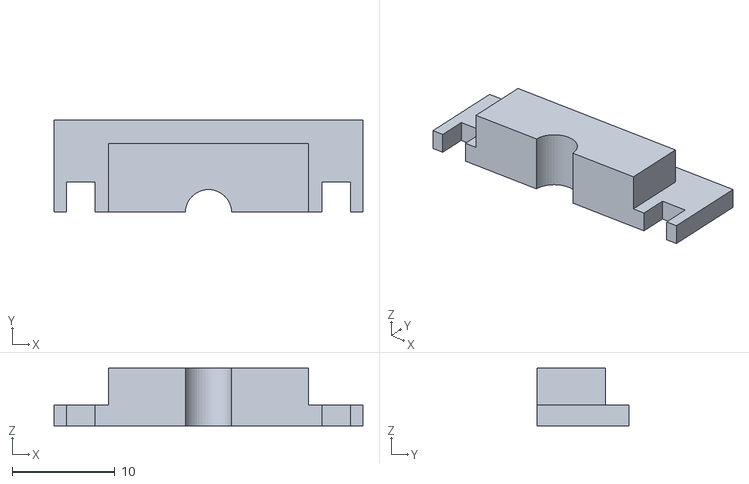
[picture p112: CAD file, 2026-10-20]
docs/prototipo-usb/ender3-original-pla-v1/pecas-individuais/19-inserto-4mm-b.stl
30.0 x 8.93 x 5.60
