DJLIMA1/FIAP-ChargeGridApp-GS1-2026/docs/prototipo-usb/ender3-pla-oficial-v6/stl/09-bandeja-removivel.stl

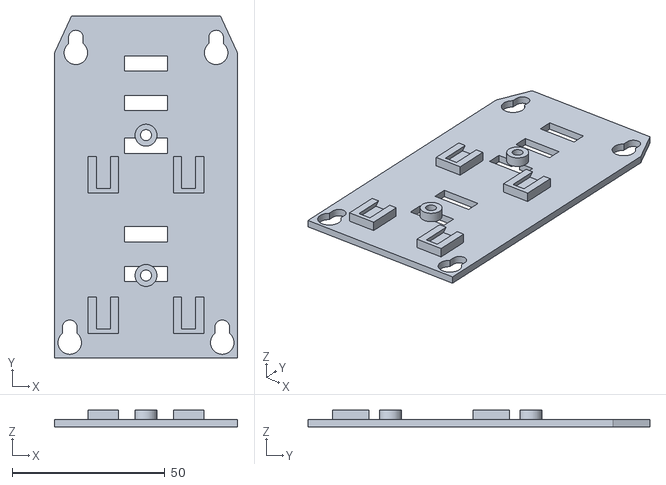
[picture p113: CAD file, 2026-10-20]
docs/prototipo-usb/ender3-pla-oficial-v6/stl/09-bandeja-removivel.stl
60.0 x 112.0 x 5.55
