DJLIMA1/FIAP-ChargeGridApp-GS1-2026/docs/prototipo-usb/ender3-pla-oficial-v7/stl/06-chave-emenda.stl

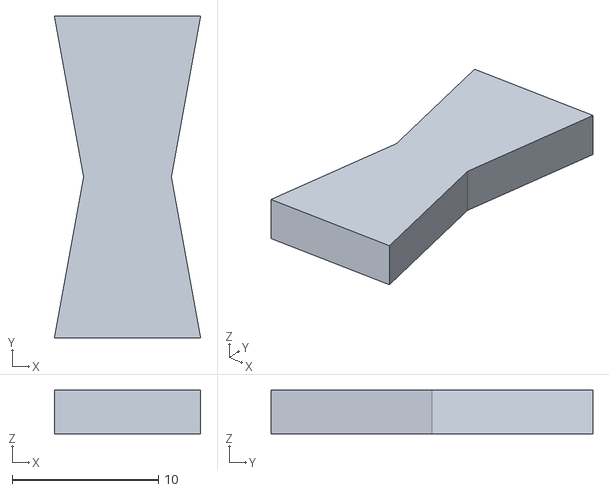
[picture p114: CAD file, 2026-10-20]
docs/prototipo-usb/ender3-pla-oficial-v7/stl/06-chave-emenda.stl
10.0 x 22.0 x 3.00
