DJLIMA1/FIAP-ChargeGridApp-GS1-2026/docs/prototipo-usb/ender3-pla-oficial-v8/projetos/10BERCO8.3mf

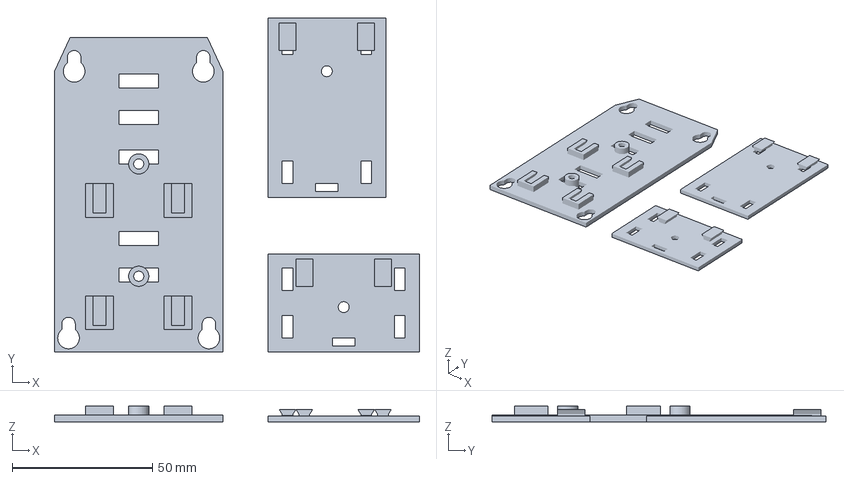
[picture p115: CAD file, 2026-10-20]
docs/prototipo-usb/ender3-pla-oficial-v8/projetos/10BERCO8.3mf
130.0 x 119.0 x 5.55 mm
