DJLIMA1/FIAP-ChargeGridApp-GS1-2026/docs/prototipo-usb/ender3-pla-oficial-v8/stl/12-pino-trava-berco.stl

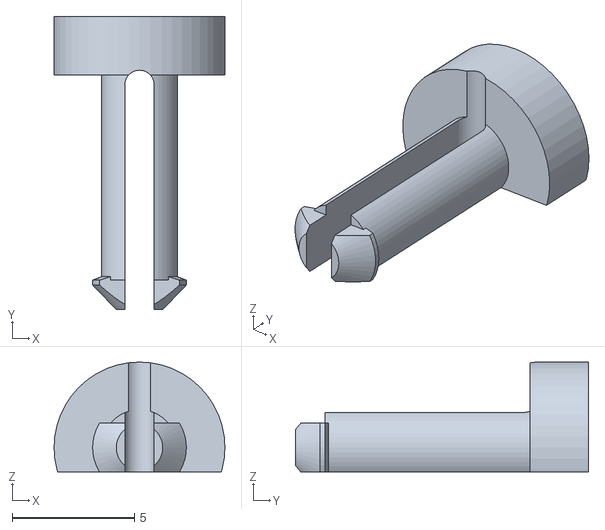
[picture p116: CAD file, 2026-10-20]
docs/prototipo-usb/ender3-pla-oficial-v8/stl/12-pino-trava-berco.stl
7.00 x 12.0 x 4.50
