DJLIMA1/FIAP-ChargeGridApp-GS1-2026/docs/prototipo-usb/ender3-pla-oficial-v9/modelos-fatiados/11TRAVA9.stl

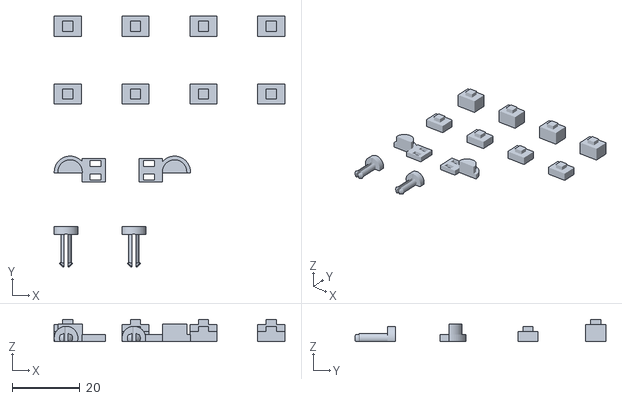
[picture p117: CAD file, 2026-10-20]
docs/prototipo-usb/ender3-pla-oficial-v9/modelos-fatiados/11TRAVA9.stl
68.0 x 74.0 x 6.50
