DJLIMA1/FIAP-ChargeGridApp-GS1-2026/docs/prototipo-usb/ender3-pla-oficial-v9/stl/15-prensa-cabo-5mm-meia.stl

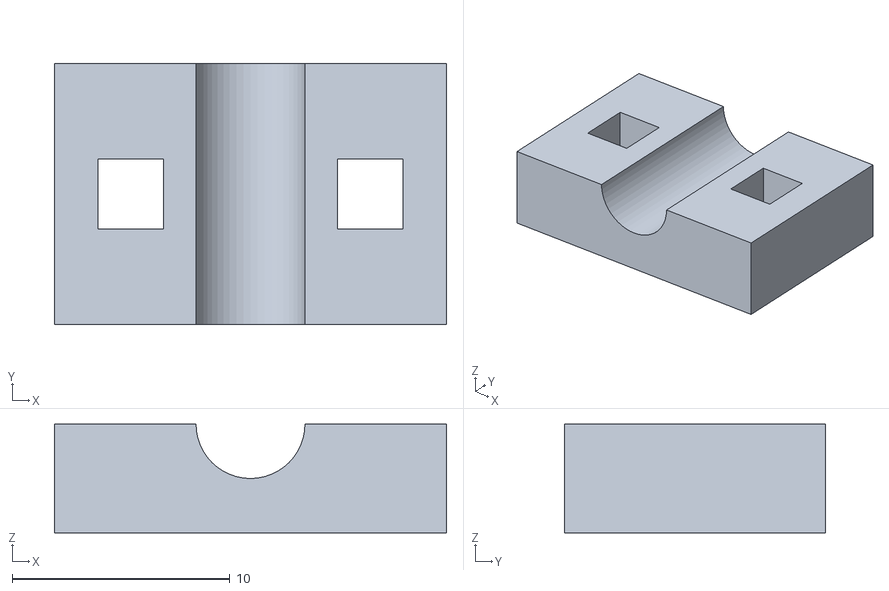
[picture p118: CAD file, 2026-10-20]
docs/prototipo-usb/ender3-pla-oficial-v9/stl/15-prensa-cabo-5mm-meia.stl
18.0 x 12.0 x 5.00
