DJLIMA1/FIAP-ChargeGridApp-GS1-2026/docs/prototipo-usb/faculdade-stl-v9/STL/PENDENTES/07PTAMP.stl

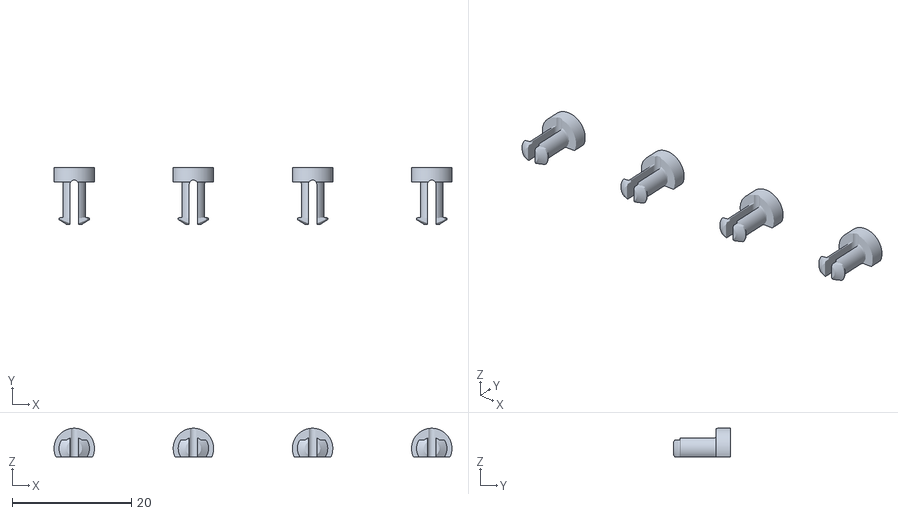
[picture p119: CAD file, 2026-10-20]
docs/prototipo-usb/faculdade-stl-v9/STL/PENDENTES/07PTAMP.stl
66.8 x 9.55 x 4.80
