DJLIMA1/FIAP-ChargeGridApp-GS1-2026/docs/prototipo-usb/revisao-independente-v9/cinta-esquerda-envelope.stl

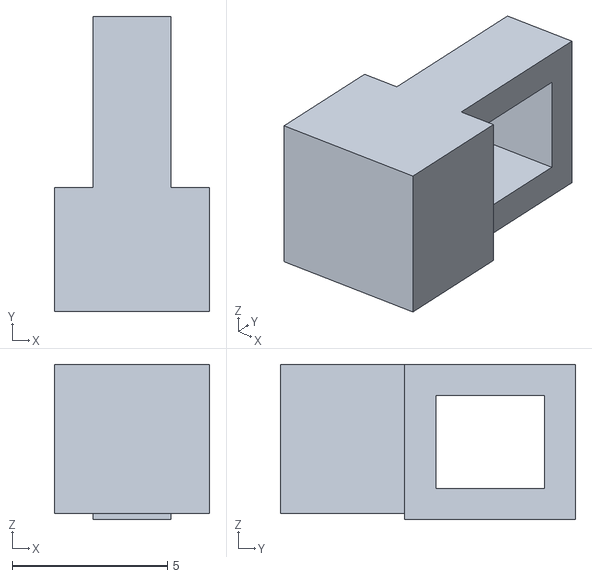
[picture p120: CAD file, 2026-10-20]
docs/prototipo-usb/revisao-independente-v9/cinta-esquerda-envelope.stl
5.00 x 9.50 x 5.00
