DJLIMA1/FIAP-ChargeGridApp-GS1-2026/docs/prototipo-usb/teste-trava-pla-v5/modelos-fatiados/00FIXA5.stl

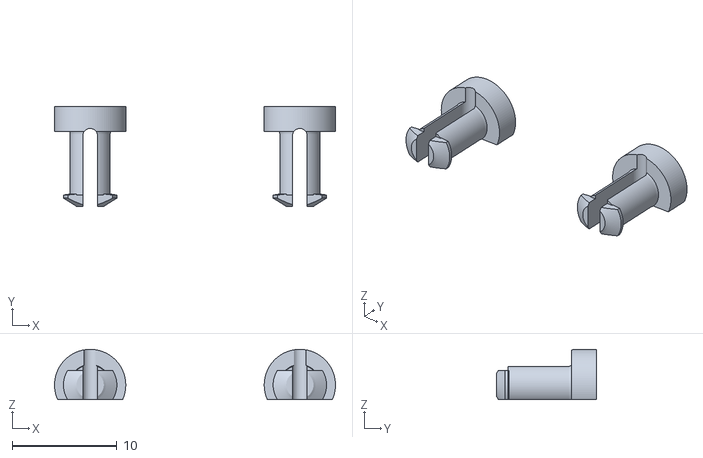
[picture p121: CAD file, 2026-10-20]
docs/prototipo-usb/teste-trava-pla-v5/modelos-fatiados/00FIXA5.stl
26.8 x 9.55 x 4.80
