DJLIMA1/FIAP-ChargeGridApp-GS1-2026/docs/case-tela-waveshare-7/entrega-faculdade/STL/1-TESTE-PRIMEIRO/00-TESTE-encaixe-corpo.stl

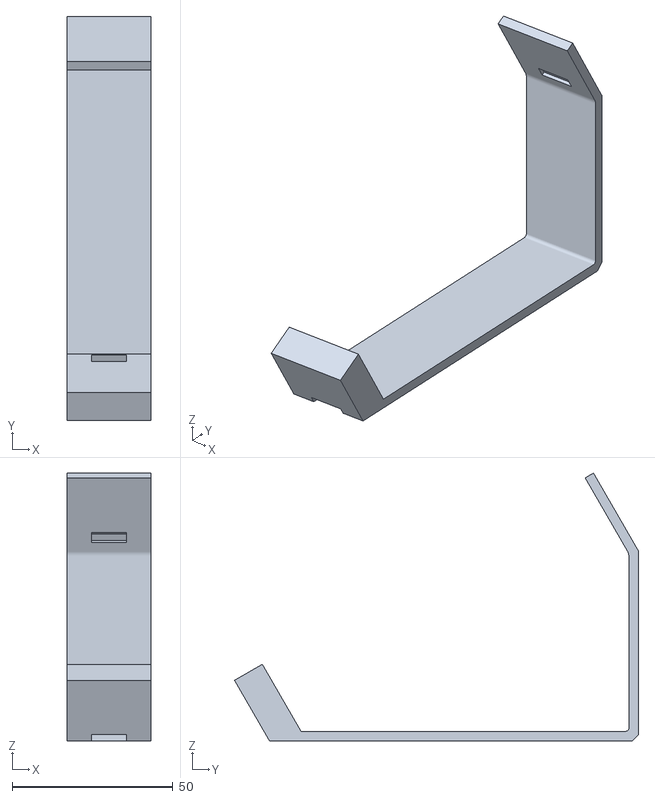
[picture p122: CAD file, 2026-10-19]
docs/case-tela-waveshare-7/entrega-faculdade/STL/1-TESTE-PRIMEIRO/00-TESTE-encaixe-corpo.stl
26.0 x 125.7 x 83.3
