DJLIMA1/FIAP-ChargeGridApp-GS1-2026/docs/case-tela-waveshare-7/stl/02-CORPO-direito.stl

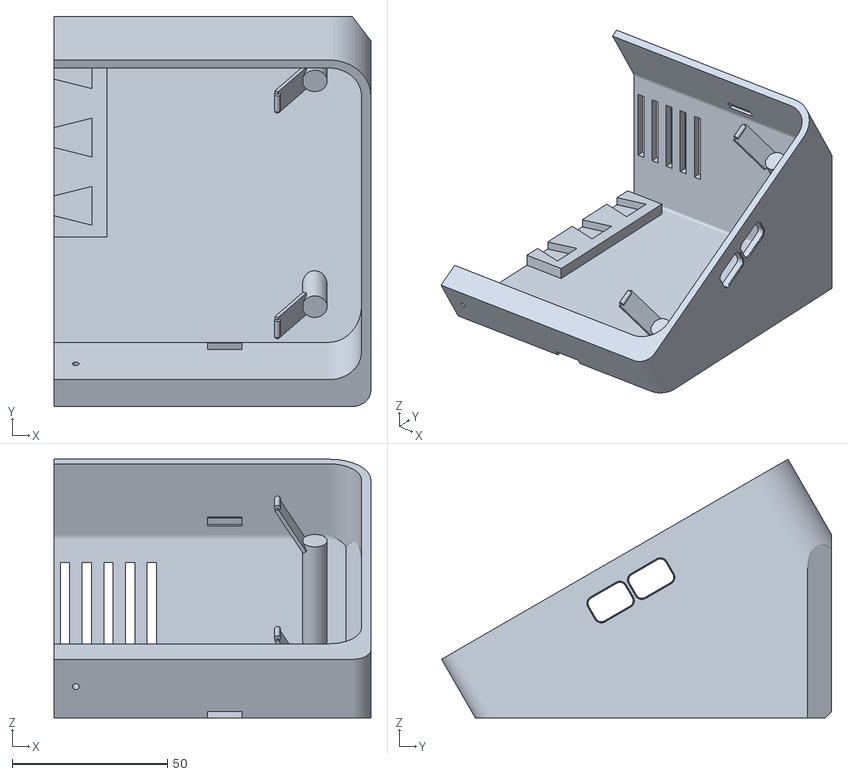
[picture p123: CAD file, 2026-10-19]
docs/case-tela-waveshare-7/stl/02-CORPO-direito.stl
102.1 x 125.7 x 83.3
