DJLIMA1/FIAP-ChargeGridApp-GS1-2026/docs/case-tela-waveshare-7/verificacao/montagem-corpo.stl

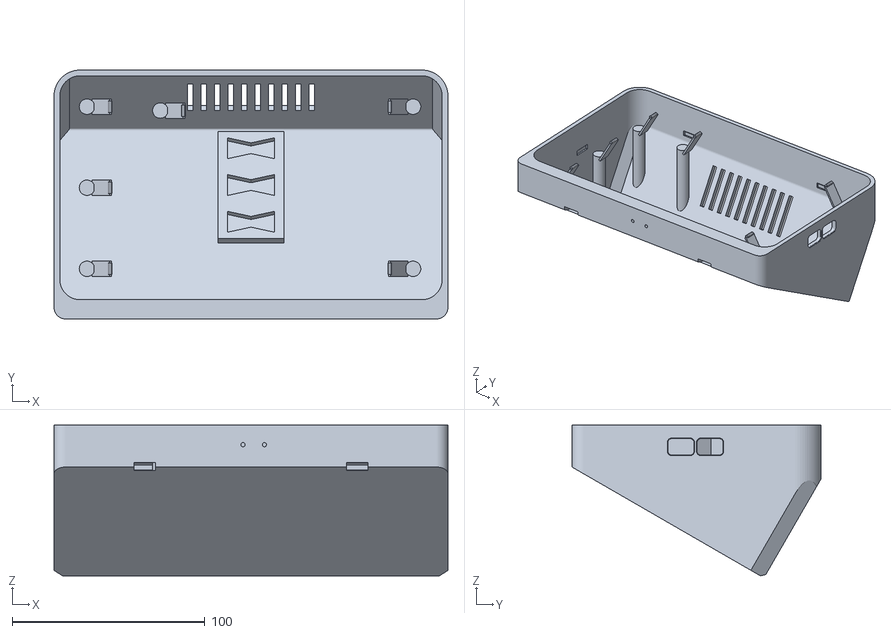
[picture p124: CAD file, 2026-10-19]
docs/case-tela-waveshare-7/verificacao/montagem-corpo.stl
204.2 x 129.0 x 78.2
