DJLIMA1/FIAP-ChargeGridApp-GS1-2026/docs/prototipo-usb/cad-impressao-50-v1/stl/21-cupom-macho-berco.stl

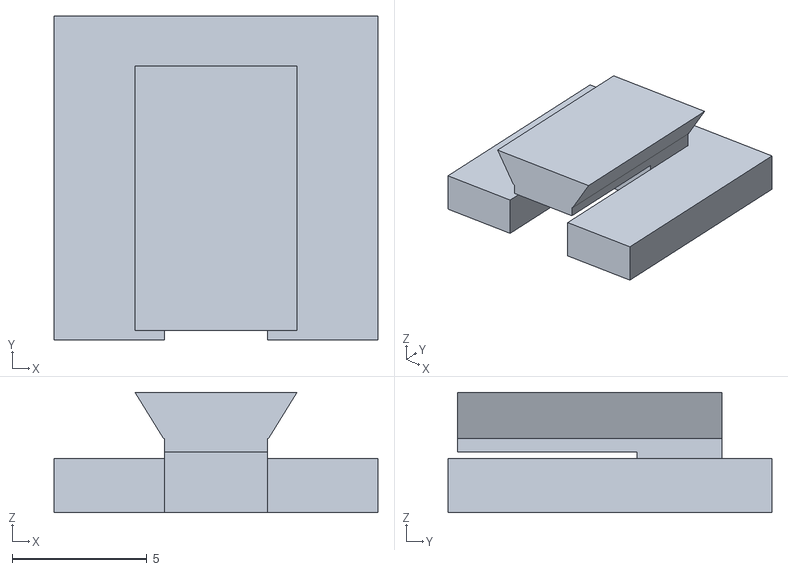
[picture p125: CAD file, 2026-10-13]
docs/prototipo-usb/cad-impressao-50-v1/stl/21-cupom-macho-berco.stl
12.0 x 12.0 x 4.45
