DJLIMA1/FIAP-ChargeGridApp-GS1-2026/docs/prototipo-usb/ender3-pla-gcode-v1/projetos/00TESTE.3mf

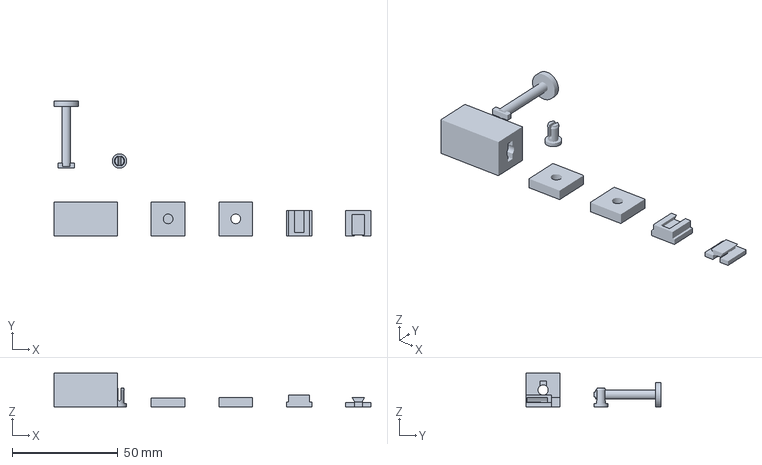
[picture p126: CAD file, 2026-10-20]
docs/prototipo-usb/ender3-pla-gcode-v1/projetos/00TESTE.3mf
150.0 x 63.7 x 16.0 mm
