DJLIMA1/FIAP-ChargeGridApp-GS1-2026/docs/prototipo-usb/ender3-pla-oficial-v6/modelos-fatiados/08PTINF.stl

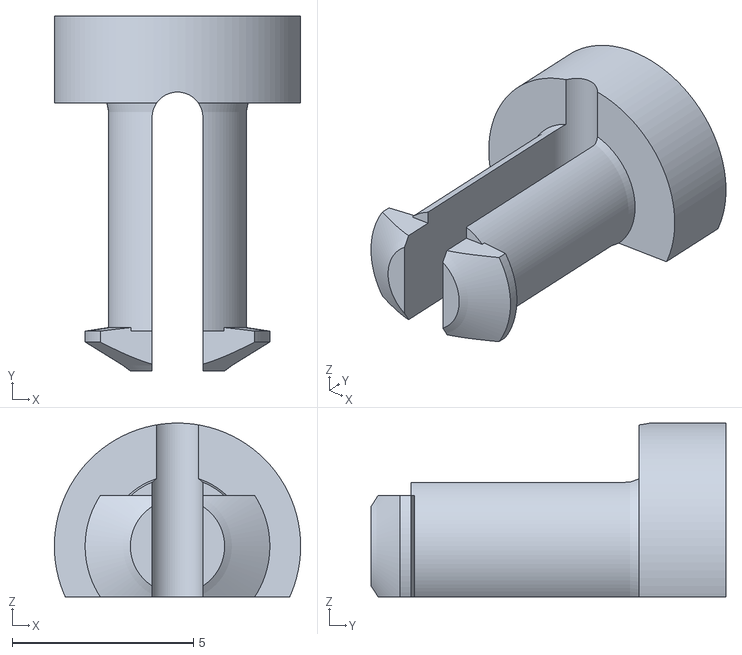
[picture p127: CAD file, 2026-10-20]
docs/prototipo-usb/ender3-pla-oficial-v6/modelos-fatiados/08PTINF.stl
6.80 x 9.80 x 4.80
