DJLIMA1/FIAP-ChargeGridApp-GS1-2026/docs/prototipo-usb/ender3-pla-oficial-v6/stl/07-pino-quarto-volta.stl

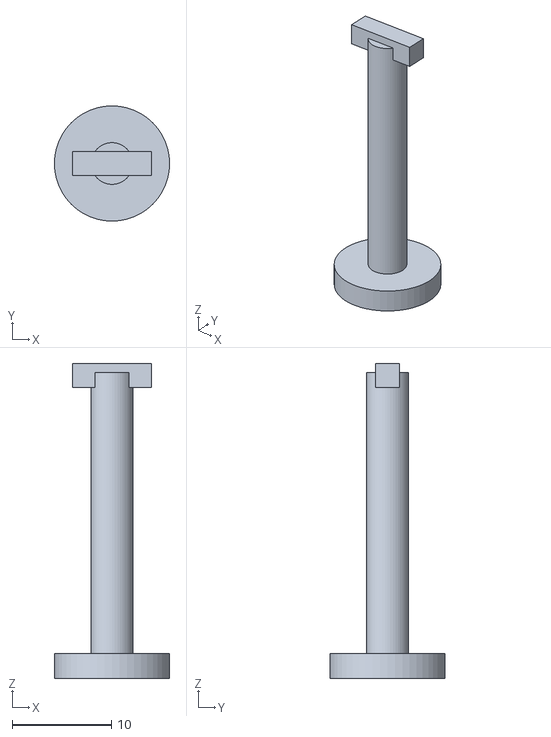
[picture p128: CAD file, 2026-10-20]
docs/prototipo-usb/ender3-pla-oficial-v6/stl/07-pino-quarto-volta.stl
11.6 x 11.6 x 31.7
