DJLIMA1/FIAP-ChargeGridApp-GS1-2026/docs/prototipo-usb/ender3-pla-oficial-v8/projetos/11TRAVA8.3mf

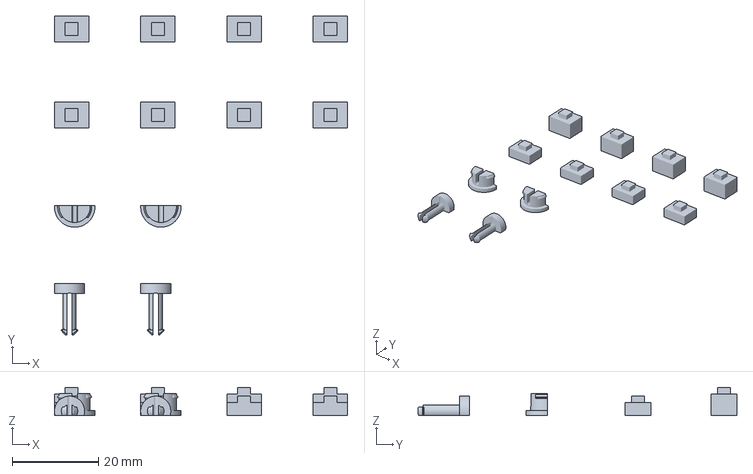
[picture p129: CAD file, 2026-10-20]
docs/prototipo-usb/ender3-pla-oficial-v8/projetos/11TRAVA8.3mf
68.0 x 74.0 x 6.50 mm
