DJLIMA1/FIAP-ChargeGridApp-GS1-2026/docs/prototipo-usb/ender3-pla-oficial-v8/stl/13-trava-bandeja.stl

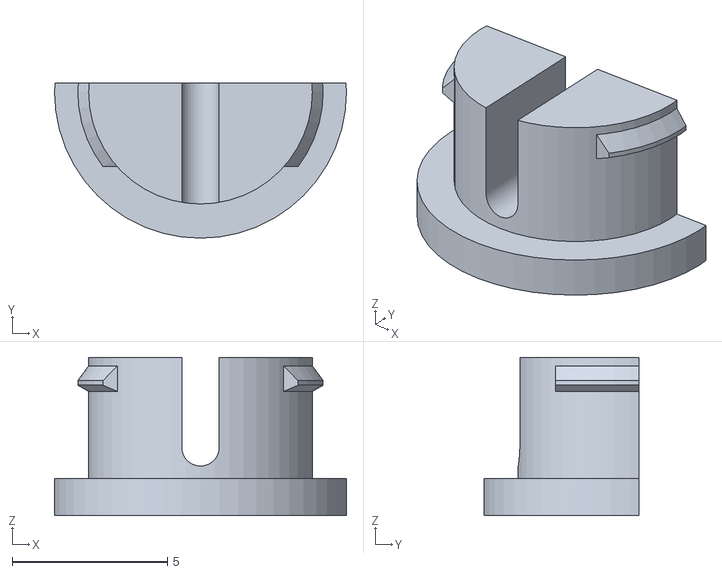
[picture p130: CAD file, 2026-10-20]
docs/prototipo-usb/ender3-pla-oficial-v8/stl/13-trava-bandeja.stl
9.40 x 5.00 x 5.10
