DJLIMA1/FIAP-ChargeGridApp-GS1-2026/docs/case-tela-waveshare-7/entrega-faculdade/STL/2-PECAS/04-CHAVES-8un.stl

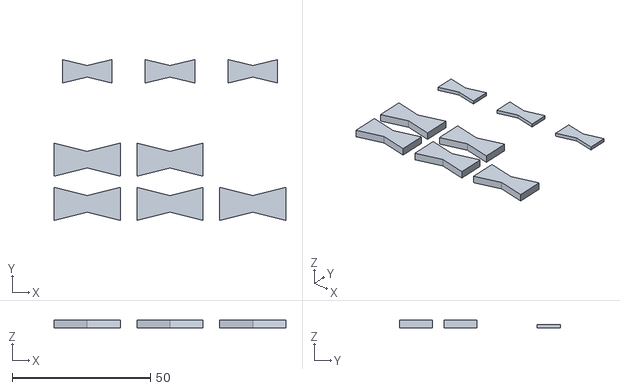
[picture p131: CAD file, 2026-10-19]
docs/case-tela-waveshare-7/entrega-faculdade/STL/2-PECAS/04-CHAVES-8un.stl
84.0 x 58.2 x 3.00
