DJLIMA1/FIAP-ChargeGridApp-GS1-2026/docs/case-tela-waveshare-7/stl/00-TESTE-encaixe-corpo.stl

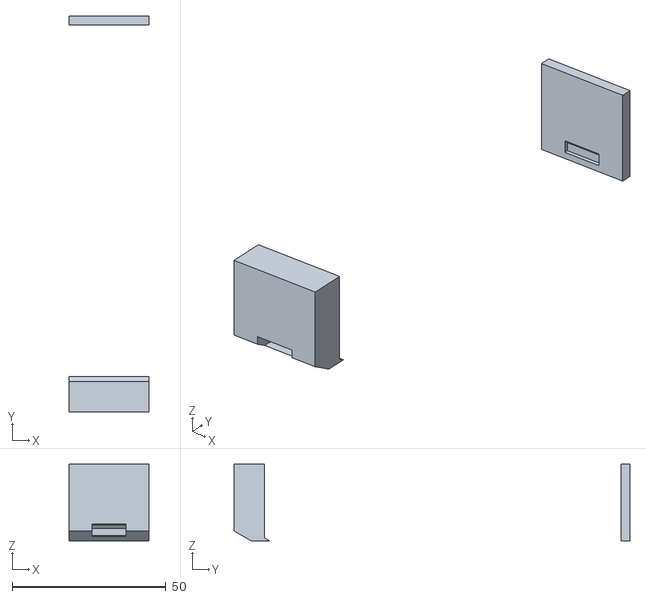
[picture p132: CAD file, 2026-10-19]
docs/case-tela-waveshare-7/stl/00-TESTE-encaixe-corpo.stl
26.0 x 129.0 x 25.0
