DJLIMA1/FIAP-ChargeGridApp-GS1-2026/docs/case-tela-waveshare-7/verificacao/montagem-chaves.stl

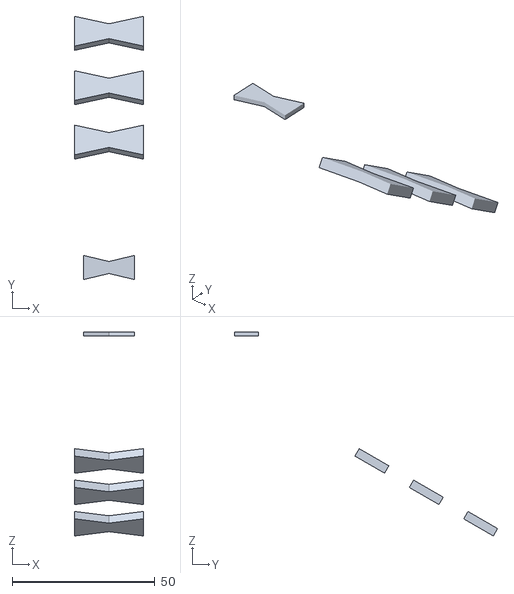
[picture p133: CAD file, 2026-10-19]
docs/case-tela-waveshare-7/verificacao/montagem-chaves.stl
24.0 x 92.2 x 71.5
