DJLIMA1/FIAP-ChargeGridApp-GS1-2026/docs/prototipo-usb/cad-cupons/step/montagens-DEMONSTRACAO-nao-imprimir.step

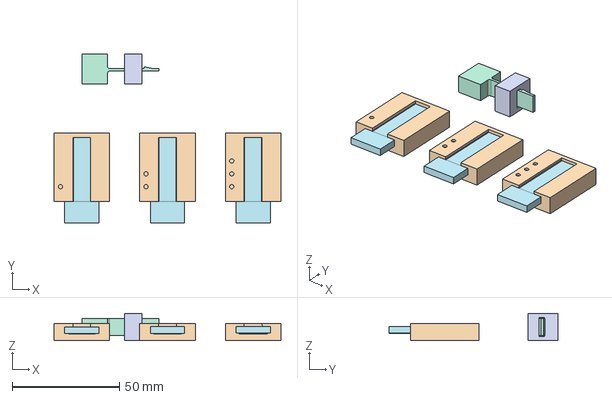
[picture p134: CAD file, 2026-10-13]
docs/prototipo-usb/cad-cupons/step/montagens-DEMONSTRACAO-nao-imprimir.step
106.0 x 79.0 x 12.7 mm
