DJLIMA1/FIAP-ChargeGridApp-GS1-2026/docs/prototipo-usb/ender3-original-pla-v1/pecas-individuais/08-pino-tampa-1.stl

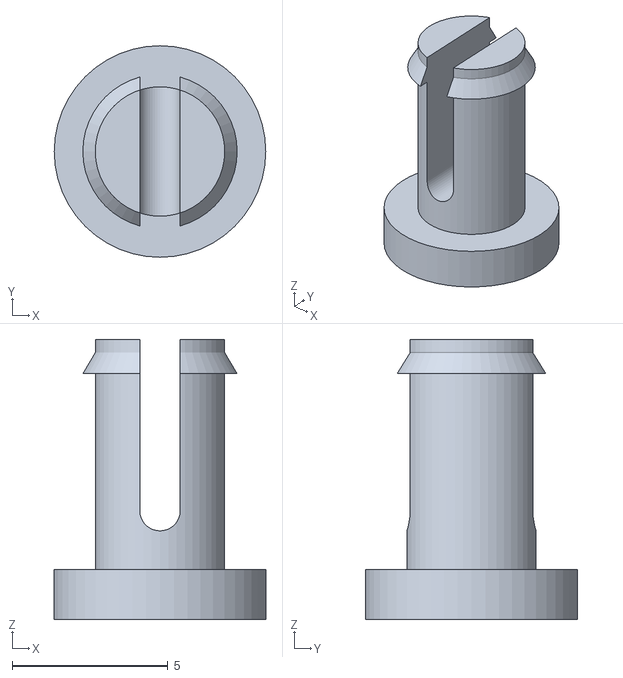
[picture p135: CAD file, 2026-10-20]
docs/prototipo-usb/ender3-original-pla-v1/pecas-individuais/08-pino-tampa-1.stl
6.80 x 6.80 x 9.00
