DJLIMA1/FIAP-ChargeGridApp-GS1-2026/docs/prototipo-usb/ender3-pla-oficial-v8/stl/08-pino-tampa-1.stl

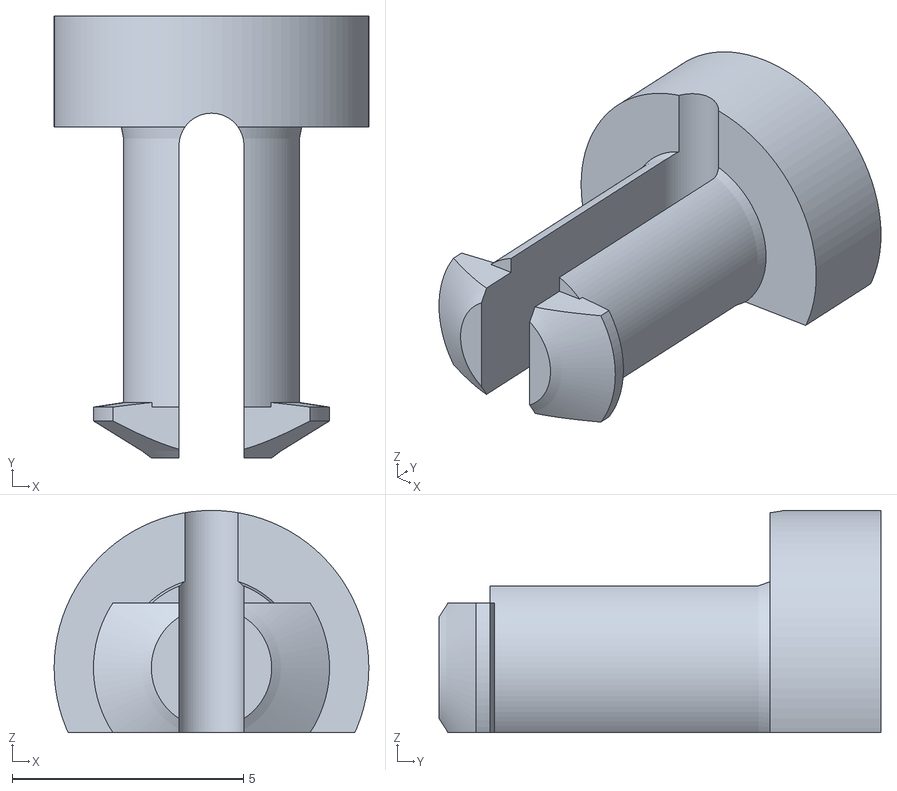
[picture p136: CAD file, 2026-10-20]
docs/prototipo-usb/ender3-pla-oficial-v8/stl/08-pino-tampa-1.stl
6.80 x 9.55 x 4.80
