DJLIMA1/FIAP-ChargeGridApp-GS1-2026/docs/case-tela-waveshare-7/stl/02-CORPO-esquerdo.stl

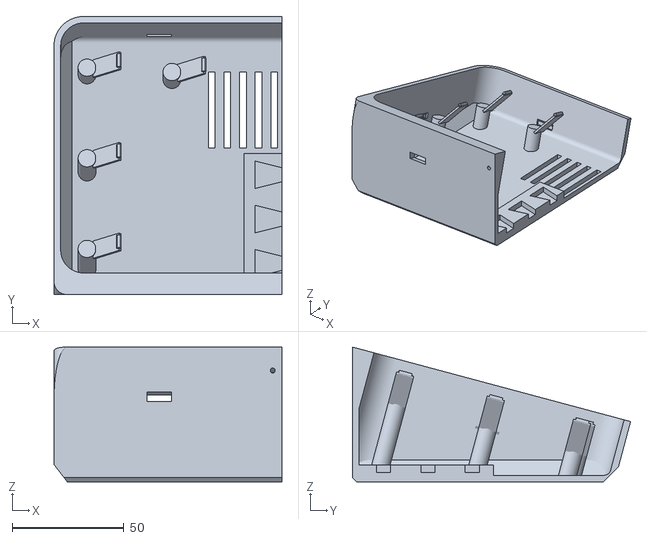
[picture p139: CAD file, 2026-10-19]
docs/case-tela-waveshare-7/stl/02-CORPO-esquerdo.stl
102.1 x 124.6 x 60.4
