DJLIMA1/FIAP-ChargeGridApp-GS1-2026/docs/case-tela-waveshare-7/verificacao/montagem-base.stl

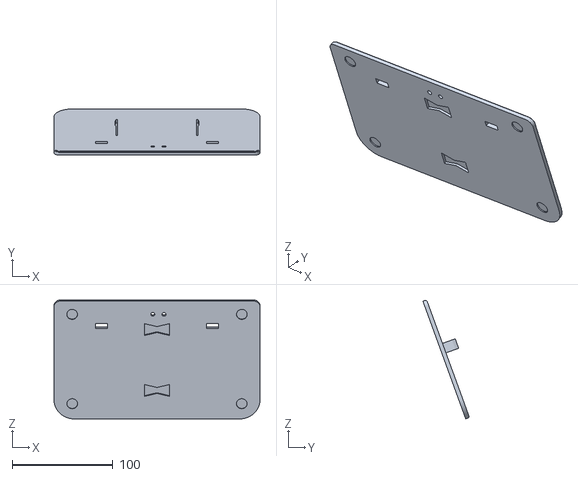
[picture p140: CAD file, 2026-10-19]
docs/case-tela-waveshare-7/verificacao/montagem-base.stl
204.2 x 45.9 x 117.8
