DJLIMA1/FIAP-ChargeGridApp-GS1-2026/docs/prototipo-usb/cad-cupons/step/receptor-da-trava.step

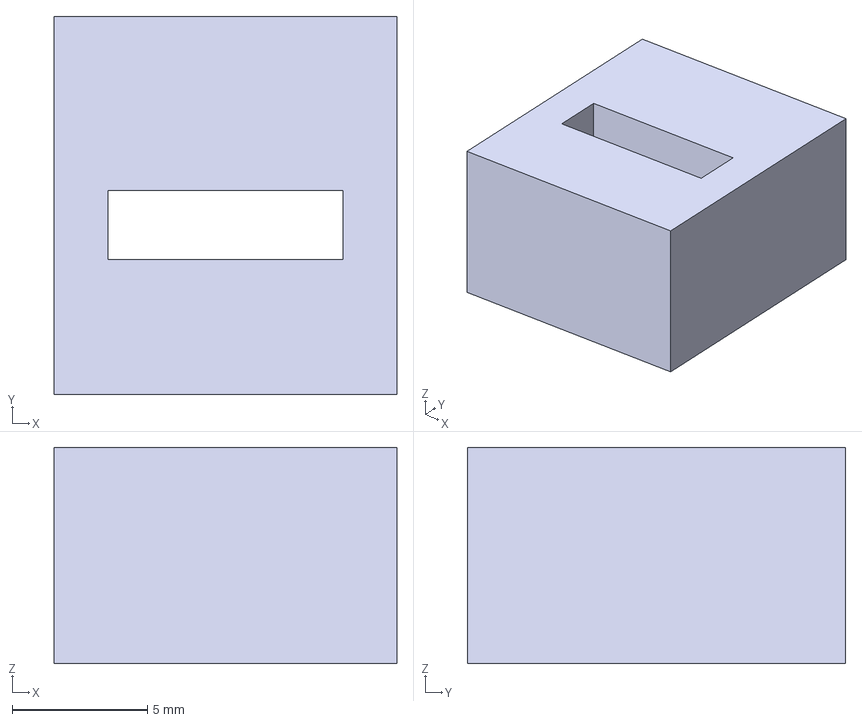
[picture p141: CAD file, 2026-10-13]
docs/prototipo-usb/cad-cupons/step/receptor-da-trava.step
12.7 x 14.0 x 8.00 mm
