DJLIMA1/FIAP-ChargeGridApp-GS1-2026/docs/prototipo-usb/ender3-original-pla-v1/pecas-individuais/16-cupom-quarto-volta.stl

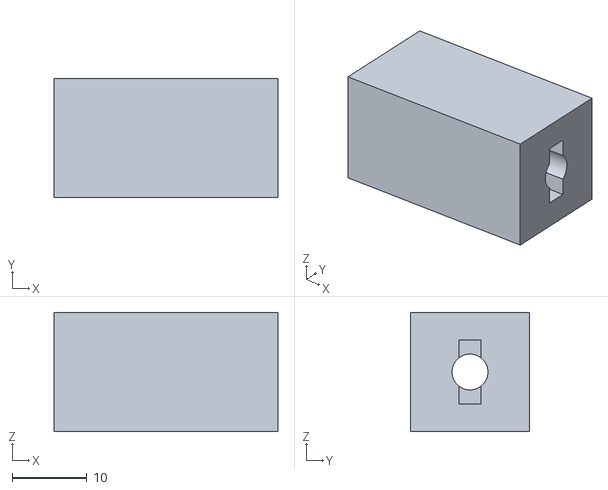
[picture p142: CAD file, 2026-10-20]
docs/prototipo-usb/ender3-original-pla-v1/pecas-individuais/16-cupom-quarto-volta.stl
30.0 x 16.0 x 16.0
