DJLIMA1/FIAP-ChargeGridApp-GS1-2026/docs/case-tela-waveshare-7/entrega-faculdade/STL/2-PECAS/03-BASE-direita.stl

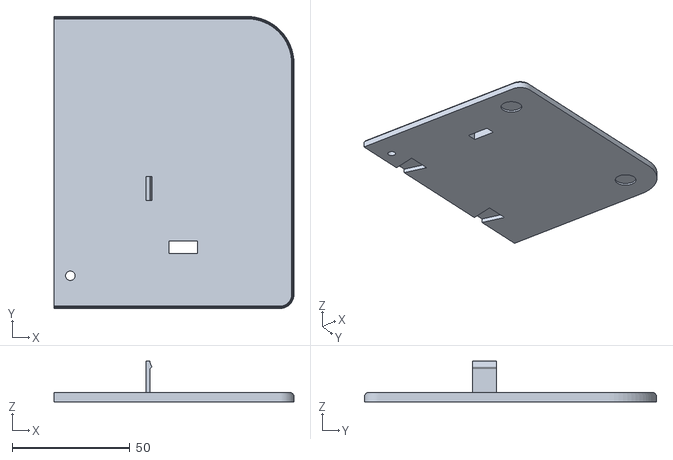
[picture p143: CAD file, 2026-10-19]
docs/case-tela-waveshare-7/entrega-faculdade/STL/2-PECAS/03-BASE-direita.stl
102.1 x 124.2 x 17.4
