DJLIMA1/FIAP-ChargeGridApp-GS1-2026/docs/case-tela-waveshare-7/verificacao/plugues-usb-c.stl

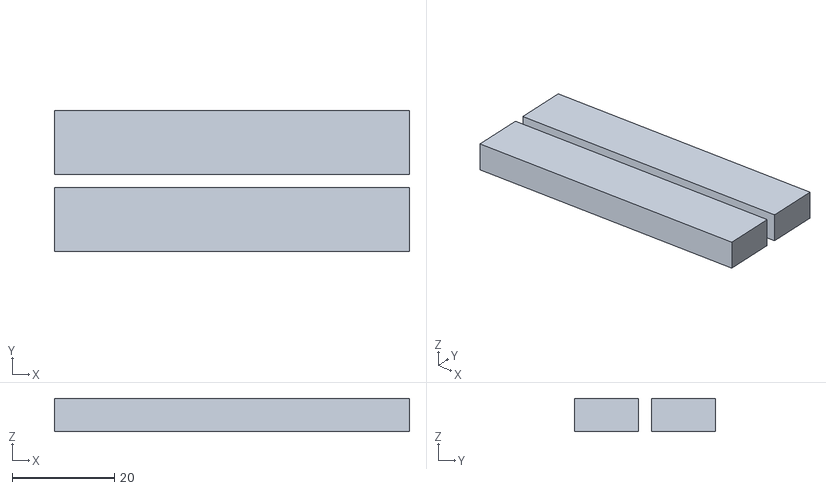
[picture p144: CAD file, 2026-10-19]
docs/case-tela-waveshare-7/verificacao/plugues-usb-c.stl
69.4 x 27.6 x 6.50
