DJLIMA1/FIAP-ChargeGridApp-GS1-2026/docs/prototipo-usb/cad-cupons/step/trilho-macho-comum.step

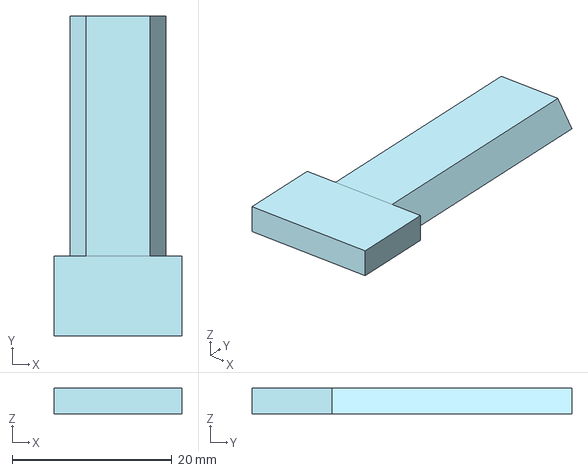
[picture p145: CAD file, 2026-10-13]
docs/prototipo-usb/cad-cupons/step/trilho-macho-comum.step
16.0 x 40.0 x 3.20 mm
