DJLIMA1/FIAP-ChargeGridApp-GS1-2026/docs/prototipo-usb/cad-impressao-50-v1/stl/08-pino-tampa-5.stl

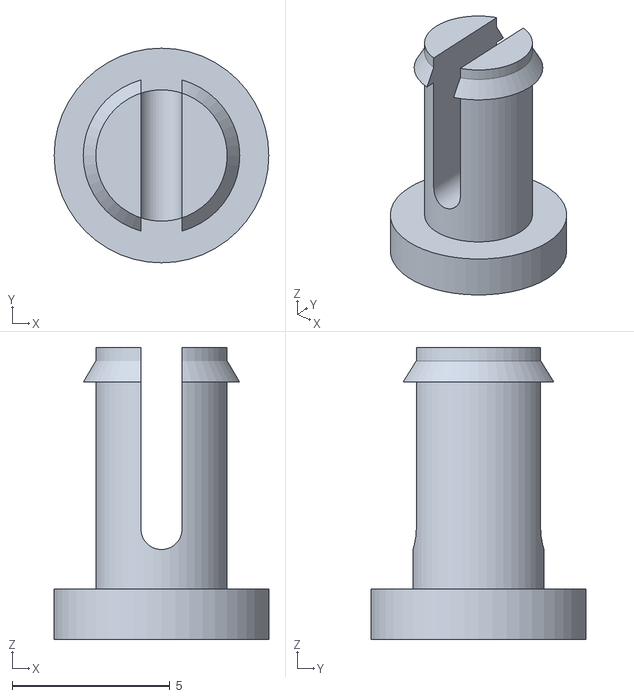
[picture p146: CAD file, 2026-10-13]
docs/prototipo-usb/cad-impressao-50-v1/stl/08-pino-tampa-5.stl
6.80 x 6.80 x 9.25
