DJLIMA1/FIAP-ChargeGridApp-GS1-2026/docs/prototipo-usb/ender3-pla-oficial-v7/stl/12-pino-trava-berco.stl

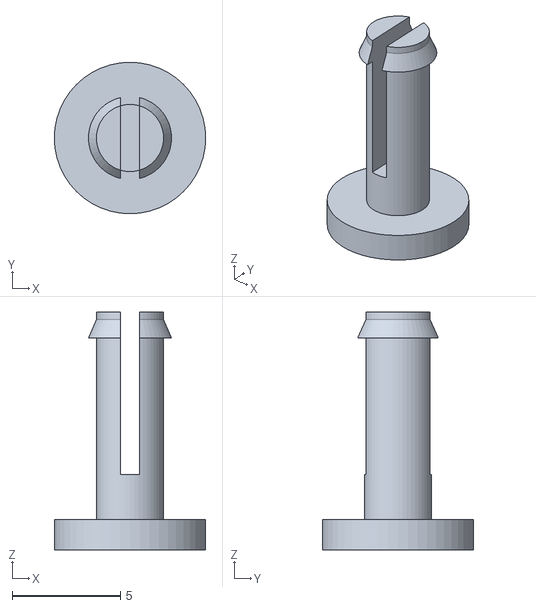
[picture p147: CAD file, 2026-10-20]
docs/prototipo-usb/ender3-pla-oficial-v7/stl/12-pino-trava-berco.stl
7.00 x 7.00 x 11.0
