DJLIMA1/FIAP-ChargeGridApp-GS1-2026/docs/prototipo-usb/ender3-pla-oficial-v9/stl/13-bloqueio-bandeja-esquerda.stl

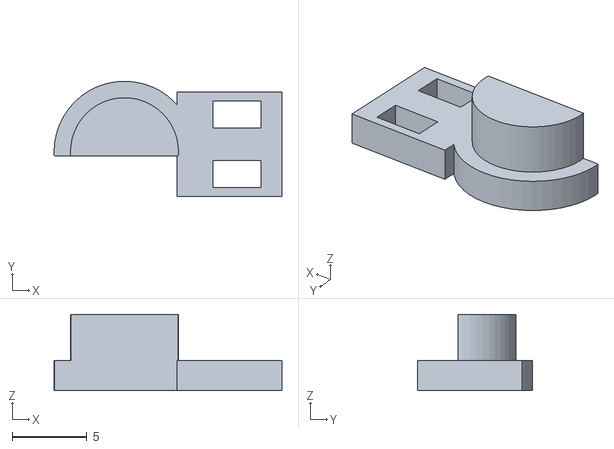
[picture p148: CAD file, 2026-10-20]
docs/prototipo-usb/ender3-pla-oficial-v9/stl/13-bloqueio-bandeja-esquerda.stl
15.2 x 7.70 x 5.10
