DJLIMA1/FIAP-ChargeGridApp-GS1-2026/docs/case-tela-waveshare-7/entrega-faculdade/STL/2-PECAS/01-MOLDURA-direita.stl

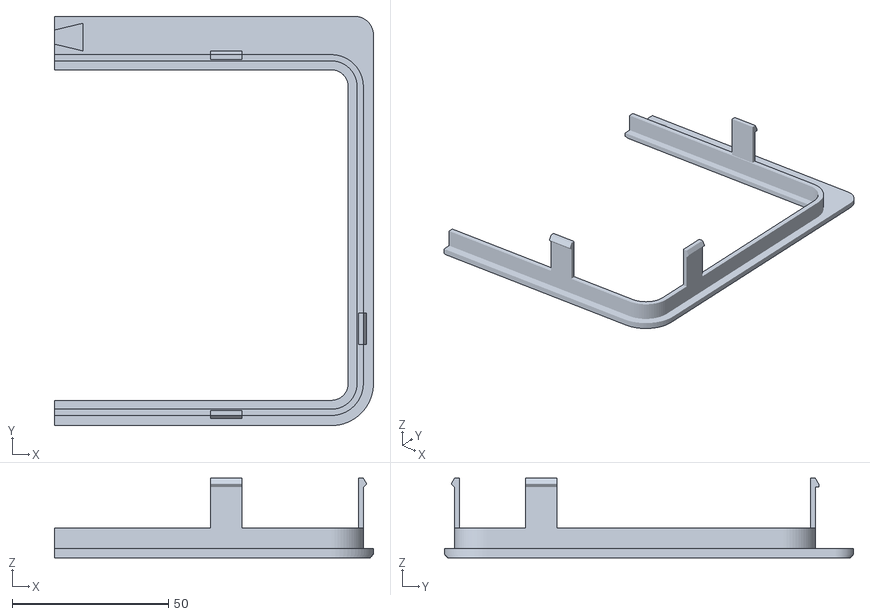
[picture p149: CAD file, 2026-10-19]
docs/case-tela-waveshare-7/entrega-faculdade/STL/2-PECAS/01-MOLDURA-direita.stl
102.1 x 131.0 x 25.5
