DJLIMA1/FIAP-ChargeGridApp-GS1-2026/docs/case-tela-waveshare-7/verificacao/tela-referencia.stl

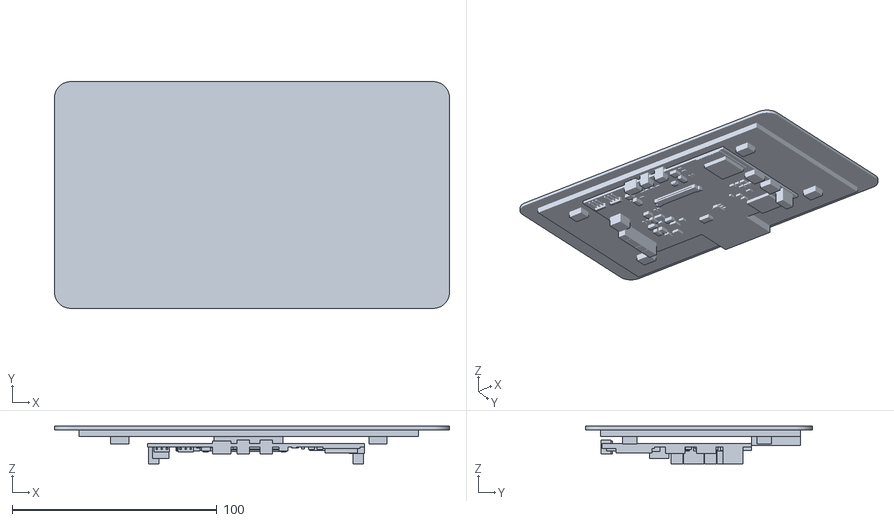
[picture p150: CAD file, 2026-10-19]
docs/case-tela-waveshare-7/verificacao/tela-referencia.stl
193.0 x 110.8 x 18.4
