DJLIMA1/FIAP-ChargeGridApp-GS1-2026/docs/prototipo-usb/ender3-pla-oficial-v9/stl/14-espacador-5mm.stl

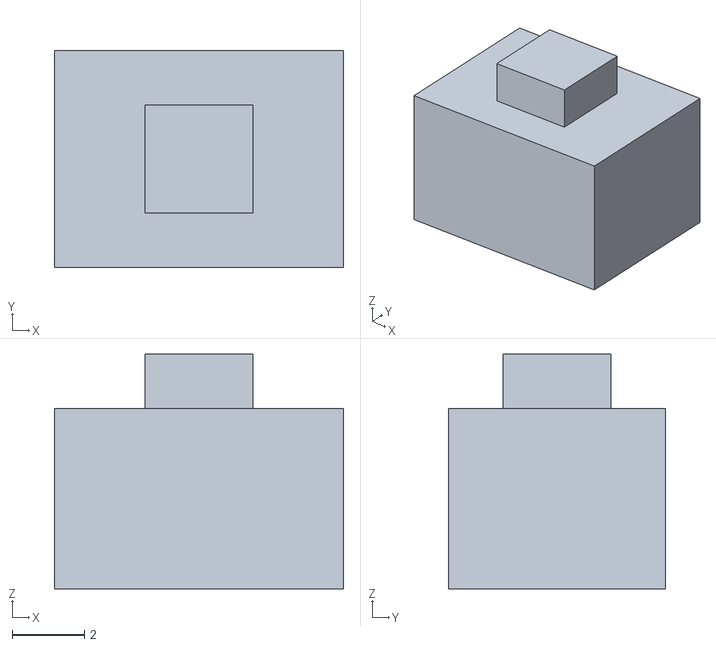
[picture p151: CAD file, 2026-10-20]
docs/prototipo-usb/ender3-pla-oficial-v9/stl/14-espacador-5mm.stl
8.00 x 6.00 x 6.50
