DJLIMA1/FIAP-ChargeGridApp-GS1-2026/docs/case-tela-waveshare-7/stl/00-TESTE-encaixe-moldura.stl

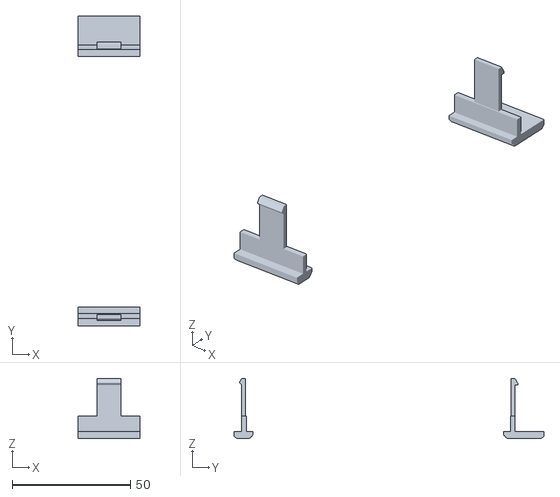
[picture p152: CAD file, 2026-10-19]
docs/case-tela-waveshare-7/stl/00-TESTE-encaixe-moldura.stl
26.0 x 131.0 x 25.5
