DJLIMA1/FIAP-ChargeGridApp-GS1-2026/docs/prototipo-usb/cad-cupons/step/trava-flexivel-substituivel.step

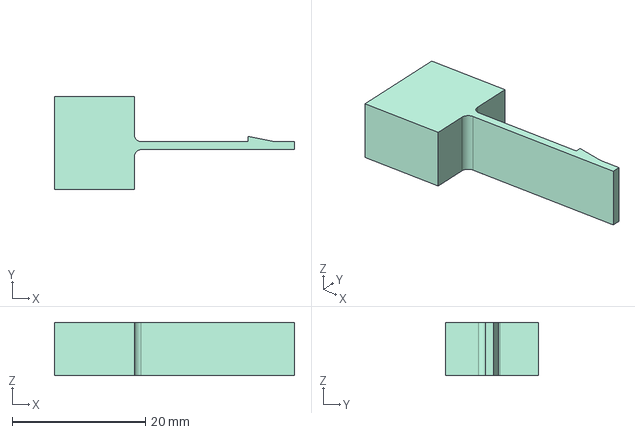
[picture p153: CAD file, 2026-10-13]
docs/prototipo-usb/cad-cupons/step/trava-flexivel-substituivel.step
36.0 x 14.0 x 8.00 mm
