DJLIMA1/FIAP-ChargeGridApp-GS1-2026/docs/prototipo-usb/cad-impressao-50-v1/pranchas/07-cabos-5mm-OPCIONAL.3mf

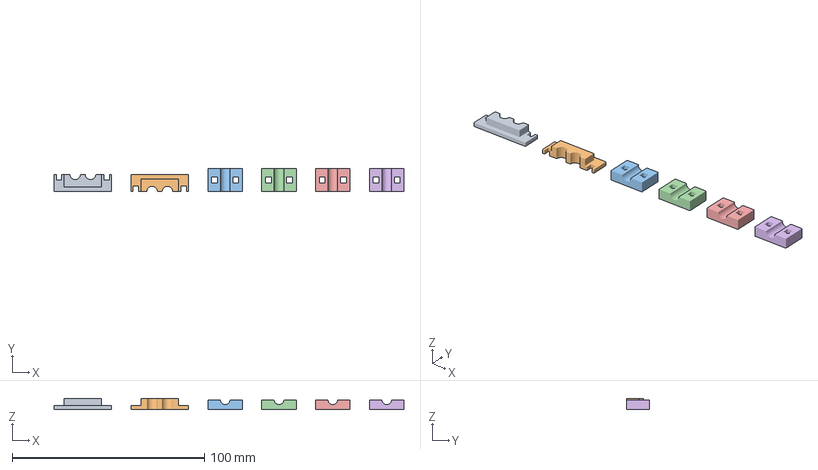
[picture p154: CAD file, 2026-10-13]
docs/prototipo-usb/cad-impressao-50-v1/pranchas/07-cabos-5mm-OPCIONAL.3mf
182.0 x 12.0 x 5.60 mm
19-inserto-duplo-5mm-a--1
19-inserto-duplo-5mm-b--1
15-prensa-cabo-5mm-meia--1
15-prensa-cabo-5mm-meia--2
15-prensa-cabo-5mm-meia--3
15-prensa-cabo-5mm-meia--4
