DJLIMA1/FIAP-ChargeGridApp-GS1-2026/docs/prototipo-usb/ender3-pla-oficial-v9/stl/11-berco-esp32.stl

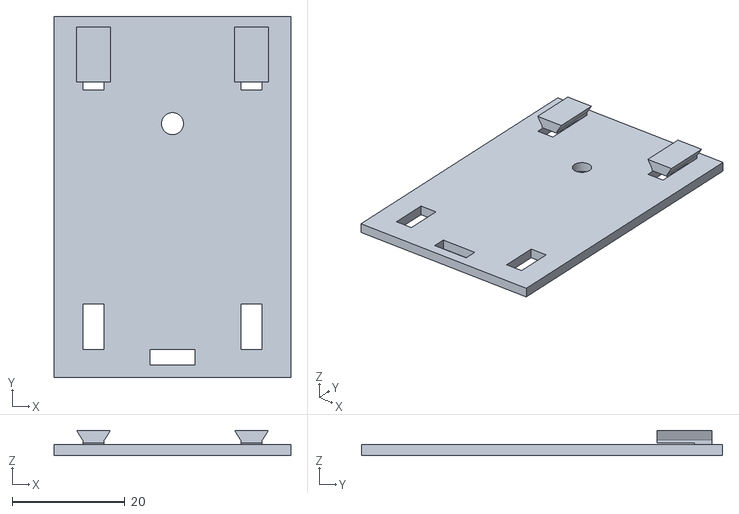
[picture p155: CAD file, 2026-10-20]
docs/prototipo-usb/ender3-pla-oficial-v9/stl/11-berco-esp32.stl
42.0 x 64.0 x 4.45
