DJLIMA1/FIAP-ChargeGridApp-GS1-2026/docs/case-tela-waveshare-7/stl/02-CORPO-cunha.stl

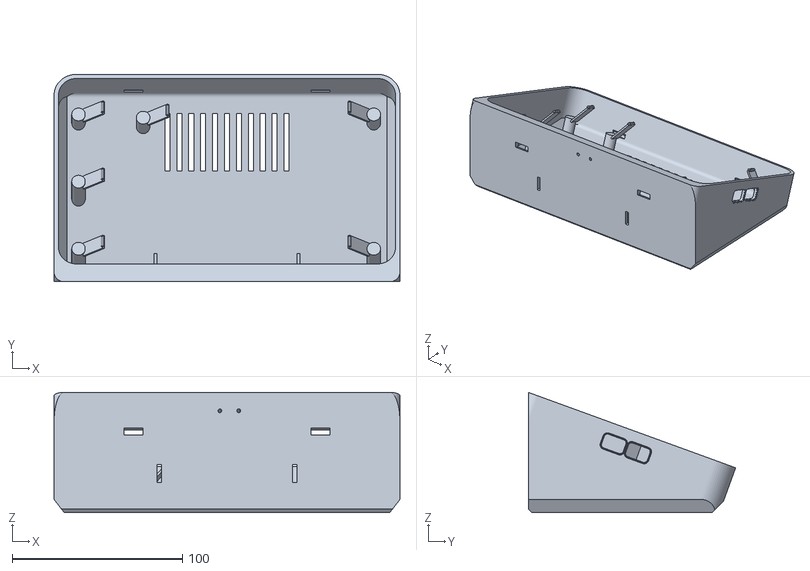
[picture p156: CAD file, 2026-10-19]
docs/case-tela-waveshare-7/stl/02-CORPO-cunha.stl
203.4 x 121.9 x 70.7
