DJLIMA1/FIAP-ChargeGridApp-GS1-2026/docs/prototipo-usb/cad-cupons/step/kit-completo-6-pecas.step

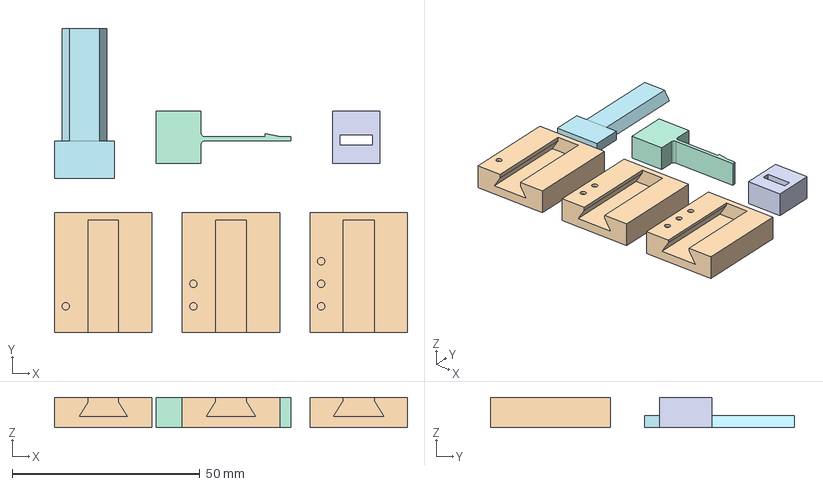
[picture p157: CAD file, 2026-10-13]
docs/prototipo-usb/cad-cupons/step/kit-completo-6-pecas.step
94.0 x 81.0 x 8.00 mm
