DJLIMA1/FIAP-ChargeGridApp-GS1-2026/docs/prototipo-usb/cad-impressao-50-v1/pranchas/00-ensaios.3mf

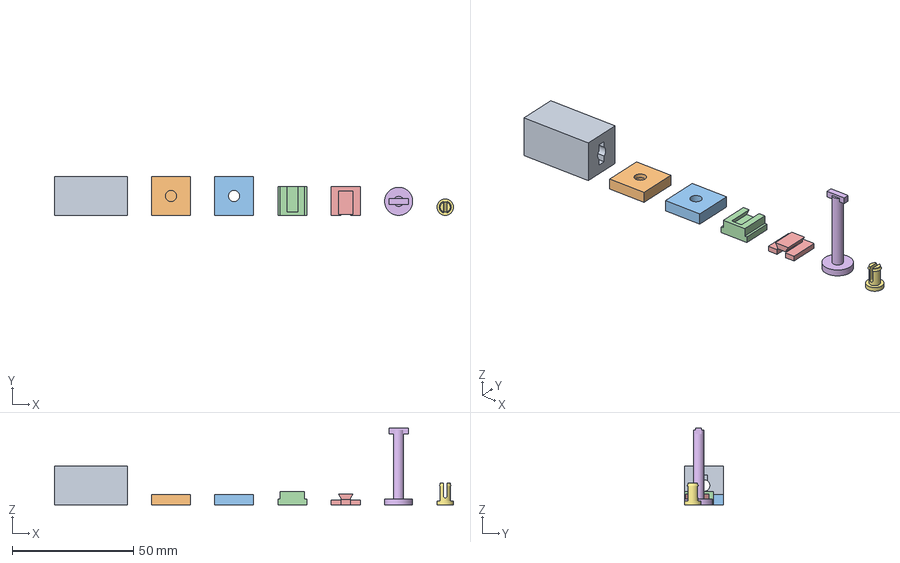
[picture p158: CAD file, 2026-10-13]
docs/prototipo-usb/cad-impressao-50-v1/pranchas/00-ensaios.3mf
164.4 x 16.0 x 31.7 mm
16-cupom-quarto-volta--1
17-cupom-bucha-tampa--1
18-cupom-placa-tampa--1
20-cupom-trilho-berco--1
21-cupom-macho-berco--1
07-pino-quarto-volta--1
08-pino-tampa-1--1
