DJLIMA1/FIAP-ChargeGridApp-GS1-2026/docs/case-tela-waveshare-7/stl/01-MOLDURA-frente.stl

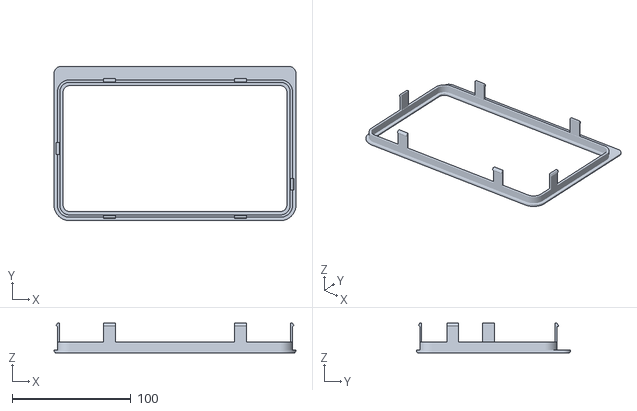
[picture p159: CAD file, 2026-10-19]
docs/case-tela-waveshare-7/stl/01-MOLDURA-frente.stl
203.4 x 129.7 x 24.9
