DJLIMA1/FIAP-ChargeGridApp-GS1-2026/(list of files, cad)

Other CAD files:
docs/prototipo-usb/ender3-pla-gcode-v1/modelos-fatiados/09BERCO.stl
docs/prototipo-usb/ender3-pla-gcode-v1/projetos/05QDINF.3mf
docs/prototipo-usb/ender3-pla-gcode-v2/modelos-fatiados/01TAMPA.stl
docs/prototipo-usb/ender3-pla-gcode-v2/projetos/10TRAVA.3mf
docs/prototipo-usb/ender3-pla-oficial-v6/modelos-fatiados/03TRINF.stl
docs/prototipo-usb/ender3-pla-oficial-v6/montagem/ChargeGrid-50-OFICIAL-nao-fatiar.3mf
docs/prototipo-usb/ender3-pla-oficial-v6/projetos/01CHAVE.3mf
docs/prototipo-usb/ender3-pla-oficial-v7/montagem/ChargeGrid-50-OFICIAL-nao-fatiar.3mf
docs/prototipo-usb/ender3-pla-oficial-v7/projetos/10BERCO.3mf
docs/prototipo-usb/ender3-pla-oficial-v8/modelos-fatiados/12CABO.stl
docs/prototipo-usb/ender3-pla-oficial-v8/montagem/ChargeGrid-50-OFICIAL-nao-fatiar.3mf
docs/prototipo-usb/ender3-pla-oficial-v9/montagem/ChargeGrid-50-OFICIAL-nao-fatiar.3mf
docs/prototipo-usb/ender3-pla-oficial-v9/projetos/10BERCO9.3mf
docs/prototipo-usb/faculdade-stl-v9/STL/JA-IMPRESSOS/02TRSUP.stl
docs/prototipo-usb/teste-trava-pla-v5/projetos/00FIXA5.3mf
docs/case-tela-waveshare-7/entrega-faculdade/STL/2-PECAS/01-MOLDURA-esquerda.stl
docs/prototipo-usb/cad-cupons/step/trilho-femea-45.step
docs/prototipo-usb/cad-impressao-50-v1/pranchas/01-traseira-superior.3mf
docs/prototipo-usb/ender3-original-pla-v1/pecas-individuais/01-traseira-inferior.stl
docs/prototipo-usb/ender3-pla-gcode-v1/modelos-fatiados/06CHAVE.stl
docs/prototipo-usb/ender3-pla-gcode-v2/modelos-fatiados/05QDINF.stl
docs/prototipo-usb/ender3-pla-gcode-v2/projetos/08PTAMP.3mf
docs/prototipo-usb/ender3-pla-oficial-v6/projetos/09PINO.3mf
docs/prototipo-usb/ender3-pla-oficial-v7/projetos/11TRAVA.3mf
docs/prototipo-usb/ender3-pla-oficial-v7/stl/19-inserto-duplo-5mm-a.stl
docs/prototipo-usb/ender3-pla-oficial-v8/modelos-fatiados/04QDSUP.stl
docs/prototipo-usb/ender3-pla-oficial-v9/modelos-fatiados/09PINO.stl
docs/prototipo-usb/ender3-pla-oficial-v9/projetos/12CABO.3mf
docs/prototipo-usb/ender3-pla-oficial-v9/stl/09-bandeja-removivel.stl
docs/prototipo-usb/faculdade-stl-v9/STL/PENDENTES/10BERCO9.stl
docs/prototipo-usb/revisao-independente-v9/cinta-direita-envelope.stl
docs/prototipo-usb/cad-impressao-50-v1/pranchas/04-quadro-inferior.3mf
docs/prototipo-usb/cad-impressao-50-v1/stl/15-prensa-cabo-6mm-meia.stl
docs/prototipo-usb/ender3-pla-gcode-v1/projetos/09BERCO.3mf
docs/prototipo-usb/ender3-pla-gcode-v2/modelos-fatiados/00TESTE.stl
docs/prototipo-usb/ender3-pla-gcode-v2/projetos/11CABO.3mf
docs/prototipo-usb/ender3-pla-oficial-v6/projetos/02TRSUP.3mf
docs/prototipo-usb/ender3-pla-oficial-v7/projetos/07PTAMP.3mf
docs/prototipo-usb/ender3-pla-oficial-v7/stl/03-quadro-inferior.stl
docs/prototipo-usb/ender3-pla-oficial-v8/modelos-fatiados/10BERCO8.stl
docs/prototipo-usb/ender3-pla-oficial-v8/projetos/06TAMPA.3mf
docs/prototipo-usb/ender3-pla-oficial-v9/projetos/05QDINF8.3mf
docs/prototipo-usb/cad-impressao-50-v1/pranchas/03-quadro-superior.3mf
docs/prototipo-usb/cad-impressao-50-v1/stl/01-traseira-superior.stl
docs/prototipo-usb/ender3-pla-gcode-v1/projetos/01TAMPA.3mf
docs/prototipo-usb/ender3-pla-gcode-v2/modelos-fatiados/10TRAVA.stl
docs/prototipo-usb/ender3-pla-gcode-v2/projetos/04QDSUP.3mf
docs/prototipo-usb/ender3-pla-oficial-v6/projetos/03TRINF.3mf
docs/prototipo-usb/ender3-pla-oficial-v7/projetos/03TRINF7.3mf
docs/prototipo-usb/ender3-pla-oficial-v7/stl/19-inserto-duplo-5mm-b.stl
docs/prototipo-usb/ender3-pla-oficial-v8/modelos-fatiados/03TRINF7.stl
docs/prototipo-usb/ender3-pla-oficial-v8/stl/08-pino-tampa-5.stl
docs/prototipo-usb/ender3-pla-oficial-v9/projetos/11TRAVA9.3mf
docs/prototipo-usb/ender3-pla-oficial-v9/stl/01-traseira-inferior.stl
docs/case-tela-waveshare-7/stl/04-CHAVES-8un.stl
docs/prototipo-usb/cad-impressao-50-v1/pranchas/05-tampa-frontal.3mf
docs/prototipo-usb/ender3-original-pla-v1/pecas-individuais/19-inserto-5mm-a.stl
docs/prototipo-usb/ender3-pla-gcode-v1/projetos/07PINO.3mf
docs/prototipo-usb/ender3-pla-gcode-v2/modelos-fatiados/08PTAMP.stl
docs/prototipo-usb/ender3-pla-gcode-v2/projetos/06CHAVE.3mf
docs/prototipo-usb/ender3-pla-oficial-v6/projetos/05QDINF.3mf
docs/prototipo-usb/ender3-pla-oficial-v7/projetos/08PTINF.3mf
docs/prototipo-usb/ender3-pla-oficial-v8/modelos-fatiados/11TRAVA8.stl
docs/prototipo-usb/ender3-pla-oficial-v8/stl/19-inserto-5mm-b.stl
docs/case-tela-waveshare-7/stl/03-BASE-esquerda.stl
docs/prototipo-usb/cad-cupons/step/trilho-femea-35.step
docs/prototipo-usb/cad-impressao-50-v1/pranchas/02-traseira-inferior.3mf
docs/prototipo-usb/cad-impressao-50-v1/stl/13-trava-bandeja.stl
docs/prototipo-usb/ender3-original-pla-v1/pecas-individuais/05-tampa-frontal.stl
docs/prototipo-usb/ender3-pla-gcode-v1/projetos/03TRINF.3mf
docs/prototipo-usb/ender3-pla-gcode-v2/projetos/05QDINF.3mf
docs/prototipo-usb/ender3-pla-oficial-v7/projetos/04QDSUP.3mf
docs/prototipo-usb/ender3-pla-oficial-v8/stl/09-bandeja-removivel.stl
docs/prototipo-usb/ender3-original-pla-v1/pecas-individuais/03-quadro-superior.stl
docs/prototipo-usb/ender3-pla-gcode-v1/projetos/10TRAVA.3mf
docs/prototipo-usb/ender3-pla-gcode-v2/projetos/09BERCO.3mf
docs/prototipo-usb/ender3-original-pla-v1/pecas-individuais/19-inserto-4mm-a.stl
docs/prototipo-usb/ender3-pla-gcode-v1/projetos/08PTAMP.3mf
docs/prototipo-usb/ender3-pla-gcode-v2/projetos/02TRSUP.3mf
docs/prototipo-usb/ender3-pla-oficial-v9/stl/19-inserto-6mm-a.stl
docs/case-tela-waveshare-7/stl/03-BASE-apoio.stl
docs/prototipo-usb/cad-cupons/stl/kit-completo-6-pecas.stl
docs/prototipo-usb/cad-cupons/stl/receptor-da-trava.stl
docs/prototipo-usb/cad-cupons/stl/trava-flexivel-substituivel.stl
docs/prototipo-usb/cad-cupons/stl/trilho-femea-25.stl
docs/prototipo-usb/cad-cupons/stl/trilho-femea-35.stl
docs/prototipo-usb/cad-cupons/stl/trilho-femea-45.stl
docs/prototipo-usb/cad-cupons/stl/trilho-macho-comum.stl
docs/prototipo-usb/ender3-original-pla-v1/00-teste-encaixes/00-teste-encaixes.stl
docs/prototipo-usb/ender3-original-pla-v1/01-tampa-branca/01-tampa-branca.stl
docs/prototipo-usb/ender3-original-pla-v1/02-traseira-superior/02-traseira-superior.stl
docs/prototipo-usb/ender3-original-pla-v1/03-traseira-inferior/03-traseira-inferior.stl
docs/prototipo-usb/ender3-original-pla-v1/04-quadro-superior/04-quadro-superior.stl
docs/prototipo-usb/ender3-original-pla-v1/07-pinos-quarto-de-volta/07-pinos-quarto-de-volta.stl
docs/prototipo-usb/ender3-original-pla-v1/08-pinos-tampa-branca/08-pinos-tampa-branca.stl
docs/prototipo-usb/ender3-original-pla-v1/10-travas-e-espacadores/10-travas-e-espacadores.stl
docs/prototipo-usb/ender3-original-pla-v1/pecas-individuais/15-prensa-cabo-4mm-meia.stl
docs/prototipo-usb/ender3-original-pla-v1/pecas-individuais/20-cupom-trilho-berco.stl
docs/prototipo-usb/ender3-pla-gcode-v1/projetos/02TRSUP.3mf
docs/prototipo-usb/ender3-pla-gcode-v1/projetos/04QDSUP.3mf
docs/prototipo-usb/ender3-pla-gcode-v1/projetos/06CHAVE.3mf
docs/prototipo-usb/ender3-pla-gcode-v1/projetos/11CABO.3mf
docs/prototipo-usb/ender3-pla-gcode-v2/projetos/00TESTE.3mf
docs/prototipo-usb/ender3-pla-gcode-v2/projetos/01TAMPA.3mf
docs/prototipo-usb/ender3-pla-gcode-v2/projetos/03TRINF.3mf
docs/prototipo-usb/ender3-pla-gcode-v2/projetos/07PINO.3mf
docs/prototipo-usb/ender3-pla-oficial-v9/stl/10-berco-potencia.stl
docs/prototipo-usb/ender3-pla-oficial-v9/stl/13-bloqueio-bandeja-direita.stl
docs/prototipo-usb/teste-trava-pla-v3/modelos-fatiados/00TRAVA.stl
docs/prototipo-usb/teste-trava-pla-v3/modelos-fatiados/01ENCAIX.stl
docs/prototipo-usb/teste-trava-pla-v3/projetos/00TRAVA.3mf
docs/prototipo-usb/teste-trava-pla-v3/projetos/01ENCAIX.3mf
docs/prototipo-usb/teste-trava-pla-v3/stl/08-pino-tampa-1-a-4-PLA-v3.stl
docs/prototipo-usb/teste-trava-pla-v3/stl/08-pino-tampa-5-PLA-v3.stl
docs/prototipo-usb/teste-trava-pla-v3/stl/17-cupom-bucha-tampa.stl
docs/prototipo-usb/teste-trava-pla-v3/stl/18-cupom-placa-tampa.stl
docs/prototipo-usb/teste-trava-pla-v4/modelos-fatiados/00FLEX4.stl
docs/prototipo-usb/teste-trava-pla-v4/projetos/00FLEX4.3mf
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
