DJLIMA1/FIAP-ChargeGridApp-GS1-2026/docs/prototipo-usb/ender3-pla-oficial-v6/verificacao/estimativas.csv

arquivo | gramas | tempo_estimado | suportes_g
01CHAVE.gcode | 2.88 | 18m 11s | 0.0
02TRSUP.gcode | 50.96 | 5h 56m 16s | 2.69
03TRINF.gcode | 58.0 | 7h 51m 18s | 11.89
04QDSUP.gcode | 38.92 | 4h 54m 46s | 8.71
05QDINF.gcode | 67.0 | 10h 49m 54s | 25.76
06TAMPA.gcode | 44.79 | 5h 25m 29s | 16.16
07PTAMP.gcode | 0.74 | 9m 12s | 0.0
08PTINF.gcode | 0.24 | 3m 17s | 0.0
09PINO.gcode | 4.48 | 36m 27s | 0.95
10BERCO.gcode | 28.44 | 2h 46m 20s | 0.0
11TRAVA.gcode | 3.1 | 33m 42s | 0.0
12CABO.gcode | 6.98 | 1h 3m 53s | 0.0
