DJLIMA1/FIAP-ChargeGridApp-GS1-2026/docs/prototipo-usb/teste-trava-pla-v5/verificacao/estimativas.csv

arquivo | gramas | tempo_estimado | suportes_g
00FIXA5.gcode | 0.4 | 5m 18s | 0.0
