DJLIMA1/FIAP-ChargeGridApp-GS1-2026/docs/prototipo-usb/teste-trava-pla-v3/verificacao/estimativas.csv

arquivo | gramas | tempo_estimado | suportes_g
00TRAVA.gcode | 0.5 | 5m 39s | 0.0
01ENCAIX.gcode | 2.15 | 15m 1s | 0.0
