DJLIMA1/FIAP-ChargeGridApp-GS1-2026/docs/prototipo-usb/teste-trava-pla-v4/verificacao/estimativas.csv

arquivo | gramas | tempo_estimado | suportes_g
00FLEX4.gcode | 0.41 | 5m 18s | 0.0
