DJLIMA1/FIAP-ChargeGridApp-GS1-2026/docs/prototipo-usb/teste-trava-pla-v5/como-testar.png

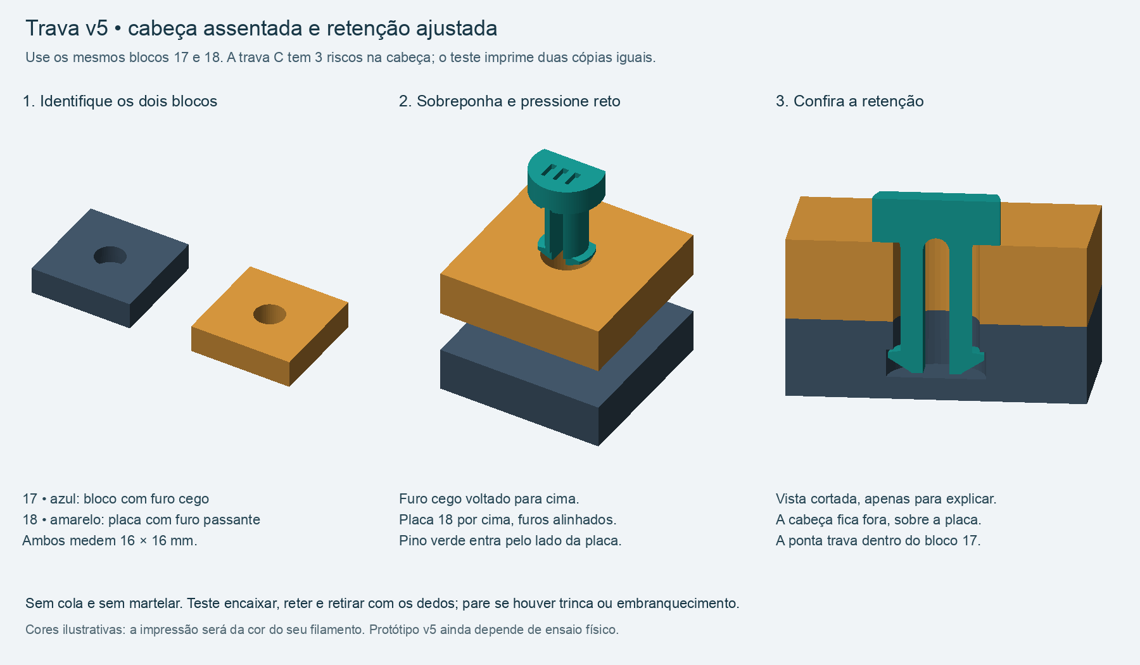
docs/prototipo-usb/teste-trava-pla-v5/como-testar.png
