DJLIMA1/FIAP-ChargeGridApp-GS1-2026/docs/prototipo-usb/teste-trava-pla-v5/previas/00FIXA5.png

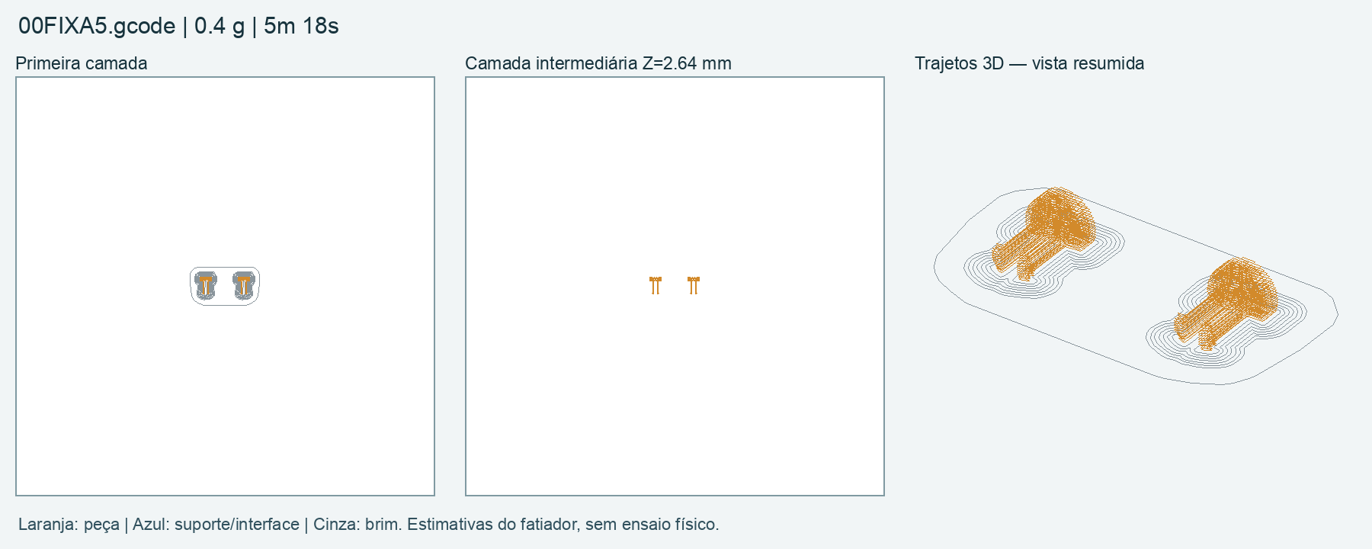
docs/prototipo-usb/teste-trava-pla-v5/previas/00FIXA5.png
