DJLIMA1/FIAP-ChargeGridApp-GS1-2026/(list of files, drawings)

Other design files:
docs/case-tela-waveshare-7/referencia/pcb-componentes-step.json
