DJLIMA1/FIAP-ChargeGridApp-GS1-2026/docs/prototipo-usb/ender3-pla-gcode-v1/perfis/07PINO.ini

# Derived from PrusaSlicer 2.9.6 Creality profiles; local ChargeGrid overrides
avoid_crossing_perimeters = 0
bed_shape = 0x0,220x0,220x220,0x220
bed_temperature = 60
before_layer_gcode = ;BEFORE_LAYER_CHANGE\nG92 E0\n;{layer_z}\n\n
between_objects_gcode = 
binary_gcode = 0
bottom_solid_layers = 4
bottom_solid_min_thickness = 0.8
bridge_acceleration = 300
bridge_angle = 0
bridge_fan_speed = 100
bridge_flow_ratio = 0.95
bridge_speed = 20
brim_separation = 0.1
brim_type = outer_only
brim_width = 3
clip_multipart_objects = 1
complete_objects = 0
cooling = 1
default_acceleration = 500
deretract_speed = 35
disable_fan_first_layers = 1
dont_support_bridges = 0
elefant_foot_compensation = 0.1
end_gcode = M83\nG1 E-2 F1800\nG1 Z{min(max_layer_z+5,245)} F600\nG1 X10 Y210 F3000\nM104 S0\nM140 S0\nM107\nM84 X Y E
ensure_vertical_shell_thickness = 1
external_fill_pattern = rectilinear
external_perimeter_extrusion_width = 0.42
external_perimeter_speed = 20
external_perimeters_first = 0
extra_perimeters = 0
extruder_clearance_height = 25
extruder_clearance_radius = 55
extruder_colour = #FCE94F
extruder_offset = 0x0
extrusion_multiplier = 1
extrusion_width = 0.44
fan_always_on = 1
fan_below_layer_time = 100
filament_colour = #DDDDDD
filament_cost = 0
filament_density = 1.24
filament_diameter = 1.75
filament_max_volumetric_speed = 6
filament_notes = ""
filament_settings_id = PLA 200C 60C
filament_soluble = 0
filament_type = PLA
filament_vendor = Generic
fill_angle = 45
fill_density = 100%
fill_pattern = rectilinear
first_layer_acceleration = 300
first_layer_bed_temperature = 60
first_layer_extrusion_width = 0.42
first_layer_height = 0.2
first_layer_speed = 15
first_layer_temperature = 205
full_fan_speed_layer = 4
gap_fill_speed = 30
gcode_comments = 0
gcode_flavor = marlin
gcode_label_objects = disabled
idle_temperature = 150
infill_acceleration = 500
infill_every_layers = 1
infill_extruder = 1
infill_extrusion_width = 0.44
infill_first = 0
infill_only_where_needed = 0
infill_overlap = 23%
infill_speed = 30
interface_shells = 0
ironing_flowrate = 10%
ironing_spacing = 0.1
ironing_speed = 20
ironing_type = top
layer_gcode = ;AFTER_LAYER_CHANGE\n;{layer_z}
layer_height = 0.16
machine_limits_usage = time_estimate_only
machine_max_acceleration_e = 5000
machine_max_acceleration_extruding = 500
machine_max_acceleration_retracting = 1000
machine_max_acceleration_travel = 500
machine_max_acceleration_x = 500
machine_max_acceleration_y = 500
machine_max_acceleration_z = 100
machine_max_feedrate_e = 60
machine_max_feedrate_x = 500
machine_max_feedrate_y = 500
machine_max_feedrate_z = 10
machine_max_jerk_e = 5
machine_max_jerk_x = 8
machine_max_jerk_y = 8
machine_max_jerk_z = 0.4
machine_min_extruding_rate = 0
machine_min_travel_rate = 0
max_fan_speed = 100
max_layer_height = 0.32
max_print_height = 250
max_print_speed = 50
max_volumetric_extrusion_rate_slope_negative = 0
max_volumetric_extrusion_rate_slope_positive = 0
max_volumetric_speed = 0
min_fan_speed = 100
min_layer_height = 0.06
min_print_speed = 10
min_skirt_length = 4
notes = 
nozzle_diameter = 0.4
only_retract_when_crossing_perimeters = 0
ooze_prevention = 0
output_filename_format = {input_filename_base}.gcode
overhangs = 1
pause_print_gcode = 
perimeter_acceleration = 500
perimeter_extruder = 1
perimeter_extrusion_width = 0.44
perimeter_generator = arachne
perimeter_speed = 25
perimeters = 4
post_process = 
print_settings_id = ChargeGrid Ender3 PLA
printer_model = ENDER3
printer_notes = Don't remove the following keywords! These keywords are used in the "compatible printer" condition of the print and filament profiles to link the particular print and filament profiles to this printer profile.\nPRINTER_VENDOR_CREALITY\nPRINTER_MODEL_ENDER3\nPRINTER_HAS_BOWDEN
printer_settings_id = Ender-3 original 0.4 mm
printer_technology = FFF
printer_variant = 0.4
raft_layers = 0
remaining_times = 0
resolution = 0.025
retract_before_travel = 2
retract_before_wipe = 70%
retract_layer_change = 1
retract_length = 4
retract_length_toolchange = 1
retract_lift = 0.2
retract_lift_above = 0.2
retract_lift_below = 0
retract_restart_extra = 0
retract_restart_extra_toolchange = 0
retract_speed = 35
seam_position = nearest
silent_mode = 0
single_extruder_multi_material = 0
single_extruder_multi_material_priming = 0
skirt_distance = 3
skirt_height = 2
skirts = 0
slowdown_below_layer_time = 10
small_perimeter_speed = 20
solid_infill_below_area = 0
solid_infill_every_layers = 0
solid_infill_extruder = 1
solid_infill_extrusion_width = 0.44
solid_infill_speed = 25
spiral_vase = 0
standby_temperature_delta = -5
start_gcode = G90 ; absolute XYZ\nM83 ; relative extrusion\nM140 S60\nM104 S150\nG28 ; home XYZ, manual-level Ender 3\nG1 Z10 F600\nM190 S60\nM109 S205\nG1 X5 Y25 F3000\nG1 Z0.28 F300\nG92 E0\nG1 X5 Y190 E12 F1000\nG1 X5.4 Y190 F3000\nG1 X5.4 Y25 E12 F1000\nG92 E0\nG1 Z2 F600
support_material = 1
support_material_angle = 0
support_material_auto = 1
support_material_bottom_contact_distance = 0.2
support_material_bottom_interface_layers = 2
support_material_buildplate_only = 0
support_material_closing_radius = 1
support_material_contact_distance = 0.2
support_material_enforce_layers = 0
support_material_extruder = 0
support_material_extrusion_width = 0.36
support_material_interface_contact_loops = 0
support_material_interface_extruder = 0
support_material_interface_layers = 2
support_material_interface_spacing = 0.3
support_material_interface_speed = 25
support_material_pattern = rectilinear
support_material_spacing = 3
support_material_speed = 35
support_material_style = snug
support_material_synchronize_layers = 0
support_material_threshold = 45
support_material_with_sheath = 0
support_material_xy_spacing = 0.35
support_tree_tip_diameter = 0.8
temperature = 200
thin_walls = 0
toolchange_gcode = 
top_infill_extrusion_width = 0.40
top_solid_infill_speed = 20
top_solid_layers = 4
top_solid_min_thickness = 0.8
travel_acceleration = 500
travel_speed = 120
use_firmware_retraction = 0
use_relative_e_distances = 1
use_volumetric_e = 0
variable_layer_height = 1
wipe = 1
wipe_tower = 0
wipe_tower_bridging = 10
wipe_tower_rotation_angle = 0
wipe_tower_width = 60
wipe_tower_x = 170
wipe_tower_y = 140
xy_size_compensation = 0
z_offset = 0
