DJLIMA1/FIAP-ChargeGridApp-GS1-2026/docs/case-tela-waveshare-7/textos-entrega/CONFIGURACOES-DE-IMPRESSAO.txt

CASE DA TELA 7" — CONFIGURAÇÕES DE IMPRESSÃO
Versão 4 — 18/10/2026. Valem para qualquer fatiador (Cura, PrusaSlicer, Bambu, Orca).

IMPORTAÇÃO
- Unidade: milímetros. Escala: 100%. Não redimensionar para a mesa.
- NÃO girar nem deitar as peças: os STL já estão na orientação certa.
  Moldura: frente na mesa. Corpo: deitado sobre o fundo. Chaves: deitadas.
- Imprimir UMA cópia de cada arquivo. O arquivo de chaves já tem as 8 chaves.
- Maior medida de qualquer arquivo: 129 mm (cabe em 180 x 180 x 180 mm).

MATERIAL E MÁQUINA
- PLA, bico 0,4 mm.
- Bico 205 °C (faixa 200–215 °C, conforme o fabricante do PLA).
- Mesa 60 °C. Ventilador da peça a 100% a partir da 3ª camada.
- Use a mesma cor nas duas metades de cada peça. Sugestão: moldura preta,
  corpo na cor que preferir.

QUALIDADE (todas as peças)
- Altura de camada: 0,20 mm (primeira camada 0,20 mm).
- Paredes/perímetros: 4 (cerca de 1,7 mm).
- Camadas sólidas: 5 no topo e 5 no fundo.
- Preenchimento: 20% giroide (ou grade/cúbico). Exceção: chaves com 100%.
- Velocidade da parede externa: até 30 mm/s. Pontes: 20 mm/s.
- Compensação XY/horizontal: 0. Compensação de pé de elefante: 0,1 mm, se houver.
- Costura (seam): alinhada atrás ou "mais próxima"; evite aleatória na moldura.

SUPORTES: DESLIGADOS EM TODOS OS ARQUIVOS
- As peças foram desenhadas para imprimir sem suporte. Os únicos balanços são
  detalhes pequenos que imprimem sem ajuda: faces de trava dos ganchos
  (ressalto de até 1 mm, faces a 60° e tetos dos bolsos a 75°, de 17 mm²), topo dos furos USB-C (ponte de
  13,5 mm numa parede de 3 mm), topo das fendas de ventilação (3 mm) e o
  interior dos furos de pino de 2,2 mm.
- Suporte automático ENCHERIA os ganchos, as molas, os bolsos e as fendas,
  e as peças deixariam de encaixar. Se o fatiador sugerir suporte, recusar.

ADESÃO À MESA
- Corpo (02) e testes (00): brim de 5 mm (peças altas ou tiras finas em pé).
- Moldura (01) e chaves (04): só saia (skirt), sem brim. A face da
  moldura que encosta na mesa é a frente do case: mesa limpa e lisa
  (vidro ou PEI liso) dá o melhor acabamento.

POR ARQUIVO (ver também DIMENSOES.csv)
  arquivo                         preench.  adesão     tamanho (mm)
  00-TESTE-encaixe-moldura        20%       brim 5     26 x 129 x 26
  00-TESTE-encaixe-corpo          20%       brim 5     26 x 126 x 83
  01-MOLDURA-esquerda             20%       saia       102 x 129 x 26
  01-MOLDURA-direita              20%       saia       102 x 129 x 26
  02-CORPO-esquerdo               20%       brim 5     102 x 126 x 83
  02-CORPO-direito                20%       brim 5     102 x 126 x 83
  04-CHAVES-8un                   100%      saia       84 x 58 x 3

FILAMENTO
- Cerca de 280 g de PLA no total. É uma estimativa pelo volume das peças; o
  fatiador da faculdade dará o valor exato.

O QUE NÃO ALTERAR
- Não engrossar paredes nem aplicar "reparo" automático da malha. Os STL são
  fechados (estanques), e as partes finas são intencionais: saia da moldura
  2 mm, ganchos 1,6 mm, molas 1,2 mm, chaves 1,4 e 3 mm.
  Elas precisam flexionar ou encaixar com folgas de 0,15 a 0,35 mm.
