DJLIMA1/FIAP-ChargeGridApp-GS1-2026/firmware/esp32/src/panel_hardware_waveshare7.cpp

#ifdef CHARGEGRID_PANEL_ENABLED

#include <Arduino.h>
#include <esp_display_panel.hpp>
#include "lvgl_v8_port.h"

using namespace esp_panel::board;
using namespace esp_panel::drivers;

namespace {
Board* board = nullptr;
}

bool chargegridPanelHardwareSetup() {
  Serial.println("[panel] Waveshare ESP32-S3-Touch-LCD-7 800x480");
  board = new Board();
  if (!board || !board->init()) return false;

  // A tela RGB lê continuamente da PSRAM. Dois framebuffers permitem trocar
  // a imagem no VSYNC, sem desenhar no buffer que está sendo exibido.
  auto* lcd = board->getLCD();
  auto* bus = lcd ? lcd->getBus() : nullptr;
  if (!lcd || !bus || bus->getBasicAttributes().type != ESP_PANEL_BUS_TYPE_RGB) return false;
  if (!lcd->configFrameBufferNumber(LVGL_PORT_DISP_BUFFER_NUM)) return false;
  // Preserva os 16 MHz do perfil Waveshare. Nesta placa, 10 MHz produziu
  // alternância de cores no LCD apesar do framebuffer correto.
  if (!static_cast<BusRGB*>(bus)->configRGB_FreqHz(16000000)) return false;
  // 20 linhas por bloco (antes 10) dão mais margem à DMA durante o Wi-Fi.
  if (!static_cast<BusRGB*>(bus)->configRGB_BounceBufferSize(lcd->getFrameWidth() * 20)) return false;
  if (!board->begin()) return false;
  return lvgl_port_init(board->getLCD(), board->getTouch());
}

bool chargegridPanelCapture() {
  auto* lcd = board ? board->getLCD() : nullptr;
  auto* frame = lcd ? static_cast<uint16_t*>(lcd->getFrameBufferByIndex(0)) : nullptr;
  if (!frame) return false;
  constexpr size_t width = 400, height = 240, bytes = width * height * sizeof(uint16_t);
  auto* copy = static_cast<uint16_t*>(heap_caps_malloc(bytes, MALLOC_CAP_SPIRAM | MALLOC_CAP_8BIT));
  if (!copy) return false;
  if (!lvgl_port_lock(100)) { heap_caps_free(copy); return false; }
  for (size_t y = 0; y < height; ++y)
    for (size_t x = 0; x < width; ++x) {
#if LVGL_PORT_ROTATION_DEGREE == 180
      // O framebuffer guarda a imagem já girada para a tela; a captura volta ao sentido de leitura.
      copy[y * width + x] = frame[(479 - y * 2) * 800 + (799 - x * 2)];
#else
      copy[y * width + x] = frame[(y * 2) * 800 + x * 2];
#endif
    }
  lvgl_port_unlock();
  Serial.printf("CG_FRAME_RGB565 %u %u %u\n", (unsigned)width, (unsigned)height, (unsigned)bytes);
  Serial.write(reinterpret_cast<uint8_t*>(copy), bytes);
  Serial.flush();
  Serial.println("\nCG_FRAME_END");
  heap_caps_free(copy);
  return true;
}

#endif
