DJLIMA1/FIAP-ChargeGridApp-GS1-2026/firmware/esp32/src/sensors.cpp

#include "sensors.h"
#include <algorithm>
void SimulatedSensors::start() { energyWh = 0; }
Reading SimulatedSensors::read(bool charging, unsigned long elapsedMs, float powerW) {
  const float power = charging ? powerW : 0.0f;
  energyWh += power * elapsedMs / 3600000.0f;
  return {std::min(100.0f, 20.0f + energyWh / 600.0f), energyWh, power, charging};
}
