DJLIMA1/FIAP-ChargeGridApp-GS1-2026/firmware/esp32/include/chargegrid_logo.h

#pragma once

#ifdef CHARGEGRID_PANEL_ENABLED
#include <lvgl.h>

#ifdef __cplusplus
extern "C" {
#endif

extern const lv_img_dsc_t chargegrid_logo_64x64;

#ifdef __cplusplus
}
#endif
#endif  // CHARGEGRID_PANEL_ENABLED
