DJLIMA1/FIAP-ChargeGridApp-GS1-2026/firmware/esp32/include/panel_service_config.h

#pragma once

#define CHARGEGRID_DEFAULT_API_BASE_URL "https://chargegrid-api-preview-djlima1s-projects.vercel.app"

// GTS Root R1, raiz pública da cadeia TLS atual de *.vercel.app.
static const char CHARGEGRID_ROOT_CA[] = R"PEM(-----BEGIN CERTIFICATE-----
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
bP6MvPJwNQzcmRk13NfIRmPVNnGuV/u3gm3c
-----END CERTIFICATE-----)PEM";
