DJLIMA1/FIAP-ChargeGridApp-GS1-2026/tools/device_simulator.py

"""Bancada simulada do protocolo ESP32; nenhuma saída física é acionada."""
import argparse
import json
import os
import signal
import sys
import time
import uuid
from datetime import datetime, timezone
from pathlib import Path


def utc_now():
    return datetime.now(timezone.utc).isoformat()


def timestamp(value):
    return datetime.fromisoformat(value.replace("Z", "+00:00")).timestamp()


def number(value, low, high):
    """Número da API (Decimal chega como texto); None se ausente ou fora da faixa."""
    try:
        parsed = float(value)
    except (TypeError, ValueError):
        return None
    return parsed if low <= parsed <= high else None


SOC_SOURCES = ("simulated", "phone")
# Mesma versão do firmware do painel cujo protocolo a bancada reproduz (runtime.h).
FIRMWARE_VERSION = "0.9.7"
LEGACY_FIRMWARE_VERSION = "0.4.0"
# Pagamento pelo QR do painel (connector.payment): estados que o painel mostra; outros são ignorados.
PAYMENT_STATUSES = ("awaiting_payment", "authorized", "paid", "declined")
# Totem de autoatendimento 0.8.0 (connector.kiosk, kiosk_order, authorized.session.origin).
TOTEM_METHODS = ("simulated", "stripe")
TOTEM_ORDER_STATUSES = ("held", "awaiting_payment", "paid", "charging", "finished", "canceled", "expired", "failed")
TOTEM_OPEN = ("held", "awaiting_payment", "paid")
SESSION_ORIGINS = ("app", "kiosk_qr", "kiosk_totem")
BENCH_POWER_W = 7200  # Potência nominal simulada da bancada.
BENCH_MIN_POWER_W = 1400  # 6 A em 230 V: menor corrente de recarga AC.
# Firmware 0.7.0+ (SET_POWER desde a 0.5.0): ajuste de potência ao vivo. ``legacy=True`` simula o 0.4.0.
CAPABILITIES = ["set_power_v1"]
# Permanência após a recarga: com termos de taxa no START (``parameters.overstay``) o cabo
# simulado continua conectado depois da parada, até ``unplug()`` (SIGUSR1 na linha de comando)
# ou ``unplug_after`` segundos. Sem termos: desconecta ao parar, como antes.
UNPLUG_AFTER_SECONDS = 120
# Todo conector é um carregador GoodWe HCA G2: a API manda ``connector.charger_link`` ({model,
# transport, address, host}) e a tela reporta ``charger`` com address/link. Como no painel: no
# START, carregador online → recarga por Modbus; offline → ACK ``failed`` ``charger_offline``
# (sem simulação interna). Sem ``charger_link`` (API antiga) a bancada carrega como antes.
# Por padrão há um carregador simulado respondendo no endereço, com os limites da bancada
# (``hca_link=None``); ``--hca-link`` (``hca_link=True``) emula os registradores do HCA G2 (GW7K,
# 7,0 kW); ``--hca-offline``/``hca_link=False`` começa sem resposta (kill -USR2 alterna). O Modbus
# TCP é SIMULADO aqui (registradores em memória, tools/edge/modbus_sim); nenhum hardware é acessado.
# Estação = a tela: com ``chargers`` na resposta do sync (carregadores adicionais da tela), a
# bancada sincroniza por cada um com ``charger_address`` (``Station``; capacidade multi_charger_v1).
MULTI_CHARGER = "multi_charger_v1"
HCA_MODEL, HCA_TRANSPORT = "goodwe_hca_g2", "modbus_tcp"


def load_charger(name, variant="GW7K-HCA-20", fail_writes=0, echo=None):
    """Adaptador de carregador + transporte SIMULADO (nenhuma conexão real)."""
    if name in (None, "", "bench"):
        return None, None
    if name != "goodwe-hca-g2":
        raise ValueError(f"Carregador desconhecido: {name}")
    try:
        from chargegrid_core.chargers import GoodWeHcaG2
    except ImportError:
        sys.path.insert(0, str(Path(__file__).resolve().parents[1] / "packages" / "chargegrid_core"))
        from chargegrid_core.chargers import GoodWeHcaG2
    if str(Path(__file__).resolve().parents[1]) not in sys.path:
        sys.path.insert(0, str(Path(__file__).resolve().parents[1]))  # execução direta: python tools/…
    from tools.edge.modbus_sim import SimulatedModbusTransport
    driver = GoodWeHcaG2(variant)
    transport = SimulatedModbusTransport(variant, fail_writes=fail_writes, echo=echo)
    for item in driver.setup_writes():
        transport.write(item.address, item.value)
    return driver, transport


def power_cap_w(*sources):
    """Potência simulada: min(nominal, max_power_kw do START/sessão); sem limite = nominal."""
    for source in sources:
        cap = number((source or {}).get("max_power_kw"), 0.1, 1000)
        if cap is not None:
            return min(BENCH_POWER_W, cap * 1000)
    return BENCH_POWER_W


class Device:
    def __init__(self, state_path=None, clock=time.monotonic, *, legacy=False, charger=None, transport=None,
                 unplug_after=UNPLUG_AFTER_SECONDS, hca_link=None, hca_address=None, hca_variant="GW7K-HCA-20",
                 charger_address=None):
        self.path = Path(state_path) if state_path else None
        self.clock = clock
        saved = json.loads(self.path.read_text()) if self.path and self.path.exists() else {}
        self.version = saved.get("version", 0)
        self.last_command = saved.get("last_command")
        self.session_id = saved.get("session_id")
        self.energy = saved.get("energy_wh", 0.0)
        self.state = "stopped" if self.session_id else "idle"
        self.reason = "communication_lost" if self.session_id else None
        # SoC do veículo (mesmas regras do firmware): None = desconhecido.
        self.soc_start = saved.get("soc_start") if self.session_id else None
        self.battery_kwh = saved.get("battery_kwh") if self.session_id else None
        self.soc_source = saved.get("soc_source") if self.session_id else None
        self.phone_soc = self.soc_start if self.soc_source == "phone" else None
        self.boot_id = str(uuid.uuid4())
        self.sequence = 0
        self.acks = []
        self.connected = False
        self.last_sync = clock()
        self.last_tick = clock()
        self.started = None
        self.limits = {}
        self.power_w = BENCH_POWER_W
        self.reservation_expires = None
        self.legacy = legacy
        self.charger = charger
        self.transport = transport
        # Carregador GoodWe do conector: endereço vindo da API (ou ``hca_address`` com API antiga,
        # sem ``charger_link``) e se ele responde na rede local simulada (``hca_link``). A sessão
        # guarda o modo do START (``session_on_charger``): Modbus ou simulação interna.
        self.base_charger, self.base_transport = charger, transport
        self.hca_variant = hca_variant
        self.hca_charger = self.hca_transport = None
        self.link_address = None
        self.link_online = hca_link is not False and not legacy
        # True: registradores do HCA G2 emulados (GW7K); None: carregador simulado com os limites da bancada.
        self.hca_emulated = hca_link is True
        self.session_on_charger = False
        if not legacy and hca_address is not None:
            self.link_charger(hca_address)
        self.presence_code = None
        self.public_code = None
        # Carregador adicional de uma tela (sync endereçado): ``charger_address`` no corpo.
        self.charger_address = charger_address
        # Cabo simulado: segurar após a parada só quando a sessão tem termos de permanência.
        # Após um reboot o cabo volta desconectado (a API encerra a permanência com segurança).
        self.hold_cable = False
        self.unplug_after = unplug_after if unplug_after is not None and unplug_after >= 0 else None
        self.stopped_at = None
        self.overstay = None
        # connector.kiosk_url / connector.payment (modo teste), validados como no firmware.
        self.kiosk_url = None
        self.payment = None
        # Totem 0.8.0: connector.kiosk, kiosk_order e authorized.session.origin (API nova; ausentes = desligado).
        self.totem = None
        self.kiosk_order = None
        self.session_origin = None

    def save(self):
        if self.path:
            self.path.parent.mkdir(parents=True, exist_ok=True)
            temporary = self.path.with_suffix(".tmp")
            temporary.write_text(json.dumps({"version": self.version, "last_command": self.last_command,
                                             "session_id": self.session_id, "energy_wh": self.energy,
                                             "soc_start": self.soc_start, "battery_kwh": self.battery_kwh,
                                             "soc_source": self.soc_source}))
            os.chmod(temporary, 0o600)
            temporary.replace(self.path)

    def reset_soc(self):
        self.soc_start = self.battery_kwh = self.soc_source = self.phone_soc = None

    def read_start_soc(self, source):
        if not source:
            return
        soc = number(source.get("soc_percent"), 0, 100)
        battery = number(source.get("battery_kwh"), 1, 1000)
        if soc is not None:
            self.soc_start = soc
        if battery is not None:
            self.battery_kwh = battery
        if source.get("soc_source") in SOC_SOURCES:
            self.soc_source = source["soc_source"]

    def full_energy(self):
        """Wh até 100 % na fonte simulada; None quando o SoC não é acompanhado."""
        if self.soc_source != "simulated" or self.soc_start is None or not self.battery_kwh:
            return None
        return (100 - self.soc_start) / 100 * self.battery_kwh * 1000

    def soc_known(self):
        return self.phone_soc is not None if self.soc_source == "phone" else self.full_energy() is not None

    def soc(self):
        if self.soc_source == "phone" and self.phone_soc is not None:
            return self.phone_soc
        if self.full_energy() is not None:
            return min(100, self.soc_start + self.energy / (10 * self.battery_kwh))
        return min(100, 20 + self.energy / 600)  # Bancada legada, sem SoC da API.

    def max_power_w(self):
        return self.charger.limits().max_power_w if self.charger else BENCH_POWER_W

    def link_charger(self, address):
        """Endereço do carregador GoodWe do conector (1–247; ``None`` = API sem charger_link)."""
        if address == self.link_address:
            return
        self.link_address = address
        self.hca_charger, self.hca_transport = (load_charger("goodwe-hca-g2", self.hca_variant)
                                                if address is not None and self.hca_emulated else (None, None))

    def read_charger_link(self, connector):
        """``connector.charger_link`` do sync. Ausente (API antiga): mantém o endereço atual.
        Durante a recarga o carregador não muda (a API também recusa a troca)."""
        if self.legacy or "charger_link" not in connector or self.state == "charging":
            return
        link = connector.get("charger_link")
        address = link.get("address") if isinstance(link, dict) else None
        valid = (isinstance(link, dict) and link.get("model") == HCA_MODEL and link.get("transport") == HCA_TRANSPORT
                 and isinstance(address, int) and not isinstance(address, bool) and 1 <= address <= 247)
        self.link_charger(address if valid else None)

    def charger_ready(self):
        """Carregador do endereço respondendo agora: o próximo START usa Modbus."""
        return self.link_address is not None and self.link_online

    def choose_session_mode(self):
        """No START: Modbus no carregador do endereço; sem ``charger_link`` (API antiga), a bancada."""
        self.session_on_charger = self.charger_ready()
        self.charger, self.transport = ((self.hca_charger, self.hca_transport)
                                        if self.session_on_charger and self.hca_emulated
                                        else (self.base_charger, self.base_transport))

    def charger_unreachable(self):
        """Recarga iniciada por Modbus e o carregador sumiu (a simulada nunca depende dele)."""
        return self.session_on_charger and not self.link_online

    def charger_info(self):
        """Como o painel: quem carrega (modo da sessão; fora dela, o do próximo START) e, com
        endereço, ``address``/``link`` (offline = START recusado; limites de sempre)."""
        via_charger = self.session_on_charger if self.state == "charging" else self.charger_ready()
        if via_charger and self.hca_emulated:
            info = {**self.hca_charger.capability(), "transport": HCA_TRANSPORT}
        elif self.base_charger:
            info = {**self.base_charger.capability(), "transport": "simulated"}
        else:
            info = {"model": "simulated_bench", "transport": "simulated", "min_power_w": BENCH_MIN_POWER_W,
                    "max_power_w": BENCH_POWER_W, "step_w": 100, "phases": 1}
        if self.link_address is not None:
            info.update(address=self.link_address, link="online" if self.link_online else "offline")
        return info

    def install_power(self, power_w):
        """Instala o limite (W). Com adaptador, escreve os registradores e só confirma pela
        releitura. Devolve (aplicado, erro)."""
        power_w = max(0, min(int(power_w), self.max_power_w()))
        if self.charger_unreachable():
            return self.power_w, "charger_unreachable"
        if not self.charger:
            self.power_w = power_w
            return power_w, None
        from chargegrid_core.chargers import apply_power
        from chargegrid_core.chargers.goodwe_hca_g2 import WATCHED

        from tools.edge.modbus_sim import ModbusError
        try:
            result = apply_power(self.charger, self.transport, power_w, WATCHED)
        # Exceção Modbus simulada, valor recusado pelo adaptador ou falha de E/S: o limite anterior continua.
        except (ModbusError, ValueError, OSError) as exc:
            return self.power_w, f"modbus_error: {exc}"[:200]
        if not result["confirmed"]:
            return self.power_w, "readback_mismatch"
        self.power_w = result["applied_power_w"]
        return self.power_w, None

    def read_kiosk(self, connector):
        """``connector.kiosk_url``/``payment`` do sync (API com pagamento pelo QR). Só ``https://``
        com até 160 caracteres vira QR; status desconhecido ou campo ausente (API antiga): nada."""
        url = connector.get("kiosk_url")
        self.kiosk_url = url if isinstance(url, str) and url.startswith("https://") and len(url) <= 160 else None
        payment = connector.get("payment")
        if isinstance(payment, dict) and payment.get("status") in PAYMENT_STATUSES:
            amount = number(payment.get("amount"), 0, 1000000)
            self.payment = {"status": payment["status"], "amount": f"{amount:.2f}" if amount is not None else None,
                            "environment": payment.get("environment")}
        else:
            self.payment = None

    def read_totem(self, response):
        """Totem 0.8.0 (contrato em docs/esp32-protocol.md): só com o totem ligado no posto."""
        kiosk = (response.get("connector") or {}).get("kiosk")
        self.totem = kiosk if isinstance(kiosk, dict) and kiosk.get("method") in TOTEM_METHODS + (None,) else None
        order = response.get("kiosk_order")
        self.kiosk_order = order if isinstance(order, dict) and order.get("status") in TOTEM_ORDER_STATUSES else None
        session = (response.get("authorized") or {}).get("session") or {}
        self.session_origin = session.get("origin") if session.get("origin") in SESSION_ORIGINS else None

    def stop(self, reason):
        self.state = "stopped"
        self.connected = self.hold_cable and self.connected
        self.stopped_at = self.clock() if self.connected else None
        self.reason = reason
        self.save()

    def unplug(self):
        """Motorista desconecta o cabo (simulado). Nunca durante a carga."""
        if self.state == "charging" or not self.connected:
            return False
        self.connected = False
        self.hold_cable = False
        self.stopped_at = None
        return True

    def tick(self):
        now = self.clock()
        elapsed = now - self.last_tick
        self.last_tick = now
        if self.state == "reserved" and self.reservation_expires and time.time() >= self.reservation_expires:
            self.state = "idle"
        if (self.state != "charging" and self.stopped_at is not None and self.unplug_after is not None
                and now - self.stopped_at >= self.unplug_after):
            self.unplug()
        if self.state != "charging":
            return
        if self.charger_unreachable():
            # Recarga por Modbus e o carregador sumiu: a tela para a sessão com segurança e reporta a falha.
            self.stop("charger_unreachable")
            return
        # Só integra o tempo até o watchdog ou limite local.
        deadline = min(self.last_sync + 45, self.started + self.limits.get("max_duration_minutes", 60) * 60)
        self.energy += self.power_w * max(0, min(now, deadline) - (now - elapsed)) / 3600
        price = float(self.limits.get("price_per_kwh", 0)) * (1 - float(self.limits.get("discount_percent", 0)) / 100)
        cost_limit = self.limits.get("max_cost")
        energy_limit = float(cost_limit) / price * 1000 if cost_limit is not None and price > 0 else None
        if energy_limit is not None:
            self.energy = min(self.energy, energy_limit)
        full = self.full_energy()
        if full is not None:
            self.energy = min(self.energy, full)  # Nunca além dos 100 %.
        if now >= self.last_sync + 45:
            self.stop("communication_lost")
        elif now >= deadline:
            self.stop("duration_limit")
        elif full is not None and self.energy >= full:
            self.stop("battery_full")
        elif energy_limit is not None and self.energy >= energy_limit:
            self.stop("cost_limit")
        self.save()

    def payload(self):
        self.tick()
        self.sequence += 1
        self.save()
        # SoC próprio só na fonte simulada; phone ou sem dados de bateria: null (nunca eco da API).
        report_soc = self.session_id and self.soc_source == "simulated" and self.soc_known()
        body = {"boot_id": self.boot_id, "sequence": self.sequence, "firmware_version": LEGACY_FIRMWARE_VERSION if self.legacy else FIRMWARE_VERSION,
                "session_id": self.session_id, "physical_state": self.state, "connected": self.connected,
                "soc_percent": round(self.soc(), 2) if report_soc else None,
                "energy_wh": self.energy, "power_w": self.power_w if self.state == "charging" else 0,
                "source": "simulated", "captured_at": utc_now(), "end_reason": self.reason, "acks": list(self.acks)}
        if not self.legacy:
            body.update(capabilities=list(CAPABILITIES) + [MULTI_CHARGER], charger=self.charger_info(),
                        applied_power_w=self.power_w if self.state == "charging" else 0)
        if self.charger_address is not None:
            body["charger_address"] = self.charger_address
        return body

    def response(self, response):
        self.last_sync = self.clock()
        self.acks = []
        server_time = timestamp(response["server_time"])
        authorization = response["authorized"]
        current_version = int(response["control_version"])
        reservation = authorization.get("reservation")
        self.reservation_expires = timestamp(reservation["expires_at"]) if reservation else None
        new_session = authorization.get("session")
        if self.state == "stopped" and ((new_session and new_session["id"] != self.session_id) or (reservation and not new_session)):
            self.session_id = None
            self.energy = 0
            self.reason = None
            self.reset_soc()
        if new_session and self.session_id and new_session["id"] == self.session_id:
            # O app pode trocar a fonte para o celular; o nível do celular só é exibido/repassado.
            if new_session.get("soc_source") in SOC_SOURCES:
                self.soc_source = new_session["soc_source"]
            if self.battery_kwh is None:
                self.battery_kwh = number(new_session.get("battery_kwh"), 1, 1000)
            if self.soc_start is None:
                self.soc_start = number(new_session.get("start_soc_percent"), 0, 100)
            if self.soc_source == "phone":
                phone = number(new_session.get("soc_percent"), 0, 100)
                self.phone_soc = phone if phone is not None else (
                    self.phone_soc if self.phone_soc is not None else self.soc_start)
        self.overstay = response.get("overstay")
        connector = response.get("connector") or {}
        self.presence_code = connector.get("presence_code")
        self.public_code = connector.get("public_code")
        self.read_kiosk(connector)
        self.read_totem(response)
        self.read_charger_link(connector)
        changed = False
        for command in response["commands"]:
            identifier = command["id"]
            version = int(command["version"])
            if identifier == self.last_command:
                restarted_start = command["type"] == "START" and self.state != "charging"
                ack = {"command_id": identifier, "status": "failed" if restarted_start else "applied",
                       "error": "previous_session_requires_reconciliation" if restarted_start else None}
                if command["type"] == "SET_POWER":
                    ack["applied_power_w"] = self.power_w
                self.acks.append(ack)
                continue
            if version <= self.version or version < current_version or timestamp(command["expires_at"]) <= server_time:
                continue
            kind = command["type"]
            error = None
            if kind == "START":
                session = authorization.get("session")
                if not session or session["id"] != command["session_id"]:
                    error = "unauthorized_session"
                elif self.session_id:
                    error = "previous_session_requires_reconciliation"
                elif self.link_address is not None and not self.link_online:
                    # Como o painel: carregador do endereço sem resposta → START recusado, sem simulação.
                    error = "charger_offline"
                else:
                    self.choose_session_mode()
                    self.session_id = command["session_id"]
                    self.energy = 0
                    self.save()
                    self.reason = None
                    self.state = "charging"
                    self.connected = True  # Conexão de bancada explicitamente simulada.
                    self.hold_cable = not self.legacy and bool((command.get("parameters") or {}).get("overstay"))
                    self.stopped_at = None
                    self.started = self.clock()
                    self.last_tick = self.clock()
                    self.limits = dict(session)
                    # Limite de potência do posto/motorista (parameters prevalecem; API antiga: nominal).
                    # Firmware novo usa power_limit_w (pode ser 0: começa pausado até sobrar folga).
                    start_limit = (command.get("parameters") or {}).get("power_limit_w")
                    if not self.legacy and start_limit is not None:
                        self.install_power(number(start_limit, 0, 1000000) or 0)
                    else:
                        self.install_power(power_cap_w(command.get("parameters"), session))
                    self.reset_soc()
                    self.read_start_soc(session)
                    self.read_start_soc(command.get("parameters"))  # parameters prevalecem.
                    if self.soc_start is not None and self.soc_source is None:
                        self.soc_source = "simulated"
                    if self.soc_source == "phone":
                        self.phone_soc = self.soc_start
                    self.save()
            elif kind == "RESERVE":
                reservation = authorization.get("reservation")
                if not reservation or reservation["id"] != command["reservation_id"] or self.session_id:
                    error = "unauthorized_reservation"
                else:
                    self.state = "reserved"
                    self.reservation_expires = timestamp(reservation["expires_at"])
            elif kind == "STOP":
                if self.session_id and command["session_id"] != self.session_id:
                    error = "session_mismatch"
                elif not (self.state == "stopped" and self.reason):
                    reason = (command.get("parameters") or {}).get("reason")
                    full = reason == "battery_full" or (
                        self.soc_source == "phone" and self.phone_soc is not None and self.phone_soc >= 100)
                    self.stop("battery_full" if full else "requested")
            elif kind == "RELEASE":
                if self.state == "charging":
                    error = "charging_requires_stop"
                else:
                    self.state = "idle"
                    self.connected = False
            elif kind == "SET_POWER" and not self.legacy:
                limit = number((command.get("parameters") or {}).get("power_limit_w"), 0, 1000000)
                if self.state != "charging" or command.get("session_id") != self.session_id:
                    error = "no_active_session"
                elif limit is None:
                    error = "invalid_power_limit"
                else:
                    self.tick()  # Energia até aqui na potência antiga; daqui em diante, na nova.
                    _, error = self.install_power(limit)
            else:
                error = "unknown_command"
            ack = {"command_id": identifier, "status": "failed" if error else "applied", "error": error}
            if kind == "SET_POWER" and not self.legacy:
                ack["applied_power_w"] = self.power_w
            self.acks.append(ack)
            if not error:
                self.version = version
                self.last_command = identifier
                self.save()
                changed = True
        self.version = max(self.version, current_version)
        # Só elimina o resultado final após servidor confirmar a ausência de sessão.
        if self.state != "charging" and not authorization.get("session") and not self.acks:
            self.session_id = None
            self.energy = 0
            self.reason = None
            self.reset_soc()
            self.state = "idle" if not authorization.get("reservation") else self.state
        self.save()
        return changed


class Station:
    """Estação = a tela: o ponto da própria tela (``screen``) e um ``Device`` por carregador
    adicional listado em ``chargers`` na resposta do sync da tela (sync endereçado por cada um)."""

    def __init__(self, screen, make_child):
        self.screen = screen
        self.make_child = make_child
        self.children = {}

    def follow(self, response):
        """Acompanha a lista de carregadores da tela; um carregador removido só sai ocioso."""
        listed = set()
        for item in response.get("chargers") or []:
            address = item.get("address") if isinstance(item, dict) else None
            if isinstance(address, int) and not isinstance(address, bool) and 1 <= address <= 247:
                listed.add(address)
        for address in sorted(listed - set(self.children)):
            self.children[address] = self.make_child(address)
        for address in [key for key in self.children if key not in listed]:
            if self.children[address].state != "charging":
                del self.children[address]

    def exchange_all(self, post):
        """Sync da tela e de cada carregador (``post(body) -> resposta``). True = algo mudou."""
        response = post(self.screen.payload())
        changed = self.screen.response(response)
        self.follow(response)
        for child in self.children.values():
            changed = child.response(post(child.payload())) or changed
        return changed, response


def charger_text(device):
    """`` carregador=1 goodwe_hca_g2 modbus_tcp (SIMULADO, online) recarga=modbus``; vazio sem endereço."""
    if device.link_address is None:
        return ""
    mode = ""
    if device.state == "charging":
        mode = " recarga=modbus" if device.session_on_charger else " recarga=simulacao_da_central"
    return (f" carregador={device.link_address} {HCA_MODEL} {HCA_TRANSPORT} (SIMULADO, "
            f"{'online' if device.link_online else 'offline'}){mode}")


def kiosk_text(device):
    """Linha do terminal igual ao painel: QR de pagamento, o último pagamento e o totem."""
    order = device.kiosk_order
    if order:
        return f" | Totem: {order.get('status_label') or order['status']}"
    payment = device.payment
    if payment:
        amount = f" · R$ {payment['amount'].replace('.', ',')}" if payment["amount"] else ""
        label = {"awaiting_payment": "Aguardando pagamento", "authorized": "Pagamento confirmado",
                 "paid": "Pagamento confirmado", "declined": "Pagamento recusado"}[payment["status"]]
        return f" | {label}{amount}"
    return f" | Sem o app? Pague aqui: {device.kiosk_url}" if device.kiosk_url else ""


def overstay_text(block):
    """Linha do terminal igual ao painel: "desconecte em mm:ss" e depois a taxa."""
    if not block:
        return ""
    if block.get("status") == "grace":
        seconds = int(block.get("grace_remaining_seconds") or 0)
        return f" | Recarga concluída — desconecte em {seconds // 60:02d}:{seconds % 60:02d}"
    if block.get("status") in ("billing", "capped"):
        return f" | Taxa de permanência: R$ {str(block.get('fee_due') or '0.00').replace('.', ',')}"
    return " | Recarga concluída — desconecte o cabo"


def _reais(value):
    return "R$ " + f"{float(value):.2f}".replace(".", ",")


def _kwh(value):
    return f"{float(value):.1f}".replace(".", ",") + " kWh"


class KioskRunner:
    """Percorre o totem 0.8.0 pelos endpoints do dispositivo e imprime as "telas" (T0…T8).

    ``request(method, path, json=None, headers=None)`` chama a API com a chave do dispositivo;
    ``exchange()`` faz um sync do ``Device`` (o START/STOP chegam por ele, como no painel).
    Encerrar é local (``Device.stop``), sem endpoint. Funciona nos dois modos do dono do posto:
    simulado (Modo apresentação) e Stripe teste (QR do pedido; alguém paga pelo celular).
    """

    def __init__(self, device, request, exchange, *, echo=print, wait=time.sleep, timeout=60, pay_timeout=600):
        self.device, self.request, self.exchange = device, request, exchange
        self.echo, self.wait, self.timeout, self.pay_timeout = echo, wait, timeout, pay_timeout
        self.screens = []

    def screen(self, name, text):
        line = f"[{name}] {text}"
        self.screens.append(line)
        self.echo(line)

    def _json(self, response, *expected):
        if response.status_code not in (expected or (200,)):
            raise RuntimeError(f"{response.status_code}: {response.text[:200]}")
        return response.json()

    def _until(self, done, limit, step=1):
        waited = 0
        while not done():
            if waited >= limit:
                return False
            self.wait(step)
            waited += step
            self.exchange()
        return True

    def run(self, mode="value", value="20.00", charge_seconds=20):
        self.exchange()
        totem = self.device.totem
        if not totem:
            self.screen("T0", "Totem desligado neste posto (sem connector.kiosk): telas atuais")
            return {"status": "disabled"}
        code = self.device.presence_code or "#F-----"
        self.screen("T0", f"Pronto · [Iniciar recarga] · Tem o app? Use este código {code}")
        offer = self._json(self.request("GET", "/v1/devices/kiosk/offer"))
        if not offer["enabled"] or not offer["available"]:
            self.screen("TE", f"Indisponível: {offer.get('reason_label') or offer.get('reason')}")
            return {"status": "unavailable", "reason": offer.get("reason")}
        label = f" · {offer['label']}" if offer.get("label") else ""
        self.screen("T1", f"Como cobrar? Por valor (R$) · Por tempo (min) · Por energia (kWh){label} "
                          "· Conecte o cabo ao carro")
        limits = offer["modes"][mode]
        shortcuts = ", ".join(str(item) for item in limits["shortcuts"])
        self.screen("T2", f"Quanto ({mode})? Atalhos: {shortcuts} · Outro valor {limits['min']}–{limits['max']} "
                          f"· escolhido: {value}")
        field = {"value": "amount", "time": "minutes", "energy": "energy_kwh"}[mode]
        body = {"mode": mode, field: int(value) if mode == "time" else str(value)}
        quote = self._json(self.request("POST", "/v1/devices/kiosk/quote", json=body))
        order = None
        for _ in range(2):
            demand = quote["demand"].get("reason_label") or "Preço normal"
            overstay = (quote.get("overstay") or {}).get("summary") or "Sem taxa de permanência"
            self.screen("T3", f"Revisar: {_reais(quote['price_per_kwh'])}/kWh travado ({demand}, "
                              f"{quote['demand_multiplier']}×) · teto {_reais(quote['total'])} · "
                              f"~{_kwh(quote['estimated_energy_kwh'])} · até {quote['max_duration_minutes']} min · "
                              f"{overstay} · {quote['label']} · [Aceitar e pagar]")
            payload = {**body, "quote_hash": quote["quote_hash"],
                       "overstay_terms_version": (quote.get("overstay") or {}).get("version")}
            response = self.request("POST", "/v1/devices/kiosk/orders", json=payload,
                                    headers={"Idempotency-Key": f"sim-order-{uuid.uuid4()}"})
            if response.status_code == 409 and response.json()["error"]["code"] == "quote_changed":
                quote = response.json()["error"]["quote"]
                self.screen("T3", "O orçamento mudou: revise os novos valores")
                continue
            order = self._json(response, 201)
            break
        if order is None:
            return {"status": "quote_changed"}
        paid = self._json(self.request("POST", f"/v1/devices/kiosk/orders/{order['id']}/pay", json={},
                                       headers={"Idempotency-Key": f"sim-pay-{order['id']}"}))
        if order["method"] == "simulated":
            self.screen("T4", f"Simular pagamento de {_reais(quote['total'])} (sem cobrança) · SIMULADO")
        else:
            self.screen("T4", f"Pague pelo QR (Stripe · TESTE): {paid['payment']['qr_url']} · cartão 4242 4242 4242 4242")
            confirmed = self._until(lambda: (self.device.kiosk_order or {}).get("status") not in TOTEM_OPEN[:2],
                                    self.pay_timeout)
            if not confirmed:
                self.request("POST", f"/v1/devices/kiosk/orders/{order['id']}/cancel")
                self.screen("T0", "Tempo esgotado: pedido cancelado, nada cobrado")
                return {"status": "canceled", "order": order["id"]}
        status = (self.device.kiosk_order or paid)["status"]
        if status in ("failed", "expired", "canceled"):
            self.screen("TE", "Não foi possível iniciar; valor devolvido")
            return {"status": status, "order": order["id"]}
        self.screen("T5", "Pagamento confirmado · iniciando")
        if not self._until(lambda: self.device.state == "charging", self.timeout):
            self.screen("TE", "Não foi possível iniciar; valor devolvido")
            return {"status": "start_timeout", "order": order["id"]}
        origin = self.device.session_origin or "?"
        elapsed = 0
        while self.device.state == "charging" and elapsed < charge_seconds:
            self.wait(1)
            elapsed += 1
            self.exchange()
            cap = self.device.limits.get("max_cost")
            self.screen("T6", f"Ao vivo ({origin}): {self.device.energy / 1000:.3f} kWh · "
                              f"{self.device.power_w if self.device.state == 'charging' else 0} W · "
                              f"teto {_reais(cap) if cap else '-'} · {elapsed} s · [Encerrar]")
        if self.device.state == "charging":
            self.screen("T7", "Encerrar a recarga? [Sim] [Não] → Sim (parada local)")
            self.device.stop("requested_stop")
        self._until(lambda: ((self.device.kiosk_order or {}).get("receipt") or {}).get("final"), self.timeout)
        receipt = (self.device.kiosk_order or {}).get("receipt") or {}
        returned = f" · devolvido {_reais(receipt['returned'])}" if receipt.get("returned") else ""
        self.screen("T8", f"Recibo {receipt.get('number')} · {receipt.get('end_reason_label') or receipt.get('end_reason')}"
                          f" · {receipt.get('energy_kwh')} kWh · total {_reais(receipt.get('total') or 0)}{returned}"
                          f" ({receipt.get('return_kind')}) · QR do recibo: {receipt.get('url')}")
        return {"status": (self.device.kiosk_order or {}).get("status"), "order": order["id"], "receipt": receipt,
                "method": order["method"]}


def main():
    import httpx
    parser = argparse.ArgumentParser(description=__doc__)
    parser.add_argument("--api", default=os.getenv("CHARGEGRID_API_URL", "https://localhost:8000"))
    parser.add_argument("--state", default=".device-simulator-state.json")
    parser.add_argument("--allow-local-http", action="store_true", help="Só localhost para teste local")
    parser.add_argument("--charger", choices=["bench", "goodwe-hca-g2"], default="bench",
                        help="goodwe-hca-g2: traduz SET_POWER em registradores Modbus num transporte SIMULADO")
    parser.add_argument("--hca-model", default="GW7K-HCA-20", choices=["GW7K-HCA-20", "GW11K-HCA-20", "GW22K-HCA-20"])
    parser.add_argument("--hca-fail-writes", type=int, default=0, help="Perde as N primeiras escritas (teste de ACK)")
    parser.add_argument("--legacy", action="store_true", help="Simula firmware 0.4.0 (sem SET_POWER)")
    parser.add_argument("--hca-link", action="store_true",
                        help="Emula os registradores do GoodWe HCA G2 (Modbus TCP SIMULADO, GW7K) no endereço do "
                             "conector; sem a opção, o carregador simulado responde com os limites da bancada. "
                             "kill -USR2 <pid> alterna online/offline; offline, o START é recusado (charger_offline)")
    parser.add_argument("--hca-address", type=int, choices=range(1, 248), metavar="1-247", default=None,
                        help="Endereço usado enquanto a API não mandar charger_link (API antiga)")
    parser.add_argument("--hca-offline", action="store_true", help="Começa com o carregador inalcançável")
    parser.add_argument("--kiosk", action="store_true",
                        help="Totem 0.8.0: percorre oferta → orçamento → pedido → pagar → START → recarga → "
                             "Encerrar → recibo pelos endpoints do dispositivo e sai")
    parser.add_argument("--kiosk-mode", choices=["value", "time", "energy"], default="value")
    parser.add_argument("--kiosk-amount", default=None, help="R$ (valor), minutos (tempo) ou kWh (energia)")
    parser.add_argument("--kiosk-charge-seconds", type=int, default=20, help="Segundos carregando antes de Encerrar")
    parser.add_argument("--unplug-after", type=float, default=UNPLUG_AFTER_SECONDS,
                        help="Com taxa de permanência aceita, desconecta o cabo simulado N s após a parada "
                             "(negativo: só manual, com kill -USR1 <pid>)")
    args = parser.parse_args()
    from urllib.parse import urlparse
    url = urlparse(args.api)
    if url.scheme != "https" and not (args.allow_local_http and url.scheme == "http" and url.hostname in {"localhost", "127.0.0.1", "::1"}):
        parser.error("Use HTTPS validado; HTTP só localhost com --allow-local-http")
    key = os.environ.get("CHARGEGRID_DEVICE_KEY")
    if not key:
        parser.error("Defina CHARGEGRID_DEVICE_KEY com a chave individual")
    charger, transport = load_charger(args.charger, args.hca_model, args.hca_fail_writes, echo=print)
    device = Device(args.state, legacy=args.legacy, charger=charger, transport=transport,
                    unplug_after=args.unplug_after, hca_link=True if args.hca_link else None,
                    hca_address=args.hca_address, hca_variant=args.hca_model)
    device.link_online = not args.hca_offline and not args.legacy

    def make_child(address):
        print(f"Carregador adicional {address} desta central (GoodWe HCA G2 SIMULADO, online)")
        return Device(f"{args.state}.charger-{address}.json", unplug_after=args.unplug_after,
                      hca_link=True if args.hca_link else None, hca_address=address,
                      hca_variant=args.hca_model, charger_address=address)

    station = Station(device, make_child)
    if hasattr(signal, "SIGUSR2"):
        def toggle_link(*_):
            device.link_online = not device.link_online
            print(f"Carregador GoodWe simulado: {'online' if device.link_online else 'offline'}")
        signal.signal(signal.SIGUSR2, toggle_link)
        print(f"Alternar o carregador HCA simulado (online/offline): kill -USR2 {os.getpid()}")
    unplug_requested = []
    if hasattr(signal, "SIGUSR1"):
        signal.signal(signal.SIGUSR1, lambda *_: unplug_requested.append(True))
        print(f"Desconectar o cabo simulado: kill -USR1 {os.getpid()}")
    if args.kiosk:
        with httpx.Client(timeout=10, follow_redirects=False) as client:
            auth = {"Authorization": "Device " + key}

            def request(method, path, json=None, headers=None):
                return client.request(method, args.api.rstrip("/") + path, json=json, headers={**auth, **(headers or {})})

            def exchange():
                result = client.post(args.api.rstrip("/") + "/v1/devices/sync", json=device.payload(), headers=auth)
                result.raise_for_status()
                device.response(result.json())
                return result.json()

            default = {"value": "20.00", "time": "15", "energy": "5.0"}[args.kiosk_mode]
            outcome = KioskRunner(device, request, exchange).run(args.kiosk_mode, args.kiosk_amount or default,
                                                                 args.kiosk_charge_seconds)
            print(json.dumps(outcome, ensure_ascii=False))
            sys.exit(0 if outcome.get("status") == "finished" else 1)
    interval = 1
    next_sync = 0
    with httpx.Client(timeout=10, follow_redirects=False) as client:
        while True:
            device.tick()
            if unplug_requested:
                unplug_requested.clear()
                if device.unplug():
                    print("Cabo simulado desconectado.")
                    next_sync = 0  # informa a desconexão já
            if time.monotonic() >= next_sync:
                def post(body):
                    result = client.post(args.api.rstrip("/") + "/v1/devices/sync", json=body,
                                         headers={"Authorization": "Device " + key})
                    result.raise_for_status()
                    return result.json()

                try:
                    changed, response = station.exchange_all(post)
                    interval = max(1, min(30, response["sync_interval_seconds"]))
                    next_sync = time.monotonic() if changed else time.monotonic() + interval
                    soc = f" soc={device.soc():.1f}% ({device.soc_source})" if device.soc_known() else ""
                    power = f" power_w={device.power_w if device.state == 'charging' else 0}"
                    cable = " cabo=conectado" if device.connected else ""
                    print(f"{device.state} source=simulated energy_wh={device.energy:.2f}{power}{soc}{cable}"
                          f"{charger_text(device)}{overstay_text(device.overstay)}{kiosk_text(device)}")
                    for address, child in station.children.items():
                        print(f"  carregador {address}: {child.state} energy_wh={child.energy:.2f}"
                              f"{charger_text(child)}")
                except (httpx.HTTPError, ValueError, KeyError):
                    interval = min(30, interval * 2)
                    next_sync = time.monotonic() + interval
                    print("Sync indisponível; watchdog local continua ativo.")
            time.sleep(0.1)


if __name__ == "__main__":
    main()
