DJLIMA1/FIAP-ChargeGridApp-GS1-2026/firmware/esp32/src/panel_ui.cpp

#include "panel_ui.h"

#ifndef CHARGEGRID_PANEL_ENABLED

void panelSetup() {}
void panelTick() {}

#else

#include <Arduino.h>
#include <WiFi.h>
#include <lvgl.h>
#include <time.h>
#include "runtime.h"
#include "lvgl_v8_port.h"
#include "panel_hardware.h"
#include "chargegrid_logo.h"
#include "panel_fonts.h"
#include "panel_network.h"
#include "panel_claim.h"
#ifdef CHARGEGRID_KIOSK
#include "kiosk_flow.h"
#include "extra_chargers.h"
#include "ui/router.h"
#include "ui/strings_ptbr.h"
#endif


// O port da placa deve chamar lv_disp_drv_register/lv_indev_drv_register antes
// de panelSetup(). A escolha do port depende do modelo Waveshare 7 ou 7B.
//
// Layout: o design de referência do totem é 2:1 (800x400 a 0,25x); o painel é 5:3.
// Em vez de faixas pretas, as posições verticais são esticadas em 1,2 (400 -> 480)
// e a interface ocupa os 800x480 inteiros.
namespace {
// Fundo e gradiente usam valores exatos de RGB565 (R/B em múltiplos de 8, G de 4):
// qualquer outro tom "pula" de matiz entre as faixas do degradê no painel de 16 bits.
const lv_color_t COLOR_BG = LV_COLOR_MAKE(0x18, 0x1C, 0x20);
const lv_color_t COLOR_BG_TOP = LV_COLOR_MAKE(0x20, 0x24, 0x28);
const lv_color_t COLOR_CARD = LV_COLOR_MAKE(0x20, 0x24, 0x28);
const lv_color_t COLOR_CONTROL = LV_COLOR_MAKE(0x23, 0x28, 0x30);
const lv_color_t COLOR_LINE = LV_COLOR_MAKE(0x26, 0x2B, 0x31);
const lv_color_t COLOR_RED = LV_COLOR_MAKE(0xD7, 0x2B, 0x32);
const lv_color_t COLOR_TEXT = LV_COLOR_MAKE(0xF5, 0xF5, 0xF5);
const lv_color_t COLOR_SOFT = LV_COLOR_MAKE(0xD6, 0xDA, 0xE0);
const lv_color_t COLOR_MUTED = LV_COLOR_MAKE(0x7A, 0x82, 0x8E);
const lv_color_t COLOR_GREEN = LV_COLOR_MAKE(0x1E, 0xDF, 0x5A);
const lv_color_t COLOR_AMBER = LV_COLOR_MAKE(0xFF, 0xC6, 0x2E);

lv_obj_t *statusLabel, *codeLabel, *connectionLabel, *connectionDot;
lv_obj_t *energyLabel, *costLabel, *timeLabel, *sessionTimeLabel;
lv_obj_t *instructionLabel, *stopButton;
lv_obj_t *codeCaptionLabel, *codeHintLabel;
lv_obj_t *codeTimerLabel, *codeProgressBar, *codeCard;
lv_obj_t *darkRoot, *alertRoot, *leftBlock, *rowLineTop, *rowLineBottom;
lv_obj_t *stepsCard, *reservationCard, *sessionCard, *messageCard;
lv_obj_t *batteryCard, *socLabel, *socDetailLabel, *socBar;
lv_obj_t *messageTitle, *messageDetail;
lv_obj_t *alertTitle, *alertSub, *alertBrand, *alertLogoPad;
lv_obj_t *pumpBody, *pumpSide, *pumpScreen, *pumpBolt, *pumpNozzle, *pumpHose;
lv_obj_t *configScreen, *configKeyboard, *ssidInput, *passwordInput, *configStatus;
lv_obj_t *claimCard, *claimQr, *claimNetworkButton;
char lastClaimQr[80]{};
// 0.7.0: QR de pagamento (modo teste) na tela Pronto e botão "Desconectar" da permanência.
lv_obj_t *kioskCard, *kioskTitle, *kioskDetail, *kioskQrBox, *kioskQr, *disconnectButton;
char lastKioskQr[164]{};
// 0.8.0: botão "Iniciar recarga" do totem na tela Pronto (oculto com o totem desligado).
lv_obj_t* kioskStartButton = nullptr;
lv_obj_t* kioskAlertStartButton = nullptr;
lv_obj_t* panelScreen = nullptr;
unsigned long logoPressedAt = 0, clearArmedAt = 0;
volatile bool configSaveRequested = false, configClearRequested = false;
char requestedSsid[33]{}, requestedPassword[65]{};
unsigned long lastRefresh = 0;
bool ready = false;
volatile bool localStopRequested = false;
volatile bool localDisconnectRequested = false;
portMUX_TYPE snapshotMux = portMUX_INITIALIZER_UNLOCKED;
enum class PanelMode : uint8_t { Ready, Reserved, Charging, Message, Unavailable, Maintenance };
struct PanelSnapshot {
  char status[64], alertTitle[40], code[64], connection[48], energy[24];
  char cost[24], remaining[32], instruction[128];
  char codeCaption[32], codeHint[64];
  char codeTimer[40];
  uint8_t codeProgress;
  char messageTitle[64], messageDetail[128];
  char claimUrl[80];
  char kioskUrl[164], kioskDetail[80];
  uint8_t kioskTone; // 0 neutro, 1 aguardando, 2 confirmado, 3 recusado
  bool showKiosk, showDisconnect;
  bool showKioskStart;   // 0.8.0: totem ligado e ponto livre na tela Pronto
  char soc[8], socDetail[32];
  uint8_t socProgress;
  bool showSoc;
  PanelMode mode;
  bool showClaim;
  bool showStop;
  bool online;
} snapshot{};

lv_obj_t* label(lv_obj_t* parent, const char* text, const lv_font_t* font,
                lv_color_t color) {
  lv_obj_t* value = lv_label_create(parent);
  lv_label_set_text(value, text);
  lv_obj_set_style_text_font(value, font, 0);
  lv_obj_set_style_text_color(value, color, 0);
  return value;
}

// Contêiner transparente sem borda, padding nem rolagem.
lv_obj_t* plain(lv_obj_t* parent, int x, int y, int width, int height) {
  lv_obj_t* value = lv_obj_create(parent);
  lv_obj_set_pos(value, x, y);
  lv_obj_set_size(value, width, height);
  lv_obj_set_style_bg_opa(value, LV_OPA_TRANSP, 0);
  lv_obj_set_style_border_width(value, 0, 0);
  lv_obj_set_style_radius(value, 0, 0);
  lv_obj_set_style_pad_all(value, 0, 0);
  lv_obj_clear_flag(value, LV_OBJ_FLAG_SCROLLABLE);
  return value;
}

lv_obj_t* card(lv_obj_t* parent, int x, int y, int width, int height) {
  lv_obj_t* value = plain(parent, x, y, width, height);
  lv_obj_set_style_bg_opa(value, LV_OPA_COVER, 0);
  lv_obj_set_style_bg_color(value, COLOR_CARD, 0);
  lv_obj_set_style_radius(value, 12, 0);
  return value;
}

// Bloco liso (sem bordas) para a ilustração do carregador.
lv_obj_t* shape(lv_obj_t* parent, int x, int y, int width, int height, int radius) {
  lv_obj_t* value = plain(parent, x, y, width, height);
  lv_obj_set_style_bg_opa(value, LV_OPA_COVER, 0);
  lv_obj_set_style_radius(value, radius, 0);
  return value;
}

void gradient(lv_obj_t* target, lv_color_t top, lv_color_t bottom) {
  lv_obj_set_style_bg_opa(target, LV_OPA_COVER, 0);
  lv_obj_set_style_bg_color(target, top, 0);
  lv_obj_set_style_bg_grad_color(target, bottom, 0);
  lv_obj_set_style_bg_grad_dir(target, LV_GRAD_DIR_VER, 0);
}

lv_obj_t* hline(lv_obj_t* parent, int y) {
  lv_obj_t* line = plain(parent, 39, y, 711, 1);
  lv_obj_set_style_bg_opa(line, LV_OPA_COVER, 0);
  lv_obj_set_style_bg_color(line, COLOR_LINE, 0);
  return line;
}

void stopClicked(lv_event_t*) { localStopRequested = true; }
#ifdef CHARGEGRID_KIOSK
void kioskStartClicked(lv_event_t*) { ui::pushAction(kiosk::Action::StartFlow); }
#endif
void disconnectClicked(lv_event_t*) { localDisconnectRequested = true; }

// Números em pt-BR (vírgula decimal) para os textos novos do painel.
void decimalComma(char* out, size_t size, const char* format, float value) {
  snprintf(out, size, format, value);
  for (char* c = out; *c; ++c) if (*c == '.') *c = ',';
}
void brl(char* out, size_t size, float value) { decimalComma(out, size, "R$ %.2f", value); }

// Permanência: o carro continua conectado depois de parar (START com overstay).
bool overstayView() { return reading.connected && (state == "stopped" || state == "idle"); }

void inputFocused(lv_event_t* event) {
  lv_keyboard_set_textarea(configKeyboard, static_cast<lv_obj_t*>(lv_event_get_target(event)));
}
void closeConfig(lv_event_t*) {
  lv_textarea_set_text(passwordInput, "");
  clearArmedAt = 0;
  lv_obj_add_flag(configScreen, LV_OBJ_FLAG_HIDDEN);
}
void openConfig(lv_event_t*) {
  lv_textarea_set_text(passwordInput, "");
  lv_label_set_text(configStatus, "Senha vazia: rede aberta. Identidade do dispositivo preservada.");
  lv_obj_clear_flag(configScreen, LV_OBJ_FLAG_HIDDEN);
}
void saveConfig(lv_event_t*) {
  const char* ssid = lv_textarea_get_text(ssidInput);
  const char* password = lv_textarea_get_text(passwordInput);
  if (!validPanelNetwork(ssid, password)) {
    lv_label_set_text(configStatus, "Informe o SSID. Para rede aberta, deixe a senha vazia.");
    return;
  }
  taskENTER_CRITICAL(&snapshotMux);
  snprintf(requestedSsid, sizeof(requestedSsid), "%s", ssid);
  snprintf(requestedPassword, sizeof(requestedPassword), "%s", password);
  configSaveRequested = true;
  taskEXIT_CRITICAL(&snapshotMux);
  lv_label_set_text(configStatus, "Salvando e reiniciando para conectar...");
}
void clearConfig(lv_event_t*) {
  if (!clearArmedAt || millis() - clearArmedAt > 5000) {
    clearArmedAt = millis();
    lv_label_set_text(configStatus, "Toque em Limpar novamente para confirmar.");
    return;
  }
  configClearRequested = true;
  lv_label_set_text(configStatus, "Limpando a rede e reiniciando...");
}
void logoEvent(lv_event_t* event) {
  if (lv_event_get_code(event) == LV_EVENT_PRESSED) logoPressedAt = millis();
  if (lv_event_get_code(event) == LV_EVENT_RELEASED && millis() - logoPressedAt >= 5000) {
    openConfig(nullptr);
  }
}

bool batteryFullStop() { return state == "stopped" && endReason == "battery_full"; }

const char* statusTitle() {
  if (state == "charging") return chargePowerW > 0 ? "Recarga em andamento" : "Recarga pausada";
  if (overstayView()) return batteryFullStop() ? "Bateria cheia" : "Recarga concluída";
  if (batteryFullStop()) return "Bateria cheia";
  if (state == "reserved") return "Ponto reservado";
  if (state == "stopped") return "Recarga encerrada";
  if (state == "fault") return "Ponto indisponível";
  if (panelIntegrationEnabled && WiFi.status() != WL_CONNECTED) return "Ponto indisponível";
  if (panelIntegrationEnabled && WiFi.status() == WL_CONNECTED && (lastSyncHttpStatus == 401 || lastSyncHttpStatus == 403)) return "Ponto indisponível";
  if (!hasSynced) return "Só um instante";
  if (millis() - lastContact >= 45000 && state == "idle") return "Ponto indisponível";
  if (connectorOwnershipKnown && !panelOwned) return "Em configuração";
  if (!connectorActive) return "Em breve";
  if (chargerLink.configured() && !chargerLink.online()) return "Carregador indisponível";
  return "Pronto para você";
}

const char* instruction() {
  if (state == "charging") return "Acompanhe pelo app. Para parar, toque em Encerrar.";
  if (overstayView()) return "Retire o cabo do carro e toque em Desconectar.";
  if (state == "reserved") return WiFi.status() == WL_CONNECTED ?
      "Sua reserva está ativa. Inicie pelo app antes do prazo." :
      "Sua reserva continua ativa. Aguarde a conexão para iniciar.";
  if (batteryFullStop()) return "A recarga parou sozinha em 100%. Seu resumo está no app.";
  if (state == "stopped") return "Obrigado por usar ChargeGrid. Seu resumo está no app.";
  if (state == "fault") return "Este ponto está indisponível. Encontre outro no app.";
  if (WiFi.status() != WL_CONNECTED) return "Estamos reconectando. Encontre outro ponto pelo app.";
  if (lastSyncHttpStatus == 401 || lastSyncHttpStatus == 403) return "Este ponto precisa de configuração. Procure outro no app.";
  if (!hasSynced) return "Estamos preparando este ponto para você.";
  if (millis() - lastContact >= 45000) return "A conexão caiu. Encontre outro ponto pelo app.";
  if (connectorOwnershipKnown && !panelOwned) return "O responsável está preparando este ponto.";
  if (!connectorActive) return "Estamos fazendo alguns ajustes para melhorar sua experiência.";
  if (chargerLink.configured() && !chargerLink.online()) return "A central está online, mas o carregador não responde. Aguarde a reconexão.";
  return "Abra o app ChargeGrid e use o código ao lado para iniciar a recarga.";
}

// Cores da ilustração e do texto nas telas de alerta (vermelha / manutenção).
void applyAlertTheme(bool maintenance) {
  const lv_color_t top = maintenance ? lv_color_make(0xFE, 0xA5, 0x03) : lv_color_make(0xEC, 0x17, 0x1B);
  const lv_color_t bottom = maintenance ? lv_color_make(0xFD, 0x98, 0x02) : lv_color_make(0xC1, 0x07, 0x0B);
  const lv_color_t ink = maintenance ? lv_color_make(0x1B, 0x1B, 0x1B) : lv_color_white();
  gradient(alertRoot, top, bottom);
  lv_obj_set_style_text_color(alertTitle, ink, 0);
  lv_obj_set_style_text_color(alertSub, ink, 0);
  lv_obj_set_style_text_color(alertBrand, ink, 0);
  lv_obj_set_style_bg_color(alertLogoPad, maintenance ? lv_color_make(0x1B, 0x1B, 0x1B) : lv_color_white(), 0);
  const lv_color_t body = maintenance ? lv_color_make(0xFB, 0xB0, 0x0C) : lv_color_make(0xF3, 0x2B, 0x2D);
  const lv_color_t screen = maintenance ? lv_color_make(0xF0, 0x90, 0x04) : lv_color_make(0xA8, 0x0A, 0x0C);
  const lv_color_t side = maintenance ? lv_color_make(0xE6, 0x8A, 0x04) : lv_color_make(0x95, 0x08, 0x0A);
  lv_obj_set_style_bg_color(pumpBody, body, 0);
  lv_obj_set_style_bg_color(pumpSide, side, 0);
  lv_obj_set_style_bg_color(pumpScreen, screen, 0);
  lv_obj_set_style_bg_color(pumpNozzle, body, 0);
  lv_obj_set_style_img_recolor(pumpBolt, body, 0);
  lv_obj_set_style_line_color(pumpHose, body, 0);
}

// Estado do último desenho das telas atuais. Zerado quando as telas são reconstruídas
// depois de uma tela do totem (objetos novos começam com os valores padrão).
struct RefreshCache {
  bool painted = false, lastOnline = false;
  PanelMode lastMode = PanelMode::Message;
  uint8_t lastCodeProgress = 255, lastSocProgress = 255, lastKioskTone = 255;
  bool lastKioskStart = false;
} cache;

#ifdef CHARGEGRID_KIOSK
kiosk::KioskView kioskSnapshot{};   // publicado em panelTick sob snapshotMux
#endif

void refresh() {
  PanelSnapshot current;
#ifdef CHARGEGRID_KIOSK
  static kiosk::KioskView kioskCurrent;
  taskENTER_CRITICAL(&snapshotMux);
  current = snapshot;
  kioskCurrent = kioskSnapshot;
  taskEXIT_CRITICAL(&snapshotMux);
  // Tela do totem na frente: as telas atuais estão liberadas e não são atualizadas.
  if (ui::routerUpdate(kioskCurrent)) return;
#else
  taskENTER_CRITICAL(&snapshotMux);
  current = snapshot;
  taskEXIT_CRITICAL(&snapshotMux);
#endif
  // LVGL invalidates objects even when a setter receives the same value. On
  // this RGB panel, rewriting the whole UI every 500 ms causes needless flushes.
  auto setTextIfChanged = [](lv_obj_t* target, const char* value) {
    if (std::strcmp(lv_label_get_text(target), value) != 0) lv_label_set_text(target, value);
  };
  auto setHiddenIfChanged = [](lv_obj_t* target, bool hidden) {
    if (lv_obj_has_flag(target, LV_OBJ_FLAG_HIDDEN) == hidden) return;
    if (hidden) lv_obj_add_flag(target, LV_OBJ_FLAG_HIDDEN);
    else lv_obj_clear_flag(target, LV_OBJ_FLAG_HIDDEN);
  };
  bool& painted = cache.painted;
  bool& lastOnline = cache.lastOnline;
  PanelMode& lastMode = cache.lastMode;
  const bool alert = !current.showClaim &&
      (current.mode == PanelMode::Unavailable || current.mode == PanelMode::Maintenance);
  setTextIfChanged(statusLabel, current.status);
  setTextIfChanged(alertTitle, current.alertTitle);
  setTextIfChanged(codeLabel, current.code);
  setTextIfChanged(codeCaptionLabel, current.codeCaption);
  setTextIfChanged(codeHintLabel, current.codeHint);
  setTextIfChanged(codeTimerLabel, current.codeTimer);
  uint8_t& lastCodeProgress = cache.lastCodeProgress;
  if (lastCodeProgress != current.codeProgress) {
    lv_bar_set_value(codeProgressBar, current.codeProgress, LV_ANIM_OFF);
    lastCodeProgress = current.codeProgress;
  }
  setTextIfChanged(connectionLabel, current.connection);
  if (!painted || current.online != lastOnline)
    lv_obj_set_style_bg_color(connectionDot, current.online ? COLOR_GREEN : COLOR_AMBER, 0);
  if (!painted || current.mode != lastMode)
    applyAlertTheme(current.mode == PanelMode::Maintenance);
  setTextIfChanged(energyLabel, current.energy);
  setTextIfChanged(costLabel, current.cost);
  setTextIfChanged(timeLabel, current.remaining);
  setTextIfChanged(sessionTimeLabel, current.remaining);
  setTextIfChanged(instructionLabel, current.instruction);
  setTextIfChanged(alertSub, current.instruction);
  setTextIfChanged(messageTitle, current.messageTitle);
  setTextIfChanged(messageDetail, current.messageDetail);
  setTextIfChanged(socLabel, current.soc);
  setTextIfChanged(socDetailLabel, current.socDetail);
  uint8_t& lastSocProgress = cache.lastSocProgress;
  if (lastSocProgress != current.socProgress) {
    lv_bar_set_value(socBar, current.socProgress, LV_ANIM_OFF);
    lastSocProgress = current.socProgress;
  }
  const PanelMode mode = current.mode;
  const bool dark = !alert;
  const bool detail = dark && !current.showClaim;
  setHiddenIfChanged(darkRoot, !dark);
  setHiddenIfChanged(alertRoot, !alert);
  setHiddenIfChanged(leftBlock, !detail);
  setHiddenIfChanged(codeCard, !(detail && (mode == PanelMode::Ready || mode == PanelMode::Reserved)));
  setHiddenIfChanged(rowLineTop, !detail);
  setHiddenIfChanged(rowLineBottom, !detail);
  const bool kiosk = detail && mode == PanelMode::Ready && current.showKiosk;
  setHiddenIfChanged(stepsCard, !(detail && mode == PanelMode::Ready) || kiosk);
  setHiddenIfChanged(kioskCard, !kiosk);
  setHiddenIfChanged(kioskQrBox, !kiosk);
  // Com o QR de pagamento, o cartão do código sobe e as linhas param antes do QR.
  const int codeY = kiosk ? 118 : 130, codeHeight = kiosk ? 172 : 180, lineWidth = kiosk ? 531 : 711;
  if (lv_obj_get_y(codeCard) != codeY) { lv_obj_set_y(codeCard, codeY); lv_obj_set_height(codeCard, codeHeight); }
  if (lv_obj_get_width(rowLineTop) != lineWidth) {
    lv_obj_set_width(rowLineTop, lineWidth); lv_obj_set_width(rowLineBottom, lineWidth);
  }
  if (kiosk && std::strcmp(lastKioskQr, current.kioskUrl) != 0 &&
      lv_qrcode_update(kioskQr, current.kioskUrl, std::strlen(current.kioskUrl)) == LV_RES_OK)
    snprintf(lastKioskQr, sizeof(lastKioskQr), "%s", current.kioskUrl);
  setTextIfChanged(kioskDetail, current.kioskDetail);
  uint8_t& lastKioskTone = cache.lastKioskTone;
  if (lastKioskTone != current.kioskTone) {
    const lv_color_t tones[] = {COLOR_MUTED, COLOR_AMBER, COLOR_GREEN, LV_COLOR_MAKE(0xFF, 0x6B, 0x70)};
    lv_obj_set_style_text_color(kioskDetail, tones[current.kioskTone & 3], 0);
    lastKioskTone = current.kioskTone;
  }
  setHiddenIfChanged(reservationCard, !(detail && mode == PanelMode::Reserved));
  setHiddenIfChanged(sessionCard, !(detail && mode == PanelMode::Charging));
  setHiddenIfChanged(messageCard, !(detail && mode == PanelMode::Message));
  setHiddenIfChanged(stopButton, !(detail && current.showStop));
  setHiddenIfChanged(disconnectButton, !(detail && current.showDisconnect && !current.showStop));
  // Bateria do veículo: acima do botão (Encerrar/Desconectar); centrada no fim da sessão.
  const bool battery = detail && current.showSoc &&
      (mode == PanelMode::Charging || mode == PanelMode::Message);
  setHiddenIfChanged(batteryCard, !battery);
  const bool actionButton = current.showStop || current.showDisconnect;
  const int batteryY = actionButton ? 112 : 152, stopY = battery ? 270 : 188;
  const int stopHeight = battery ? 56 : 64;
  if (lv_obj_get_y(batteryCard) != batteryY) lv_obj_set_y(batteryCard, batteryY);
  if (lv_obj_get_y(stopButton) != stopY) {
    lv_obj_set_y(stopButton, stopY); lv_obj_set_height(stopButton, stopHeight);
  }
  if (lv_obj_get_y(disconnectButton) != stopY) {
    lv_obj_set_y(disconnectButton, stopY); lv_obj_set_height(disconnectButton, stopHeight);
  }
  setHiddenIfChanged(codeProgressBar, mode != PanelMode::Ready && mode != PanelMode::Reserved);
  setHiddenIfChanged(codeTimerLabel, mode != PanelMode::Ready && mode != PanelMode::Reserved);
  if (current.showClaim) {
    if (std::strcmp(lastClaimQr, current.claimUrl) != 0) {
      if (lv_qrcode_update(claimQr, current.claimUrl, std::strlen(current.claimUrl)) == LV_RES_OK)
        snprintf(lastClaimQr, sizeof(lastClaimQr), "%s", current.claimUrl);
    }
    setHiddenIfChanged(claimCard, false);
  } else {
    setHiddenIfChanged(claimCard, true);
    if (lastClaimQr[0]) {
      // Remove the displayed secret, not just the overlay, after ownership.
      lv_color_t whiteIndex{}; whiteIndex.full = 1;
      lv_canvas_fill_bg(claimQr, whiteIndex, LV_OPA_COVER);
      memset(lastClaimQr, 0, sizeof(lastClaimQr));
    }
  }
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
