DJLIMA1/FIAP-ChargeGridApp-GS1-2026/(commit log)

2026-09-17 feat: initial commit - ChargeGridApp Flet Global Solution 2026
2026-09-21 feat(api): add authenticated charging backend and database migrations
2026-09-21 feat(esp32): integrate Waveshare panel and device validation tooling
2026-09-21 feat: polish ownership onboarding and stabilize ESP32 panel
    [api_client.cpp, charging_controller.cpp, firmware_behavior.cpp]
2026-09-21 feat: expose physical panel linking flow
2026-09-21 fix: stabilize Waveshare RGB display refresh
    [api_client.cpp, lvgl_v8_port.h, main.cpp, package_panel.py, panel_hardware_waveshare7.cpp]
2026-09-21 feat: polish customer panel and unify ChargeGrid branding
2026-09-21 Add confirmed ESP32 factory reset from seller app
    [api_client.cpp, charging_controller.cpp, firmware_behavior.cpp, main.cpp, package_panel.py]
2026-09-21 Restore point controls after failed device reset
2026-09-21 Block credential changes while ESP32 reset is pending
2026-09-21 Document physical ESP32 update and final APK
2026-09-21 Fix factory reset claim permission and recover ESP32 pairing
    [panel_serial.py]
2026-09-22 Documenta integração, circuito e resultados do ChargeGrid
2026-09-22 feat: add station presence code flow
2026-09-27 feat: recover app flows and unify map experience
    Add isolated demo account, guided charging and seller flows, contextual chat, and consistent station maps. Preserve API presence and reservation fixes, regression tests, assets, and validation documentation.
    [generate_demo_map.py]
2026-09-29 Improve ChargeGrid experience, discovery, and reliability
2026-10-13 Add session events log, station refresh and USB prototype planning docs
2026-10-13 Add chargegrid_core shared domain package with sync tooling
2026-10-13 Add owner analytics to chargegrid_core (KPIs, series, heatmap, ranking, alerts, CSV)
2026-10-13 Add owner dashboard API: overview, timeseries, heatmap, tables, exports, alerts, live
2026-10-13 Add chargegrid_core.ai assistant core and OpenRouter benchmark tool
2026-10-13 Add driver shift and charging planner to chargegrid_core
    Vehicle presets, simplified charge curve, heuristic demand curve with
    pluggable DemandSignal, dynamic-programming planner coupling meals with
    charging, naive-strategy comparison and next-stop quick mode.
2026-10-13 Add driver mode API: profile, shift plan, next stop and station amenities
    New driver_profiles table and stations.amenities column (migration
    e7d3c1a95b42). Plans use real stations, saved profile and an optional
    Open-Meteo weather signal with short timeout, cache and silent fallback.
2026-10-13 Fix coupon case sensitivity, rate-limit window bypass and client IP behind Vercel, reset without session
2026-10-13 Add driver mode screen with demo support and home entry
    New Motorista screen (vehicle presets, shift/meal preferences, timeline,
    SoC chart, stops with station/reservation actions, profit vs naive),
    local profile store, demo /driver routes backed by chargegrid_core with
    a lazily created partner network with amenities.
2026-10-13 Polish driver screen layout and next-stop wording
2026-10-13 Document driver mode algorithm, API and limitations
2026-10-13 Keep retired-point lookup off the devices scan in point serialization
2026-10-13 Rebase hot-path index migration onto driver mode migration
2026-10-13 Driver screen: keep 0% battery, open offline from local profile, AA warning colours
2026-10-13 Batch-serialize stations for driver planning
2026-10-13 Duration presets in charging limits, coupon cards and empty states, readable filter summary
2026-10-13 Owner insights: accept dashboard filters and use chargegrid_core.analytics; demo dashboard uses real AI with a local key
2026-10-13 Driver next stop: never advise keep driving when the battery cannot cover the shift; reject invalid HH:MM minutes
2026-10-13 Driver mode: scroll to results, readable demand source and wording; home highlights driver mode and AI assistant; station amenities
2026-10-13 Sign-in highlights and onboarding/profile copy present driver mode, AI and owner dashboard
2026-10-13 Rate-limit driver plan/next-stop per user
2026-10-13 AI driver tool plans with stations around the driver (place or device location), nearest-first station list
2026-10-13 Document review changes in API, driver and AI docs
2026-10-13 Add local live contract check: real API vs demo for driver, owner dashboard and AI endpoints
2026-10-13 Profile: consistent secondary button for editing
2026-10-13 Highlight charge_needed next stop and explain unfinished-session insight (409)
2026-10-13 Driver: never show '-0 km' above reserve
2026-10-13 Add demo screenshots: home differentials, driver mode, AI chat, owner dashboard
2026-10-14 Car in sign-up and profile, redesigned shift planner and point editor, no ESP32 wording in the app
2026-10-18 Shell polish from verification: thin back chevron, segmented and button colors, warning box, nav icons, hidden nav on empty vendor home
2026-10-18 Consumer/operator feedback: centered car scene, right-aligned chat bubble, account rows reordered, car field in profile style, coupons removed from the driver area
2026-10-19 Printable tilted case for the Waveshare 7" panel (screwless snap-fit)
    Official Waveshare dimensions (glass 192.96 x 110.76, TP+LCD 5.00, PCB from STEP),
    parametric generator (manifold3d), STLs oriented for Ender-3/PLA without supports:
    front bezel, 20-degree wedge body with printed springs, snap-on base, fit-test coupons.
    Digital checks: zero interference, overhangs <= 45 degrees, tip-over force.
2026-10-19 Panel case v1 for the college printer: no branding, halves with bow-tie keys, 3 mm walls
    Removes the ChargeGrid text from bezel and back. Every part is split at the centre to fit
    the 180 x 180 x 180 mm limit (largest file 131 mm), joined by printed bow-tie keys and glue.
    Adds entrega-faculdade/ (9 STL, print settings, lab note, dimensions, SHA-256) and its zip;
    STLs re-verified after writing: watertight, no null triangles, zero interference.
2026-10-19 Panel case v2: 15-degree tilt, rear base removed
    Tilt reduced from 20 to 15 degrees and the chin from 9 to 7 mm. The rear base plate is now
    optional and off (usar_base=False): no base files, floor slots/ribs or base keys; key lot is
    8 pieces. College package v2: 7 STL (largest 129 mm), updated settings, lab note and README.
    Re-verified: zero interference, watertight files, overhangs within 45 degrees.
2026-10-19 Panel case v3: screen reclined to 30 degrees from the table
    Tilt goes to 60 degrees from vertical; the front lifts off the table with a sloped skirt sized
    automatically (Z_FOOT) to keep 3 mm around the bottom hooks. The body now prints lying on its
    bottom, so the seam keys move to a floor rib and the springs steepen to 60 degrees. Tip-over
    check now covers both directions: only a 21 N press at the top tips it. A build-time assert
    keeps the hidden bezel key inside the chin. College package v3: 7 STL, largest 129 mm.
2026-10-19 Panel case v4: fixes from the independent pre-print audit
    Hooks get 0.15 mm axial play (tolerates print sag) and spring preload rises to 0.50 so the
    effective preload stays 0.35 mm; window-hook lip 1.2 -> 1.0 mm (~1% strain) with a 45-degree
    root fillet; body fit coupon is now a full slice printed like the real body; USB web kept at
    0.8 mm (outer chamfer 0.4); keys 0.2 mm clearance, bezel key 1.4 mm (7 layers). Texts fixed:
    preload advice direction, overhang list, sizes (83/85 mm), plug the cable before closing.
2026-10-19 Driver mode redesign, station search filter sheet, notification read state, gesture bar color, account and station-data cleanups
2026-10-19 Car battery SoC: random hidden SoC, battery-full stop, prepaid surplus credit, charge by autonomy, presentation mode with phone battery; API /soc endpoint and migration; firmware 0.4.0 battery card
2026-10-19 Start a charge without battery fields when the API predates them
2026-10-19 Light-theme wordmark (dark tile, black text) and remove the battery-limit page from the operator
2026-10-19 Station and per-port power limits with shared allocation, energy per charger, limit-in-use notifications and driver power cap; migration c3a9e5f1d204
2026-10-20 USB prototype: Ender-3 PLA deliveries v1-v9, SD packages, test locks, reviews and audits
2026-10-20 Booking flow: remove the variable power warning from the reservation/charge steps
2026-10-20 Charging: skip repeated limits step after the booking wizard, themed battery gauge, no maps row while charging, 1 s sync/poll with TLS keep-alive, fix session events crash
2026-10-20 Dynamic demand pricing computed by ChargeGrid (occupancy, trend, queue, owner peak), owner status and numeric tariff fields, driver sees and locks the price; migration a7c2e9d4b6f1
2026-10-20 Competitor GitHub analysis: repos of the 12 pitch teams and other track teams, risk ranking and gaps
2026-10-20 Driver flows split: station shows Reservar estação (15-min hold) and Carregar agora, no repeated point list or #F notice; short public codes CG-XXXX with migration d1e8f3a2c7b5; API reservation hold 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
2026-10-20 Winning strategy: P0 sandbox Pix payment and live device-confirmed rebalancing, P1 explainable receipt, failure recovery demo, owner margin, overstay; demo script and Q&A
2026-10-20 Charging screen: replace old cards below Encerrar recarga with one compact Detalhes card
2026-10-20 Charging screen: hide the empty offline alert slot so it adds no extra gap
2026-10-20 Driver context API: one-line weather (Open-Meteo current + forecast), earnings source chain, profile sources
    - core: preferences.sources (earnings estimativa/informado/uber, shift auto/informado; legacy profiles inferred, lenient read), weather_summary/rain_note/simulated_weather, EarningsSource + TripHistory aggregator, resolve_earnings (R$ 38/h always labelled estimado), build_context; plan/next-stop expose demand.weather and plan.earnings
    - API: GET /v1/driver/context (shift, demand now and peaks, weather, earnings; read-only, 60/min), same Open-Meteo request now asks current= and weather_code, stale current ignored; PreferencesInput.sources; no migration
2026-10-20 Lean driver mode: nothing to fill in, GPS location, Ajustes collapsed, shorter results
    - screen: car line + read-only 'O app já considera' card (shift and demand, place, weather, earnings) + two buttons; Ajustes always collapsed (30-min shift dropdowns, earnings, lunch/dinner, home charger, Avançado); hidden meals (lanche) and custom durations kept on save; rain switch only without weather
    - never-set shift outside default hours plans from now for 10 h (request only); 422 from an older API retried once without sources
    - location: GPS via flet-geolocator 1.0.0 (Android/iOS only, lazy import, silent when already granted, permission asked only on 'Usar minha localização', 5 s timeouts) -> l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
2026-10-20 Tarifa: single screen (current, base, reason, Detalhes) and time-of-use base tariffs
    - core pricing: stations.pricing["schedule"] = {enabled, intervals:[{start, end, days, prices}]},
    per-connector base per interval, days = day the interval starts (overnight and week wrap),
    overlap/range validation in pt-BR, max 12 intervals; active_interval, base_now,
    connector_price, tariff_reason (Alta demanda / Horário X / Preço normal), merge_rules.
    Legacy peak kept for the 0.6.8 APK but out of the calculation (peak_now always false).
    - API: PUT pricing merges with stored rules and drops foreign connector ids; station rows
    expose current_base_price_per_kwh and demand.reason/reason_label; dyna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
2026-10-20 Core: live power balancing between charging sessions (store load, per-device floor, newest paused first, safe reduce-before-raise steps, pt-BR reasons) and a pure GoodWe HCA G2 Modbus adapter with ci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
2026-10-20 Core economics and receipt: per-session revenue, platform fee, energy cost and margin in cents; versioned explainable receipt contract with pluggable payment, overstay and power sections
2026-10-20 Discontinue Modo motorista: API answers 410 on /v1/driver/*, assistant no longer offers it, app hides the entry; code kept as reference
2026-10-20 Device simulator: SET_POWER with applied_power_w ACK, live power capability and charger in sync, start paused at 0 W, legacy mode, and a GoodWe HCA G2 mode over a labeled simulated Modbus register ba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
2026-10-20 API: live power rebalancing triggered by device syncs and starts (station advisory lock, reduce before raise, unconfirmed reduction retried then stopped, 409 site_power_full), SET_POWER confirmed by 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
2026-10-20 Offline SQL for migration b7d2f4a91c36 (live power rebalance)
2026-10-20 Owner overview, ranking and timeseries sum each session's charged amount rounded to the cent, so dashboard revenue matches receipts and the margin report exactly
2026-10-20 Receipt and owner result endpoints: driver receipt JSON/PDF and history CSV/PDF, station economics settings, owner margin with CSV/PDF from the same aggregation, ReportLab imported lazily, admin tool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
2026-10-20 Stripe test-mode prepaid charging: server-side cap quote, hosted Checkout with card hold, signed webhook plus server-side verification, START only with a confirmed payment, lazy partial capture or re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
2026-10-20 Demo tool for live rebalancing: simulated points next to the physical panel, demo drivers from env, stage commands (car enters/leaves, simulated store load, status)
2026-10-20 Document receipt, owner result and exports in docs/api.md; keep the power chart with its heading and show charged revenue only when overstay adds to it
2026-10-20 Stripe gateway: send form-encoded bodies (httpx rejects tuple lists as data), with no-network wire-format tests; flush the replaced payment before inserting the new one
2026-10-20 Power decisions: read latest by the indexed (station_id, created_at) order
2026-10-20 Occupancy forecast core: durable hourly aggregation, smoothed same-weekday baseline, gradient boosting exported as pure-Python trees (trained offline on labeled synthetic history, used only when it b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
2026-10-20 Forecast API: connector_hourly_stats migration c5f0a7e3d912, idempotent rollup in the daily keepalive, telemetry cleanup waits for the aggregate watermark, owner forecast/occupancy history and driver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
2026-10-20 App: best time to charge card on the station screen, vendor occupancy forecast page with measured accuracy and reviewable tariff suggestions, forecast summary on the energy page, offline demo routes 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
2026-10-20 Best time to charge: with a flat price all day, suggest the quietest hour between 6h and 23h instead of the middle of the night
2026-10-20 Overstay schema: accepted terms, connected interval, billable seconds and fee on charging sessions, one open overstay per point; old rotation rules switched off (migration c8e3a5f2d914)
2026-10-20 Receipt: a settled payment's captured amount drives the total, with the difference to the energy calculation itemized; applied power limits come only from acknowledged changes
2026-10-20 Plug Stripe test payments and acknowledged live power changes into the receipt and owner margin (test environment shown as sandbox, margin revenue = captured minus refunded)
2026-10-20 Overstay API: completed-while-connected opens a confirmed-time overstay in the device sync, fee by accepted terms with gaps and replays never billed, closes on disconnect, reboot or silence; public t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
2026-10-20 Simulator: keep the simulated cable connected after a stop when the START carries overstay terms, unplug by SIGUSR1 or --unplug-after, cable back disconnected after a reboot, terminal line mirrors th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
2026-10-20 Panel firmware 0.7.0: live power (SET_POWER, power_limit_w START), payment kiosk QR and overstay disconnect, with a legacy sync body for older APIs
2026-10-20 Host tests for firmware 0.7.0: SET_POWER incl. 0 W pause, power_limit_w START, sync extensions, overstay, kiosk QR decoding
2026-10-20 App: explainable receipt as a history subpage (price reasons, device-confirmed energy with SIMULADO seal, power curve and changes, payment, overstay, totals, authenticated PDF), Ver recibo on each ca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
2026-10-20 Owner web: client, types and pure helpers for result, site power, payments and overstay (margin cascade, kW formatting with debounce, rotation saved inside the whole pricing rules, authenticated blob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
2026-10-20 Owner web: Resultado page with the revenue-to-margin cascade and CSV/PDF export, station cards for energy cost, site power with the simulated store load, overstay fee and test payments; live panel ev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
2026-10-20 Owner web demo mode: mock data for margin, exports, site power with delayed confirmation, pricing rules, test payments and overstay; README for the new screens
2026-10-20 Driver app: Stripe test-mode prepaid payment instead of the fake card/Pix form, payment_id on start with badge and settlement, live applied power and overstay on the charging screen
    Booking: 'Cartão ou Pix · Stripe (teste)' when GET payments/config is enabled (Saldo only in the
    demo or when the API has no payments). Review creates the payment (POST payments with an
    Idempotency-Key, cap computed by the API) and the new 'Aguardando pagamento' step opens the hosted
    Checkout with UrlLauncher, polls every 2 s, shows the test card and the deadline, and handles
    declined/expired with 'Tentar de novo' (fresh key). The app never collects card data.
    Charging: payment_id and overstay_terms_version in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
2026-10-20 Driver app: overstay grace and fee notifications, 'Taxa de permanência' tariff page with the cap (max_amount), tests for live power and overstay
    Notifications read GET overstays/current (ignored on an older API). The vendor rotation page is
    renamed and gains the Teto field only when the API returns max_amount (zero tolerance allowed);
    the overview summary shows the cap. Tests cover applied power and its states, the reason line,
    the grace countdown with 5 s polling until closed, settlement after overstay, the terms version on
    start (and 409), notifications, the cap field and real-account prepaid without wallet credit.
2026-10-20 Mobile app matches the real API: overstay cap in the fee preview, no tolerance text without accepted terms, receipt reads overstay phase/cap and payment_status, failed power change label; demo mirror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
2026-10-20 Simulator reports firmware 0.7.0 and reads connector.kiosk_url/payment like the panel; tests with real sync shapes and -03:00 timestamps
2026-10-20 Owner web: project presentation at the root, vendor panel moved to /dashboard, new address chargegrid-ffive.vercel.app
    Legacy panel paths (/entrar, /estacoes, ...) redirect to /dashboard/<path>.
2026-10-20 Recarga tab opens the station search directly; remove the Minhas recargas list
    The driver's Recarga tab now routes to stations and stays highlighted there and in its flows
    (booking, charging, reservation detail). The old list is gone: an active reservation or running
    session appears as a compact card at the top of the station search, linking to the detail or to
    charging. Old 'reservations' links without detail (deep links, notifications) resolve to stations;
    back/cancel/reserve/chat/home links point to stations or the reservation detail. Vendor mode and
    station details never fetch the card.
2026-10-20 Demo map: dark variant of the reference raster with its pins and callouts kept, featured pin in the dark-theme blue
2026-10-20 Maps: ChargeGrid light and dark map style from theme tokens; OSM tiles, pins, callout, credit and schematic follow the app theme
    OSM raster tiles are recoloured with Pillow lookup tables (brightest-channel ramp land/block/road/label, soft masks for water, parks and major roads tinted from the brand colours). Callers read theme.is_dark() instead of a fixed dark=False, so the composed-map cache key already separates the variants while raw tiles stay shared.
2026-10-20 Demo account answers the seller power and payment routes: live rebalancing with the core balancing rule, simulated store load, site limit, decision log, payment flags with 402 on unpaid starts, and s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
2026-10-20 Driver payment step: a station that requires prepayment offers only the Stripe test checkout and says why
2026-10-20 Seller app reaches the 0.7.0 panel: Ao vivo with applied power, reason, spot occupancy and alerts; Energia do estabelecimento with site limit, rebalancing switch and debounced simulated store load; P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
2026-10-20 Presentation mode turns Stripe off in the driver app: no payments/config, checkout or payment_id; the 0.6.x simulated Saldo/Pix/Cartão payment with surplus credited to the wallet; a prepay-required s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
2026-10-20 Docs: totem 0.8.0 contract (device kiosk endpoints, sync blocks, visitor pages)
2026-10-20 Station detail back to the reference layout: drop the best time card, the two-button caption and the amenity pills; keep Reservar estação + Carregar agora; refreshed address stays street + number; no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
2026-10-20 API: self-service totem (device kiosk endpoints, point hold, account presentation mode, simulated payment, visitor receipt)
    - profiles.presentation_mode (GET/PATCH /me) picks the totem payment of the owner's stations:
    simulated (local settlement, no Stripe call) or Stripe test (order QR -> hosted Checkout)
    - stations.kiosk_mode; kiosk_orders hold the point (availability occupied/kiosk_in_use,
    app/reservation 409 point_unavailable reason kiosk_in_use; expired hold frees at once)
    - /v1/devices/kiosk/{offer,quote,orders,orders/{id}/pay,cancel,get} reuse quote/locked_terms,
    overstay terms and start_kiosk with the point guest profile
    - sync: connector.kiosk, kiosk_order and authorized.sessi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
2026-10-20 Simulator: --kiosk walks the totem 0.8.0 flow through the device endpoints (both owner modes)
2026-10-20 Firmware 0.8.0: self-service totem (pure kiosk_flow state machine T0-T8/TE, device kiosk requests on the sync TLS connection, additive connector.kiosk/kiosk_order/session.origin reading, provisional 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
2026-10-20 App: account presentation mode synced with /me (owner: server wins), station totem switch with status, kiosk_in_use message
    - Conta: toggling Modo apresentação writes the device and PATCH /me {presentation_mode} (cache of me dropped);
    on sign-in an owner account with the field adopts the server value; driver/old API stay device-only;
    owners see the totem method (Totem: pagamento simulado / Stripe (teste)); failed save reverts for owners
    - Pagamentos do posto: Totem de autoatendimento switch (PATCH kiosk_mode, no optimistic update) with the
    effective method and unavailable reason (payments_unavailable / point_disabled), following the account mode
    - Driver: 409 point_unavailable reason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
2026-10-20 Owner web: totem card on the station (kiosk_mode + status), channel and method in sessions and CSV
    - KioskCard: switch (PATCH kiosk_mode) with the effective method from the account mode (/me) and
    /payments/config (SIMULADO / TESTE / payments_unavailable / point_disabled)
    - Sessions: Canal column (App / QR do painel / Totem) and method; simulated payments never tagged 'teste';
    client CSV gains Canal and Pagamento when the API sends payment
    - Connectors/live: 'Em uso no totem' for kiosk_in_use points
    - Mock: Villa Lobos totem on, CG-003 held by the totem, payment.channel and simulated totem payments,
    /payments/config, ?mock_presentation=1
2026-10-20 API: totem gaps for the seller screens (channel in seller history, kiosk_in_use on /owner/live, Canal/Pagamento in owner exports, kiosk_status on the owner's station)
    - /operator/charging-sessions and /stations/{id}/charging-sessions: payment.channel (app | kiosk_qr | kiosk_totem),
    as in /owner/sessions; driver history unchanged
    - /owner/live: a point held by a totem order is occupied with kiosk_in_use (same rule as availability)
    - Owner exports: sessions CSV/JSON and margin CSV gain Canal/Pagamento at the end (previous columns unchanged),
    margin PDF gains a Canal column, /owner/margin items carry payment_channel/payment_method
    - Owner station payload: kiosk_status {method, label, reason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
2026-10-21 App (seller): station Potência screen in the Tarifa pattern (available power, contracted limit, SIMULATED store load, rebalancing on/off, configured vs effective per connector, limit/type/size and ch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
2026-10-21 Tests: pin the clock in the forecast history test so it no longer fails after ~18:15 São Paulo time
2026-10-21 Owner web: align the station panel with the vendor app (no Ao vivo, Energia do estabelecimento or Pagamentos; Potência section with default contracted limit, SIMULATED store load, rebalancing on by d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
2026-10-21 API: link an external GoodWe HCA G2 charger to a point's screen (connectors.charger_address 1-247, unique per station, migration b7c4e2a9d1f3 + offline SQL); PATCH /connectors/{id} accepts it (owner 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
2026-10-21 Tools: device simulator --hca-link simulates the screen driving an external HCA G2 over SIMULATED Modbus TCP (follows connector.charger_link, reports address/link, --hca-address for old APIs, --hca-o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
2026-10-21 App (seller): Conectores → connector gets 'Carregador GoodWe (endereço)' (1 suggested, save/remove via PATCH charger_address) and the status 'Carregador 1 · GoodWe HCA G2 (simulado) · online/offline'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
2026-10-21 Owner web: charger address field and link status per connector on the station page, mock with the same validation/uniqueness and one linked charger
2026-10-21 Simulated GoodWe HCA G2 charger firmware for an ESP32 DevKit (relay on GPIO 13)
    New PlatformIO project firmware/goodwe-hca-sim (esp32dev, espressif32@6.9.0): Modbus TCP server on port 502, unit id = charger address (default 1), with the HCA G2 register map of chargegrid_core (10029 in 0.1 kW, 14-70 for GW7K-HCA-20; 10060 1 = off / 2 = on; 10032; 10015/10017/10058/10059 read-only). The relay closes only with 10060 = 2 and 10029 >= 14; it opens with 10060 = 1, 10029 below the minimum (pause), the 15 s master watchdog (status 5, 10060 back to 1, cleared by the next master write), reset and boot. 10015 and the energy are SIMULATED and labelled; energy lives in a documented extension outside the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
2026-10-21 Panel: optional Modbus TCP link to the external HCA G2 charger (connector.charger_link)
    When the sync carries connector.charger_link, the panel resolves cg-hca-<addr>.local (or the IP, or a fixed IP set with CG_CHARGER_IP) and becomes the Modbus master of the simulated charger: START writes 10032 = 0 once, 10029 only when it changes and 10060 = 2; SET_POWER writes 10029 or pauses with 10060 = 1 below 1.4 kW; STOP writes 10060 = 1. The ACK is applied only after reading back 10029/10060/10015..10017; otherwise failed with charger_offline, charger_rejected or charger_readback_mismatch (a failed START leaves no local session and switches the charger off). Power and energy come from 10015 read ev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
2026-10-21 Docs: simulated HCA G2 charger guide, charger_link/charger sync contract and adapter note
    docs/carregador-hca-simulado.md covers the ESP32 DevKit + relay wiring (GPIO 13, separate relay supply, phase through COM/NO with a 127/220 V safety warning), flashing, Wi-Fi/address over serial, testing from a computer with mbpoll or pymodbus (or the host server without a board), linking the charger in the app, how the panel maps commands to registers and the remaining hardware checks. esp32-protocol.md gains the charger_link (response) and charger (body) section; adaptador-hca-g2.md points to the hardware simulator and lists how it differs from the real map.
2026-10-21 API: every connector is a GoodWe HCA G2 charger (charger_address NOT NULL, next free address per station)
    Migration c5e9a2d7f4b1 (+ offline SQL): backfills connectors without an address with the free addresses of their station in public_code/id order (never colliding with addresses already set), makes connectors.charger_address NOT NULL and adds the BEFORE INSERT trigger connector_next_charger_address so any insert without an address (ORM, factory SQL) gets the lowest free address of the station; the same trigger is attached to the metadata for the test schema. Downgrade drops the trigger and makes the column nullable again, keeping the addresses. PATCH /connectors/{id} refuses charger_addre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
2026-10-21 Tools: device simulator follows every connector's charger_link and picks the mode at START (online charger: simulated Modbus; offline: the screen's simulation until the end)
    The simulator always reads connector.charger_link and reports address/link; without a charger answering it declares its own simulation (simulated_bench limits) with link offline. --hca-link now means a simulated HCA charger answers at the address. A charge started on the charger stops with charger_unreachable when it disappears; a simulated charge never switches mode, and a charger that appears later is used by the next START.
2026-10-21 Panel: charge through the GoodWe charger when it is online at START, otherwise with the screen's internal simulation
    Every connector now carries connector.charger_link. The panel keeps reading the charger (about 1 s online, 5 s offline with mDNS retried every 15 s, 500 ms timeout) and decides the session mode at START: charger online (a link configured in the same sync is read once first) -> Modbus exactly as before (ACK after readback, safe device_fault stop if it disappears); offline, or no answer right at START -> the internal relay/energy simulation with the bench limits, reported as charger {esp32_bench, address, link offline} and source simulated. A session ends in the mode it started;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
2026-10-21 App (seller): every connector shows its GoodWe charger address; no optional external charger or remove action
    Conectores (list and connector) show "Carregador GoodWe · endereço N · online" or "… · aguardando carregador (simulação da tela)"; the connector screen edits the address in the same field/button pattern, never empty (inline error, no request) and shows API refusals under the field. Demo: every point gets the next free address of its station (1..N), new points included, PATCH refuses null (422) and taken addresses (409), and the simulated screens report their own simulation with link offline.
2026-10-21 Owner web: connector cards show the GoodWe charger address and link, no remove action; mock gives every connector 1..N
    The address field can't be emptied (inline validation with the API messages, no request); the status line matches the app and the core. The mock assigns the lowest free address per station in creation order, validates PATCH like the API (null/out of range 422, taken 409, same value no-op) and reports the screen's simulation with link offline.
2026-10-21 Docs: each connector is a GoodWe charger (address = the ESP's CG_ADDR, same Wi-Fi as the screen), Modbus vs screen simulation at START, migration c5e9a2d7f4b1
2026-10-21 HCA G2 simulated charger: esp32s3 env (N16R8, UART bridge, relay on GPIO 13, no LED)
2026-10-21 API: a station screen commands many GoodWe chargers; availability per charger (charger_offline), add-charger route, START failure reason, migration d3f8a1c6e2b7
    - Station = the screen (device with a key); every connector is a charger. devices.parent_device_id
    links an extra charger (own device row: sessions, commands and point state stay per connector,
    no usable key) to the screen. Migration d3f8a1c6e2b7 (SQL in apps/api/sql), downgrade revokes them.
    - Addressed sync: the screen posts the same /devices/sync with charger_address to sync on behalf
    of an extra charger; the screen's sync response lists them in `chargers`. Unknown address -> 409
    charger_not_linked; credentials/factory res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
2026-10-21 Panel firmware: strict START on the GoodWe charger (no screen-simulation fallback), robust charger link, sync before Modbus, device_reboot, extra chargers per screen (multi_charger_v1)
    Real test (session 425336ed, CG-4HPF): the screen accepted START with the link offline for 1.5 min
    and charged on its internal simulation (charger showed "mestre=nunca"); in the syncs the link was
    online a few minutes after each screen boot and stayed offline until the next reboot.
    - With charger_link every charge runs on the charger: START tries it now (2 short attempts, the
    2nd reconnects and resolves at once via prepareUrgent) and only ACKs applied after the readback;
    no answer -> ACK failed charger_of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
2026-10-21 App: "Carregadores" (station = screen, chargers inside), add charger, concise charger screen, driver sees "Carregador offline", demo chargers online
    - Seller: "Conectores" -> "Carregadores" (API entity stays connector); station screen status
    ("Telas da estação") separate from each charger's status (Online/Offline/Aguardando a tela).
    - "Adicionar carregador" calls POST /connectors/{id}/chargers on the screen's point (inactive, next
    address, CG_ADDR hint; screen_required/charger_address_full messages).
    - Charger screen: top part until "Salvar alterações" unchanged; below, "Carregador e tela" with the
    charger card (address + Salvar, last reading, measured power) and the screen card (o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
2026-10-21 Owner web: station = screen with its own online status, "Carregadores" with per-charger status, add charger, concise charger card
    - Station header and "Dados da estação" show the screen(s) online/offline; a charger offline is
    shown as "Estação online · carregador X offline" (only that point is unavailable).
    - "Adicionar carregador" (POST /connectors/{id}/chargers on the screen's point) with the new address,
    inactive, CG_ADDR hint and 409 messages.
    - Charger card: status badge, address (saved on its own), connector type, nominal power and limit,
    tariff, max duration, published switch, link line (online/offline, last reading, measured power)
    and the screen link (this point is the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
2026-10-21 Docs: station = screen commanding many chargers, strict START (charger_offline), addressed sync, per-charger availability, root cause of the real-test bug
2026-10-21 fix(owner-web): count available chargers in station summary
    Preserve the station screen status while showing the actual free charger count, including when every charger is offline.
2026-10-21 fix(firmware): retain charger stops until readback confirms
    Keep an additional charger slot and its transport endpoint while a physical STOP is pending, even after API session reconciliation. Confirm stop retries by reading power and run state before clearing the pending flag, and reject new START commands until that confirmation. Cover failed writes, interrupted readback, endpoint changes, removal and reuse with host regressions.
2026-10-21 fix(api): guard screen lifecycle across all chargers
    Serialize screen resets and credential changes with child charger operations. Reject lifecycle changes while dependent sessions or reservations are active, recheck reset ACKs, and retire idle children with their screen without orphaning active devices. Preserve normal reserved START while rejecting offline screens.
2026-10-21 fix(firmware): recover charger links without restarting central
    Give charger polling a turn even when API sync is overdue, tick every session between blocking requests, and schedule periodic/retry deadlines from batch completion. Publish link transitions without overriding error backoff or repeatedly retrying failed child syncs. Refresh transport timestamps, rediscover cached IPs after transport failures, and bound both TLS handshakes while preserving strict START and confirmed pending STOP behavior. Add host regressions against the real HTTP/Modbus implementations, fake clocks, recovery and rollover.
2026-10-21 fix: keep charger telemetry fresh and central maintenance in station data
2026-10-22 Totem 0.9.4: 'Iniciar recarga' aligned with the code card, kiosk screens share the panel header/margins, live charge back to the panel layout (battery card, Encerrar, metric row), confirm stop, multi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
2026-10-22 API: DELETE /v1/connectors/{id} removes an extra charger (removed_at, address freed, migration e2c7a9d4f6b3), CORS allows DELETE, kiosk accounts and screen commands for many chargers
2026-10-22 App: remove charger from a station, Editar carregador with each ID once and Salvar alterações last, Dados da estação per central, compact live charge details, wallet refresh survives API errors, vect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
2026-10-22 Pitch videos: final flow scripts, AI chat option, pause/resume drops stale frames, lighter totem renders, 3 recording slots
2026-10-22 fix(app): vincular central com uma ação só e câmera no lugar do conteúdo
    A tela "Vincular Central" mostrava "Escanear QR Code" e, abaixo, um bloco
    "Inserir o Código Privado do QR" com campo e botão próprios. Para quem usa,
    eram duas opções para a mesma coisa: ler o QR só preenche aquele campo, e as
    duas terminam no mesmo POST ownership/claim. A câmera também abria como uma
    seção nova embaixo, com todo o texto ainda na tela.
    Agora a ação é uma só, "Escanear QR Code". A câmera ocupa o lugar do cartão
    explicativo e dos botões, com "Cancelar"; o "<" do título fecha a câmera
    antes de sair da tela. Depois da leitura, "Vincular ponto à minha conta"
    vira a ação principal: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
2026-10-22 fix(api): simulate the car battery on every kiosk/totem charge
    Charges started at the totem (guest or logged in) or through the panel QR
    went through payments.start_kiosk, which only sent soc_percent/battery_kwh
    when the quote carried a saved car AND a previous session SoC. Guests,
    accounts without a car and accounts without SoC history therefore started
    with soc_source=None: no derived SoC in the API, no battery card on the
    totem live screen (socPercent -1), nothing in the app or receipt - unlike
    app starts, which always send a simulated battery.
    kiosk_battery(payment) now always sends soc_source=simulated with:
    - battery: the account's saved car, else the app default (BYD Dolphin 44.9 kWh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
2026-10-22 fix(app): coherent order and cards in Dados da estação
    The seller said that below Status the page looked random: the totem switch
    (a station-wide setting, same control as Status) sat orphaned at the bottom,
    after the central cards and a large add button, and the central maintenance
    card and the status-only "Central da estação" card had different headers.
    - Order below Status: Totem de autoatendimento, then the "Centrais da
    estação" section (label + hint), one card per central, and the
    add/vincular central action last.
    - Each central card reads top to bottom: Central CODE + pill, contact line,
    ID, messages, credential actions, then restore status and the restore box
    (destructiv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
2026-10-22 feat(app): single charge-detail screen replaces the history overview and the receipt page
    Tapping a charge in Histórico opened a raw pre-redesign panel inline, and "Ver
    recibo" opened a second, text-heavy receipt page with much of the same data.
    Both flows now lead to one redesigned screen, history?session=<id>
    (screens/charge_detail.py). receipt=<id> stays as an alias, so old links still work.
    - Summary card at the top (station, status, energy/total/time, date, number,
    badges), then Custos, Sessão e bateria (battery kWh + SoC, speed, limits,
    device confirmation, power chart/changes), Pagamento (+ overstay), Estação e
    carregador, and Mais detalhes (collapsed timeline, AI summary,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
2026-10-22 fix(booking): show charge maxima upfront and hide demand surcharge from drivers
    Drivers only learned the connector limit after tapping "Próximo Passo"
    ("permite recargas de até 120 minutos"), the standard booking amount step
    had none of the quick chips the "Iniciar outra recarga" flow has, and the
    peak/demand multiplier (seller-only information) was shown in the booking,
    in the live charge details, in the point summary and on the totem review.
    - core: charge_plan.charge_maxima computes per-mode maxima (point time
    limit; energy capped by power x time and by the car's free battery;
    value at the final tariff rounded down so it fits the time limit; km
    from the car consumption). Shared b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
2026-10-22 feat(app): white showcase stations in presentation mode, profile car on home, SQL to retire "ChargeGrid fiap"
    Presentation mode (device toggle) now adds ten display-only stations across
    São Paulo to the Recarga map and list, after the real ones and without the
    search radius (the pitch can happen anywhere in the city), respecting the
    other filters. They live only in the app (services/showcase_stations.py,
    internal ids demo-sp-*): no database rows, no API change, the real station is
    never touched. They look like ordinary stations with normal tariffs and a
    WHITE pin; opening one builds the detail locally (no API call, no polling)
    and shows "Indisponível no momento" instead of Reservar/Carrega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
2026-10-22 feat(coupons): visible coupon management with status, filters and usage
    "Gerenciar cupons" was pushed below the first screen of Suas Estações (behind
    a 560px spacer), so sellers barely found it. It now sits right after
    "Adicionar nova estação"; only the AI insights stay below the fold.
    The coupon screens move to the redesign kit: summary (ativos, expirados,
    inativos, usos, desconto concedido aprox.), Todos/Ativos/Expirados/Inativos
    filter, one card per coupon with status pill, validity, scope and usage, and
    Editar / Desativar / Reativar actions (no delete; reactivating an expired
    coupon opens the editor because the API requires a new validity). The form
    gains 5/10/15/20% and 7/30/90-day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
2026-10-22 feat(ai): assistant knows the user's car and account, plus owner analytics tools
    Why: asked "quanto custa para carregar de 20% a 80%", the assistant asked for the
    battery size even though the account has a registered car. estimate_charge needed
    battery_kwh from the model, and the only reader of the car (plan_driver_shift) is off
    since the driver mode was discontinued. Owners only had a coarse 30-day indicator tool.
    - Account card in the system prompt (core ai/context.py, built server-side from the
    same source as the tools): registered car from /me/vehicle (isolated vehicle_for),
    battery level sent by the app ("nível estimado pelo app") or the last charge's end
    SoC, wallet, month, las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
2026-10-22 feat(coupons): driver enters a coupon code in the booking review
    Drivers had no way to use a coupon since 9247db1 hid the field, even though
    the API applies coupon_code on payment and start. The user asked to bring it
    back in the "Revisar Dados" step.
    - API: POST /v1/coupons/check {code, connector_id} validates with the same
    find_coupon rule as start, without paying or starting, and is limited to 10
    attempts per driver per 5 minutes so codes cannot be brute-forced.
    - Booking review: "Cupom de desconto" block (code + Aplicar, or the applied
    coupon with Remover). Time/autonomy show the full total struck through and
    the discounted one; the discount applies to energy only, the reservati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
2026-10-22 fix(costs): audit fixes and monthly rent per central deducted from the owner's statement
    Why: the cost audit found money paths that disagreed or overcharged, and the platform now
    charges each seller a monthly rent per linked central (screen), deducted from the payout.
    Cost fixes
    - B1 billing.settle_amounts: energy above the accepted energy cap is waived even when the
    authorization also reserves the overstay fee (driver paid R$ 10,40 on a R$ 10,00 cap).
    - B2 economics: payment_adjustment (captured - energy - overstay) closes gross -> charged in
    PDF, owner-web and app.
    - B3 app result card labelled the charged revenue as "Receita bruta"; now "Receita cobrada"
    and the detailed cascade st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
2026-10-22 feat(power): Limites em um só lugar com margem ESTIMADA da loja
    Sem medidor, a loja deixa de ser simulada como se fosse ao vivo: o dono
    informa uma estimativa fixa (consumo mínimo e pico, padrão 14–22 kW) e o
    pico estimado fica reservado o tempo todo, por cima de tudo. Os carregadores
    recebem min(máximo dos carregadores, contratado − pico estimado), também com
    o rebalanceamento desligado (dividido no início da recarga).
    - core: site_load vira regra de estimativa fixa (padrões, limite padrão pelo
    pico, validação, orçamento); balancing usa store_reserve_kw e textos novos
    - API: stations.store_min_kw/store_peak_kw (migração d8b3f6a2c5e7 com
    preenchimento a partir do tipo/p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
2026-10-22 fix(power): migração d8b3f6a2c5e7 depois de c4f1a8e6d2b9 (aluguel das centrais)
    O main ganhou c4f1a8e6d2b9 sobre e2c7a9d4f6b3; a margem estimada da loja passa
    a vir depois dela para manter um único head. SQL offline regenerado.
2026-10-22 fix(ui): remove simulation/demo/test wording across app, API, core, panel and totem
    - app: neutral receipt/charge detail (no CONTA DEMO/SIMULADO/TESTE badges), plain receipt PDF
    ('Documento sem valor fiscal'), neutral demo-account copy, payment texts without '(teste)'
    - core/API: billing/receipt/analytics/economics/link/weather labels and payment pages without test marks
    - remove scattered 'Fale com o ChatBot' shortcuts (chat tab stays)
    - seller home 'Escanear QR Code' opens the claim camera directly (scan=True)
    - chat 'Ver detalhes da recarga' opens history?session= for finished sessions
    - firmware 0.9.5: totem/panel strings without TESTE/SIMULADO/modo apresentacao
    - tests: forbidden-word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
2026-10-22 fix(profile): remove the Pix key field
    It was stored only on the phone and nothing ever read it (the API has no
    payout key), so it only confused sellers and drivers.
2026-10-22 feat(app): real photos for every car preset with Wikimedia credits
    Each driver preset now shows a photo of its own model in the same front
    three-quarter view as the Dolphin (1168x702, background removed, plates
    blurred, palette PNG). Custom cars keep the neutral hatch silhouette;
    unknown presets fall back to the Dolphin. Credits in CREDITS.md and in
    Conta > Créditos das imagens.
2026-10-22 feat(firmware): 0.9.6 rotates the totem screen 180 degrees
    The panel is mounted upside down in the case. LVGL renders rotated through the
    port's own 180-degree path (3 framebuffers in PSRAM) and the port mirrors touch
    on X and Y, so taps keep landing on the right control. CG_SCREEN captures are
    turned back upright.
2026-10-22 Pitch videos: re-recorded on the current UI; reduced motion (no fade blink), frame-size normalisation, recording watchdog, HMR-free painel server, check_flicker.py
2026-10-22 fix(ownership): relinking a restored central reuses its charger address
    After a factory restore the central's old points stayed in the station,
    inactive but still holding GoodWe addresses 1 and 2. Linking the central back
    gave its new point the next free address (3), so it polled a charger that
    does not exist and stayed 'carregador indisponivel' forever. On claim into a
    station, those leftovers (inactive, every device revoked) now become history
    and free their addresses; the new point takes the lowest one and inherits the
    old point's settings.
2026-10-22 Landing: context section (driver and seller pains, what ChargeGrid delivers), system overview strip under the hero, FFIVE team with LinkedIn links
2026-10-22 feat(stations): remove a whole station (DELETE /v1/stations/{id})
    Sellers had no way to close a station: deactivating kept it in their lists and the
    owner panel, and could be undone. Removing now takes the station out of every list
    (driver discovery/map/search, "Suas Estações", owner panel pickers and counts, AI tools,
    coupons, forecast) while sessions, receipts, payments and margin reports stay intact.
    API: migration a9d4e2b7c1f6 adds stations.removed_at (offline SQL in
    sql/migracao_a9d4e2b7c1f6.sql). DELETE locks screen groups -> station -> connectors ->
    devices like the station PATCH; refuses 409 station_busy (active session, reservation or
    open totem order) and 409 central_online (res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
2026-10-22 fix(devices): a removed station's central gets back to the claim QR
    Removing a station while its central looked offline revoked the central's
    key, leaving the totem stuck on 'Chave invalida' with no way to relink it.
    The sync route now also accepts a screen revoked together with its removed
    station (and never factory-reset since); it only delivers FACTORY_RESET to
    it, and on the ack registers the new key and claim QR as an unowned factory
    point, exactly like Restaurar. Every other revoked key is still rejected.
2026-10-22 fix(devices): confirm the rescued factory reset so the central switches identity
    The firmware only adopts its new key and claim QR when the sync response
    carries factory_reset_confirmed, as in the normal Restaurar flow.
2026-10-22 feat: presentation-mode claim names the station Lab-ChargeGrid FIAP; firmware 0.9.7 gets the clock over HTTP when NTP is blocked
    A central linked by an account in presentation mode now arrives as
    'Lab-ChargeGrid FIAP', Av. Lins de Vasconcelos, 1222 instead of the factory
    placeholder. Firmware 0.9.7: networks that block NTP (phone hotspot) left the
    central without a clock, so it never synced; it now reads the time from an
    HTTP Date header until NTP answers.
2026-10-24 docs: README final da entrega (arquitetura, desafio GoodWe, resultados, sustentabilidade)
    Reescreve o README com os itens pedidos na entrega: título e equipe,
    arquitetura final com Modbus TCP entre totem e carregador HCA G2 emulado,
    fluxo de recarga, circuito da bancada, alinhamento ao desafio e à disciplina,
    resultados quantitativos e qualitativos, avaliação crítica e referências.
    Adiciona fotos reais da bancada e telas do app gravadas em 23/10/2026.
